dcwaiot/KU-WPT/2023/BOM List/ใบเสร็จ/ใบภาษี Coil.jpg

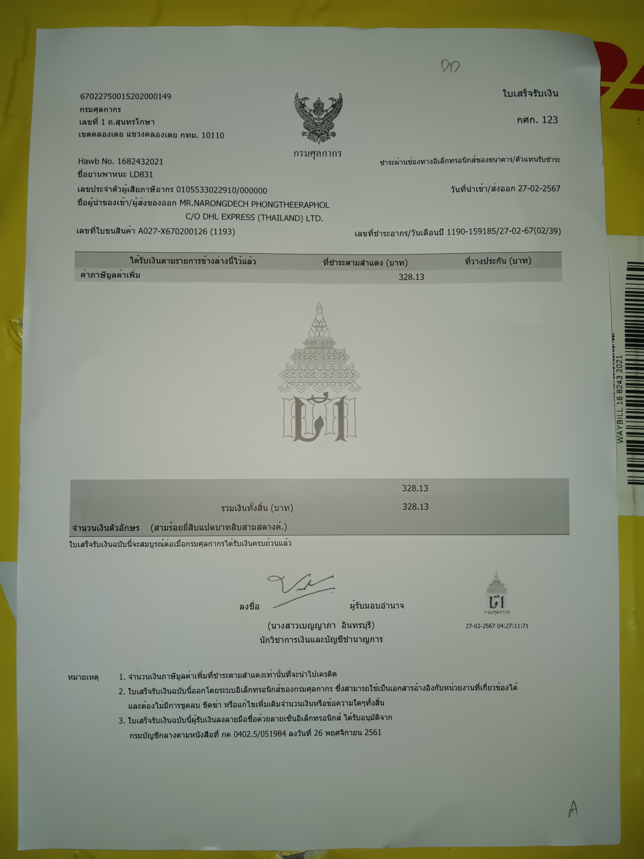
2023/BOM List/ใบเสร็จ/ใบภาษี Coil.jpg
