dcwaiot/KU-WPT/2022/data/VDO, Picture/Measure_Vdc.JPG

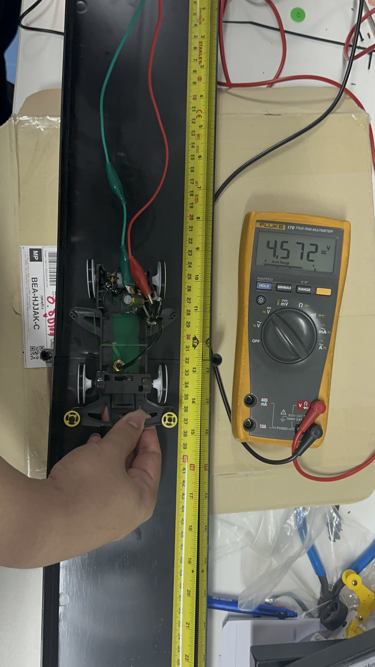
2022/data/VDO, Picture/Measure_Vdc.JPG
