dcwaiot/KU-WPT/2022/readme.md

This folder is for information for 2022 academic year.
แหล่งจัดเก็บข้อมูลที่เกี่ยวข้องของโครงงานวิศวกรรมไฟฟ้า KU-WPT ปี 2022
ประกอบไปด้วย 7 โฟลเดอร์ ดังนี้
1. ไฟล์สกุล s1p 1 Connector ได้มาจากการ export ชิ้นงาน ใน Sonnet Software
2. ไฟล์สกุล s2p 2 Connector ได้มาจากการ export ชิ้นงาน ใน Sonnet Software
3. Easyeda > Attenuator + TX Coil + RX Coil
4. Report + Poster + Summary
5. วิธีการลงโปรแกรม Sonnet + TX Coil 1 ชิ้น + TX Coil ต่อกัน 2 ชิ้น
6. VDO + Picture
7. ขั้นตอนการจัดทำ Coil + Attenuator และ BOM List
