dcwaiot/KU-WPT/2023/readme.md

# Wireless Power Transfer 2023
สำหรับใส่ข้อมูลทั้งหมดของ Senior Project ปีการศึกษา 2566 (2023)
