dcwaiot/KU-WPT/2023/Report,poster,summary,presentation/EE2023DCW-02_poster.pdf

# พลวัต

วั

# ของรถยนต์พ

ต์

ลัง
ลั

# งานไฟฟ้า

ฟ้ | ไร้สร้

# ายขนาดเล็ก

# ล็ ในเชิง

ชิ

วิศวิ

# วกรรมไฟฟ้า

ฟ้

# The Dynamic of Mini Wireless Electric Energy Car in Electrical Engineering

# ภาควิช

วิ

# าวิศ

วิ

# วกรรมไฟฟ้า

ฟ้

# คณะวิศ

วิ

# วกรรมศาสตร์ มหาวิท

วิ

# ยาลัย

ลั

# เกษตรศาสตร์

# กรวิชวิ ญ์ รัง รั สาคร, ศุภ

ศุ

# กร ธัญ

ธั

# ญหาญ, ศุภ

ศุ

# กร พงษ์ธีร

ธี

# ะพล และ ผศ.ดร.เด่น

ด่

ชัย
ชั

# วรเศวต

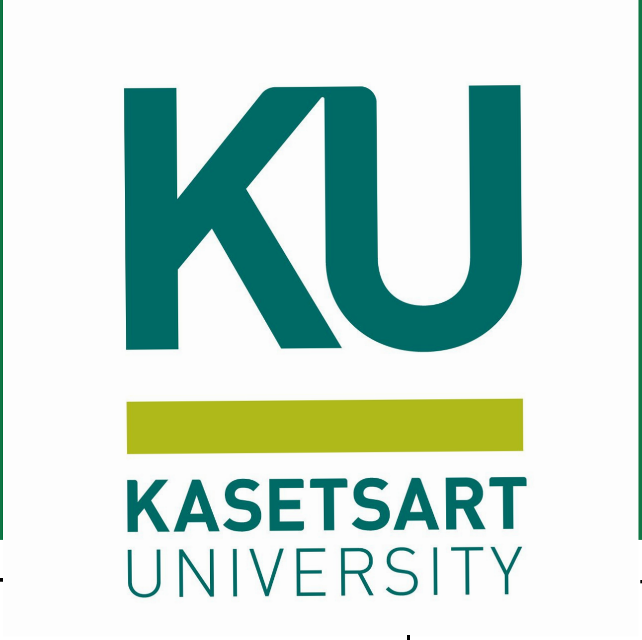
[picture p25: figure]

การคิดค้นรถยนต์พลังงานไฟฟ้า
ฟ้

เพื่อ
พื่

แก้ไขปัญหาขาดแคลนน้ำ มันมั และสภาวะโลกร้อ
ร้

น ได้เ
ด้

ริ่มริ่ ต้นจากปัญหาการเผาไหม้เ
ม้

ชื้อ
ชื้

เพลิงที่ส่ง
ส่

ผลให้ค
ห้

วันวั ไอเสีย
สี

ออกมาจากท่อของรถยนต์ส่่ง

ส่่
ปัจจุบันบั มีก
มี
ารพัฒพั | นารถยนต์พลังงานไฟฟ้า
ฟ้ | โดย
ใช้ร
ช้

ะบบรับรั -ส่ง
ส่

พลังงานไฟฟ้า
ฟ้

แบบไร้ส
ร้

าย เพื่อ

พื่ | ประหยัดยั | เวลาในการชาร์จร์ | ประจุไฟฟ้า
ฟ้ | โครงงานวิศวิ | วกรรมไฟฟ้า
ฟ้

ชื่อ
ชื่ "Demonstration of Resonant Wireless Power Transfer using Toy Racing Cars and Tracks" โดย Wisessri และ Promsatarporn (2022) มีข้
| | มี อ ข้
จำ กัดที่ยังยั | ไม่ส
| | | ม่
ามารถขับขั | เคลื่อนได้บ
ด้

นเส้น
ส้

ทางโค้งและยังยั ไม่มี
ม่

ค
มี
วามเสถียรและสมรรถนะในการขับขั | เคลื่อนของรถยนต์ไฟฟ้า
ฟ้ | ไร้ส
ร้

ายอย่า
ย่

งเพีย
พี

งพอ
โครงงานนี้ส

นี้
ามารถนำ ไปประยุกต์ใช้ใช้

นระบบคมนาคมขนส่ง

| | ส่ เพื่อ พื่
| | ชาร์จร์ | ประจุไฟฟ้า
ฟ้ | ให้ย
ห้
านพาหนะในขณะที่ยานพาหนะกำ ลังขับขั | เคลื่อนอยู่ โดยไม่ต้
ม่ | ต้
องจอดยานพาหนะหยุดนิ่งนิ่ | มีปมี
ระโยชน์ต่น์ | ต่

อยานพาหนะที่ต้องการใช้ง
ช้

านอย่า
ย่

งเร่ง
ร่

ด่ว
ด่

น เช่น
ช่

รถพยาบาลหรือ
รื

รถไฟฟ้า
| ฟ้

ขนส่ง

| | ส่ มวลชนในช่ว ช่ | งเวลาที่มีก มี ารเคลื่อนย้า
ย้

ยมวลคนมากๆ เช่น
ช่

ช่ว
ช่

งเวลาเช้า
ช้

และเย็น
ย็
ที่มีผู้
มี | โผู้ดยสารจำ นวนมากเดินดิ | ทางไปทำ งานหรือ
รื

กลับบ้า
บ้

นที่พักพั ได้ส
ด้

ะดวกขึ้น
ขึ้

วัต
วั

ถุป

ถุ

ระสงค์
สามารถส่ง
ส่

กำ ลังไฟฟ้า
ฟ้

แบบไร้ส
ร้

ายได้อ
ด้

ย่า
ย่
งมีปมี | ระสิทสิ | ธิภธิ | าพ
โมเดลรถสามารถเคลื่อนที่ได้อ
ด้

ย่า
ย่

งเสถียรและสามารถเคลื่อนที่ตามทิศทางของรางได้
สามารถออกแบบอุปกรณ์หณ์ | รือรื | ชิ้นชิ้ | ส่ว
ส่
นต่างๆเพื่อพื่ | นำ ไปประยุกต์ใช้ใช้
นงานที่ระดับดั | ใหญ่ขึ้
ญ่ | ขึ้
น
| | ขึ้ | ได้
ขอบเขตของโครงงาน
โครงงานนี้จ

นี้
ะแสดงให้เ
ห้

ห็น
ห็

ว่า
ว่

การส่ง
ส่

กำ ลังไฟฟ้า
ฟ้

แบบไร้ส
ร้

ายสามารถทำ ได้จ
ด้
ริงริ | และมีปมี | ระสิทสิ | ธิภธิ | าพ โดยใช้ข ช้ ดลวด
เป็นอุปกรณ์ใณ์ | นการรับรั | -ส่ง
ส่

กำ ลังไฟฟ้า
ฟ้

ซึ่ง

ซึ่ โมเดลรถจะเคลื่อนที่ได้อ
ด้

ย่า
ย่

งเสถียรและสามารถเคลื่อนที่ตาม ทิศทางของรางได้ โดยตัววงจรของโครงงานครั้งรั้ นี้จ

นี้
ะแสดงให้เ
ห้

ห็น
ห็
ดังดั | ภาพ

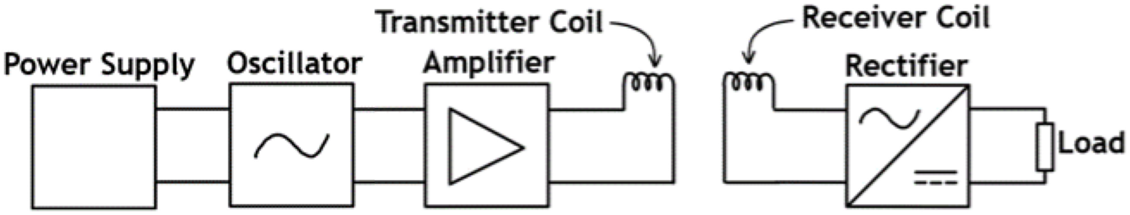
[picture p26: figure]

วิธีวิ | ก
ธี
ารดำ เนินนิ | โครงงาน

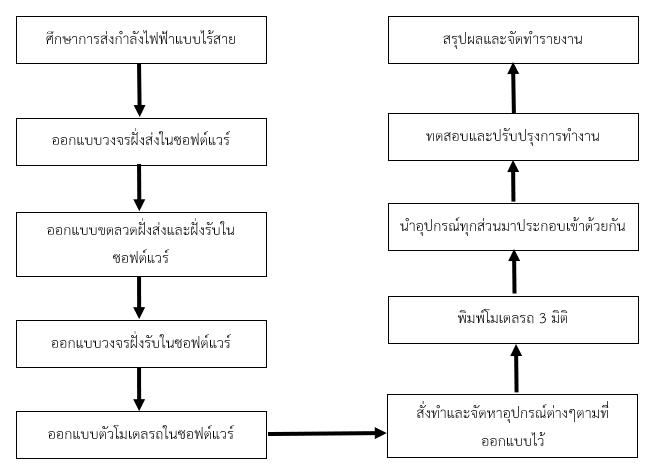
[picture p27: figure]

ผลการดำ เนินนิ | โครงงาน

ทฤษฎีที่เกี่ยวข้อ
ข้

ง
ในโครงงานนี้ไนี้
ด้ใด้

ช้ท
ช้

ฤษฎีต่างๆ ในการออกแบบระบบส่ง
ส่

กำ ลังไฟฟ้า
ฟ้

แบบไร้ส
ร้

ายซึ่ง

ซึ่ | ใช้ข
ช้

ดลวดฝั่งส่ง
ส่

หรือรื
Transmitter Coil ส่ง
ส่ | ไปยังยั | ขดลวดฝั่งรับรั | หรือรื | Receiver Coil แบบไร้ส ร้ ายที่ความถี่ 13.56MHz โดยใช้ท
ช้

ฤษฎี

ต่างๆ ดังดั นี้
ทฤษฎีคลื่นแม่เ
ม่

หล็กไฟฟ้า
| ฟ้
จากกฎของแอมแปร์ เมื่อมื่ | มีกมี | ระแสไฟฟ้า
ฟ้ | ไหลในขดลวดจะทำ ให้เ
| | | | ห้ กิดสนามแม่เ ม่

หล็กขึ้น

ขึ้ โดยรอบขดลวด และหากสนาม แม่เ
ม่

หล็กนี้พุ่

นี้

พุ่

ง
พุ่

ผ่า
ผ่

นพื้นพื้ ที่หน้า
น้

ตัดของขดลวดอีกชุดหนึ่ง
นึ่

จะทำ ให้เ
ห้

กิดการเปลี่ยนของฟลักซ์แซ์ ม่เ
ม่

หล็ก (ฟลักซ์แซ์ ม่เ
ม่

หล็ก
คือปริมริ าณสนามแม่เ
ม่
หล็กในพื้นพื้ | ที่พื้นพื้ | ที่หนึ่ง
นึ่ | ) ซึ่ง
ซึ่

จะทำ ให้เ
ห้

กิดสนามไฟฟ้า
ฟ้

ขึ้น

ขึ้ | ในขดลวดชุดนั้นนั้ | ๆ ในขดลวดชุดดังดั | กล่าว
จะมีอิมี อิเล็กตรอนอยู่ เมื่อมื่ | เกิดสนามไฟฟ้า
ฟ้

จะทำ ให้เ
ห้

กิดแรงไฟฟ้า
ฟ้
กระทำ กับอิเล็กตรอนภายในขดลวด ดังดั | นั้นนั้ | อิเล็กตรอน
จะเกิดการเคลื่อนที่ไปตามขดลวด จึง
จึ

ทำ ให้เ
ห้

กิดกระแสไฟฟ้า
ฟ้

ขึ้น

ขึ้ | ในขดลวดชุดนั้นนั้ | ๆ

คุณ

คุ

สมบัติบั ติ ท่อนำ คลื่น
ทฤษฎี SMA
ขดลวด (Coil)

คุณ

คุ

สมบัติบั ติทางวัสวั ดุข

ดุ

อง FR4 PCB
วงจรเรียรี งกระแส (Rectifier Circuit)

Transmitter Coil (TX Coil) - ขดลวดฝั่งส่ง

ส่ Receiver Coil (RX Coil) - ขดลวดฝั่งรับรั

วัด
วั

ค่าความต้านทานของขดลวด

มีวัมี | ตวั | ถุป

ถุ

ระสงค์เพื่อพื่ | หาค่า ความต้านทานจินจิ | ตภาพเหนี่ยวนำ เพราะ Coil มีคุมี | ณ

คุ

สมบัติบั ติเป็น
ป็

ขดลวดเหนี่ย

นี่
วนำ เพื่อพื่
ต้องการให้ไห้

ด้ก
ด้

ระแสไฟฟ้า

ฟ้ ในวงจรสูง

สู

สุด

สุ

จึง
จึ
ต้องการปรับรั | ให้ค่
ห้ | ค่
าความต้านทานจินจิ | ตภาพของอุปกรณ์เณ์ | ป็น
ป็

ศูนย์
โดยการนำ ตัวเก็บประจุไฟฟ้า
ฟ้
มาต่ออนุกรม โดยที่ตัวเก็บประจุมีคมี | วามต้านทานจินจิ | ตภาพเป็น
ป็
จำ นวนจินจิ | ตภาพลบ
เรียรี | กว่า
ว่ | Series Resonance Effect

อุปกรณ์ที่ณ์ ที่ใช้ใช้
นการวัดวั | ค่า เรียรี | กว่า
ว่ | Vector Network Analyzer

ซึ่ง
ซึ่

จะแสดงผลลัพธ์ใธ์ ห้เ
ห้

ห็น

ห็ ในรูป

รู

แบบ Smith Chart หากจุดไปแสดงที่ตำ แหน่งซ้า
ซ้

ยสุด

สุ

คือ Short Circuit
หากจุดไปแสดงที่ตำ แหน่งขวาสุด

สุ

คือ Open Circuit หากจุดอยู่ใยู่

นซีกซี | บนของกราฟ อุปกรณ์จณ์ | ะมีคุมี | ณ

คุ

สมบัติบั ติ
เป็น
ป็
ขดลวดเหนี่ยวนำ | แต่หากจุดอยู่ใยู่
นซีกซี | ล่างของกราฟ อุปกรณ์จณ์ | ะมีคุมี | ณ

คุ

สมบัติบั ติเป็น
ป็

ตัวเก็บประจุไฟฟ้า
ฟ้

การติดตั้งตัวเก็บประจุ (Capacitor)
การวัดวั ค่าความต้านทานของ RX Coil ด้ว ด้ ย Vector Network Analyzer พบว่า
ว่

เหมาะสมที่สุด

สุ

กับการใช้ง
ช้

านที่
ความถี่ 13.56 MHz เมื่อมื่ | ต่อ Capacitor 62 pF เข้า
ข้ | ไปแล้ว ยังยั | เหลือค่าความต้านทานจินจิ | ตภาพอันเนื่อนื่ | งมาจาก

C ที่น้อยไป อยู่ที่

ยู่ ที่-j203.3 ซึ่ง
ซึ่

คิดเป็น

ป็ | 58 pF ดังดั | นั้น
นั้

จึง
จึ

ขาดอีก 4 pF หากคุณ

คุ

สมบัติบั ติทางไฟฟ้า
ฟ้

ของ TX Coil
เหมือมื นกันกับ Test Coil

การวัด
วั

ค่ากำ ลังไฟฟ้า
ฟ้

บน RX Coil โดยวัด
วั

เทียบจากผลต่างมุม 15 องศา บนขดลวด TX Coil ในการวัดวั ค่ากำ ลังไฟฟ้า
ฟ้

บน RX Coil โดยวัดวั เทียบจากผลต่างมุม 15 องศา บนขดลวด TX Coil โดยต่อเข้า
ข้

กับ
แหล่งกำ เนิดไฟฟ้า
ฟ้

กระแสตรง 13.0 V 0.34 A และกำ หนดจุดเริ่มริ่ ต้น คือ ขดลวดที่อยู่ติ

ยู่ ติดกันกับ Connector
เป็น
ป็
มุม 0 องศา แล้วเรียรี | งลำ ดับดั | การวัดวั | แบบตามเข็ม ข็ นาฬิกา

กำ ลังไฟฟ้า
ฟ้

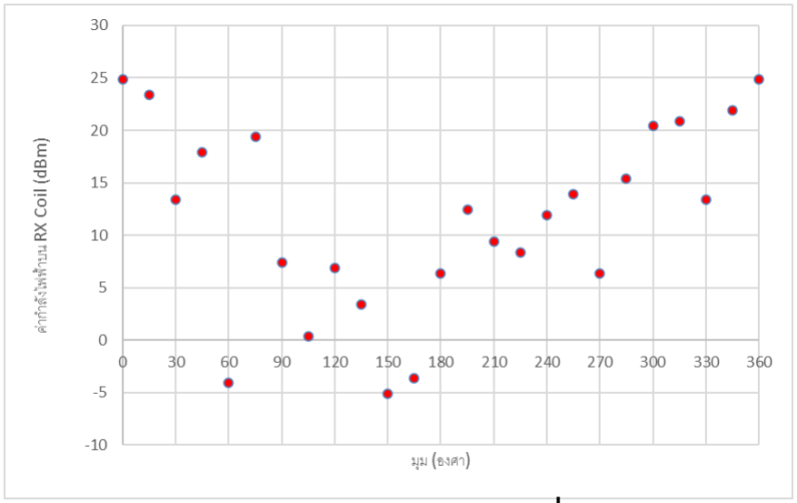
[picture p28: figure]

ของ RX Coil เทียบกับมุมบน TX Coil เมื่อมื่ | ขยับยั | RX Coil ไปทุก
ทุ | ๆ 15 องศา

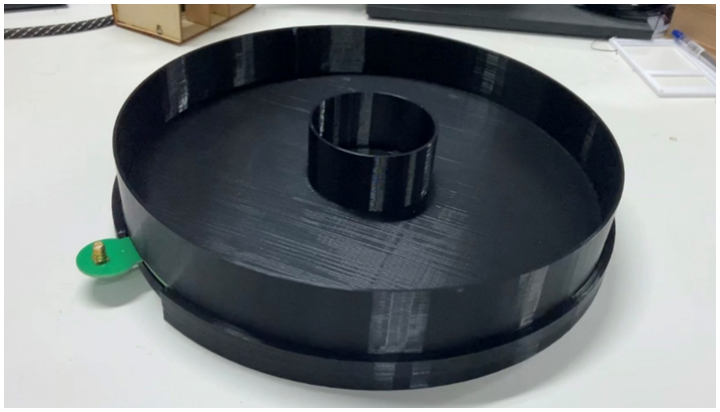
[picture p29: figure]
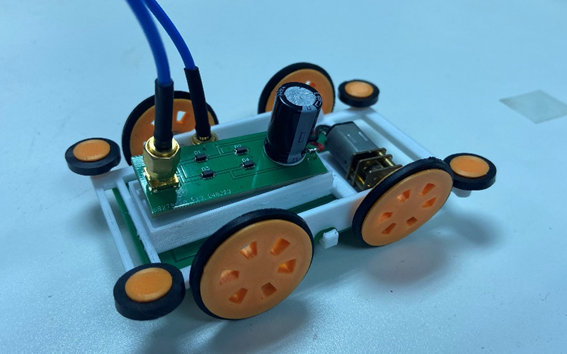
[picture p30: figure]

โมเดลรถที่ประกอบสมบูรณ์แล้ว | ตัวรางที่ประกอบสมบูรณ์แล้ว
สรุปผลการดำ เนินนิ | งานและข้อ
ข้

เสนอแนะ
DC Generator ทำ งานที่ 13 V 0.32 A ได้เ

ด้ ป็นอย่า
ย่
งดี Oscillator Circuit เมื่อมื่ | ปรับรั | ค่าจนได้กำ
ด้ | กำ

ลังไฟฟ้า
ฟ้

ขาออก

สูง

สู

สุด

สุ

และได้ค
ด้

วามถี่ 13.56 MHz ตามที่ต้องการ ทำ งานได้เ

ด้ ป็นอย่า
ย่
งดี Amplifier Circuit เมื่อมื่ | เชื่อชื่ | มต่อกับแหล่งจ่า
จ่

ย
ไฟฟ้า
ฟ้

กระแสตรง 13 V พบว่า
ว่

เกิดความร้อ
ร้
นขึ้นขึ้ | มา แต่ยังยั | คงสามารถเพิ่มพิ่ | กำ ลังไฟฟ้า
ฟ้ | ได้ SMA Cable มีคมี | วามยาวไม่ม
ม่

าก
เกินไป และเมื่อมื่ ใช้ง
ช้

านกับไฟฟ้า
ฟ้
กระแสสลับความถี่ต่ำ จึงจึ | เกิดการสูญสู
เสียสี | ต่ำ | โดยทำ งานได้เ
ด้ | ป็น
ป็

อย่า
ย่

งดี
SMA Connector มีกมี | ารเชื่อชื่ | มต่อเข้า
ข้

กับ Coil และ Rectifier Circuit ได้เ

ด้ ป็น
ป็

อย่า
ย่

งดี ไม่ห
ม่

ลุด

ลุ

หลวม การ
บัดบั | กรีใรี | นส่ว
ส่

นต่างๆ ทำ ได้เ

ด้ ป็น
ป็

อย่า
ย่
งดี จุดเชื่อชื่ | มต่อมีคมี | วามแข็ง
ข็
แรง เชื่อชื่ | มต่อทางไฟฟ้า
| ฟ้ | ได้อ ด้

ย่า
ย่

งมีเมี สถียรภาพ TX Coil
ขดลวดที่อยู่ใยู่

กล้ SMA Connector มีกมี ารส่ง
ส่

กำ ลังไฟฟ้า
ฟ้

ที่มาก ส่ว
ส่

นขดลวดที่อยู่ไยู่

กลจาก SMA Connector มีกมี าร

ส่ง
ส่

กำ ลังไฟฟ้า
ฟ้

ลดต่ำ ลง
บริเริ วณรอยต่อระหว่า
ว่

งขดลวดบางส่ว
ส่

น มีกมี ารออกแบบระยะห่า
ห่

งไม่ส
ม่
ม่ำ เสมอ จึงจึ | ทำ ให้มี
| | ห้
| | กมี | ารเหนี่ย นี่
วนำ ในบางบริเริ | วณลด

น้อ
น้

ยลง แต่ RX Coil, TX Coil, Rectifier Circuit ในภาพรวมทำ งานได้ดี

ด้ ดี | โดยที่มีแมี | รงดันดั | ตกคร่อ ร่
มที่ไดโอดในระดับดั | ที่
ใช้ไช้
ด้ ซึ่งซึ่ | ไดโอดเกิดความผิดผิ | ปกติเล็กน้อ
น้

ยเมื่อมื่ ใช้ง
ช้

านกับไฟฟ้า
ฟ้

กระแสสลับความถี่สูง

สู

Capacitor ทำ การเก็บประจุไฟฟ้า
ฟ้
และส่ง
ส่

พลังงานให้แ
ห้

ก่มอเตอร์ไร์ ฟฟ้า
ฟ้

กระแสตรง ได้เ

ด้ ป็นอย่า
ย่

งดี
DC Motor มีคมี | วามเร็ว
ร็ | ในการหมุนสูง

สู

ซึ่งซึ่ ได้รั
ด้

บรั พลังงานไฟฟ้า
ฟ้

และได้รั
ด้
บรั | แรงดันดั | ไฟฟ้า
ฟ้

มากเพียพี งพอที่จะใช้ง
ช้

านกับ
มอเตอร์ชร์ | นิดนิ | นี้ไนี้
ด้ ด้ว
ด้

ยเหตุนี้

ตุ

จึ

นี้
งจึ ทำ ให้ร
ห้

ถสามารถวิ่งวิ่ บนรางได้ค
ด้

รบรอบวงกลมและสามารถวิ่งวิ่ ต่อไปได้เ
ด้

รื่อรื่ ยๆ โดยไม่ห
ม่

ยุด

ข้อ
ข้

เสนอแนะเพิ่มพิ่ เติม
Test Coil ควรจะออกแบบ Coil และ Connector ให้เ
ห้
หมือมื | นกันทั่งทั่ | ฝั่งซ้า
ซ้

ยและขวา
เพิ่มพิ่ ทางเลือกในการออกแบบคือ ออกแบบ Coil และ Connector ด้ว
ด้

ย Copper Area โดยกำ หนด Net = GND
ออกแบบให้ Copper Bottom Layer บริเริ | วณรอบๆ PAD ที่มีสัมี | ญสั | ญาณ ล้อมรอบ PAD ในรูป

รู

แบบวงกลม

ได้มี
ด้

กมี ารใช้ Footprint SMA Connector โดย 4 PAD รอบๆทำ หน้า
น้

ที่เป็น

ป็ GND และ PAD ตรงกลางทำ
หน้า
น้

ที่เป็น
ป็

ช่อ
ช่

งทาง Signal
เพิ่มพิ่ | พื้นพื้ | ที่บัดบั | กรีสำรี | สำหรับรั | Capacitor ใน Test Coil และ Rx Coil
ทดสอบ Export Gerber File จาก Easyeda แล้วนำ มา Import Gerber File เข้า
ข้ | ไปใน Sonnet เพื่อพื่
Simulation สำ หรับรั | หาค่า L
ออกแบบ Rx Coil ใน Sonnet ให้มี
| | | | | ห้
ขมี | นาดแม่น
| | | | | ม่

ยำ มากที่สุด

สุ

ตามที่ต้องการ และเพิ่มพิ่ | Connector เข้า
ข้ | ไปด้ว
ด้

ย

### บรรณานุก

นุ

รม | T. Wisessri and C. Promsatarporn,
''Demonstration of Resonant Wireless Power Transfer using Toy Racing Cars and Tracks,

'' B.Eng. Senior Project, Kasetsart University, Thailand, 2022.
C. Rakluea, A. Worapishet, S. Chaimool, Y. Zhao, and P. Akkaraekthalin,

“True nulls-free magnetoinductive waveguides using alternate coupling polarities for batteryless dynamic wireless power transfer applications,

” IEEE Trans. Power Electron., vol. 37, no. 8, pp. 8835–8854, 2022.
“วงจรเรียรี งกระแส คืออะไร?,

” ช่า
ช่
งไฟดอทคอม | ทีมงานช่า
ช่

งไฟฟ้า
ฟ้

ที่ดีที่ดี ที่
สุดสุ | ในกรุงรุ | เทพฯ, 18-Nov-2021. [Online]. Available: https://www.changfi.com/fix/2021/11/18/14296/. [Accessed: 11-Oct-2023].
Digikey.co.th. [Online]. Available: https://www.digikey.co.th/th/articles/the-smith-chart-an-ancient- graphical-tool-still-vital-in-rf-design. [Accessed: 29-Mar -2024].

L ของ Test Coil = 2.16 uH
ค่า S21 = -21dB phase 122.5 degrees S11 ~ 0dB 30.5degrees

ต้องหาค่า C ที่มีค่มี ค่

า XC = XL ที่ 13.56 MHz
ต้องเลือกซื้อซื้ | Capacitor 0805 ที่มีคุมี | ณ

คุ

สมบัติบั ติ | Ultra Low ESR + HighQ lowloss
และ Tx Coil มีคุมี | ณ

คุ

สมบัติบั ติ | ดังดั | นี้
L = 2.16 uH XL = 184 ohm C = 63.8 pF
ต้องใช้ C = 62 pF 7 ชิ้นชิ้ | สำ หรับรั | Tx Coil และ 2 ชิ้นชิ้ | สำ หรับรั | Test Coil

L ของ Rx Coil = 0.763 uH
ต้องใช้ C = 180 pF 1 ชิ้นชิ้ | สำ หรับรั | Rx Coil
