dcwaiot/KU-WPT/2023/Report,poster,summary,presentation/EE2023DCW-02_report.pdf

# โครงงานวิศวกรรมไฟฟา ภาควิชาวิศวกรรมไฟฟา คณะวิศวกรรมศาสตร มหาวิทยาลัยเกษตรศาสตร

# เรื่อง

# พลวัตของรถยนตพลังงานไฟฟาไรสายขนาดเล็กในเชิงวิศวกรรมไฟฟา The Dynamic of Mini Wireless Electric Energy Car in Electrical Engineering

# โดย

# กรวิชญ รังสาคร 6310551400 ศุภกร ธัญญหาญ 6310551884 ศุภกร พงษธีระพล 6310551892

พ.ศ. 2566

### พลวัตของรถยนตพลังงานไฟฟาไรสายขนาดเล็กในเชิงวิศวกรรมไฟฟา The Dynamic of Mini Wireless Electric Energy Car in Electrical Engineering

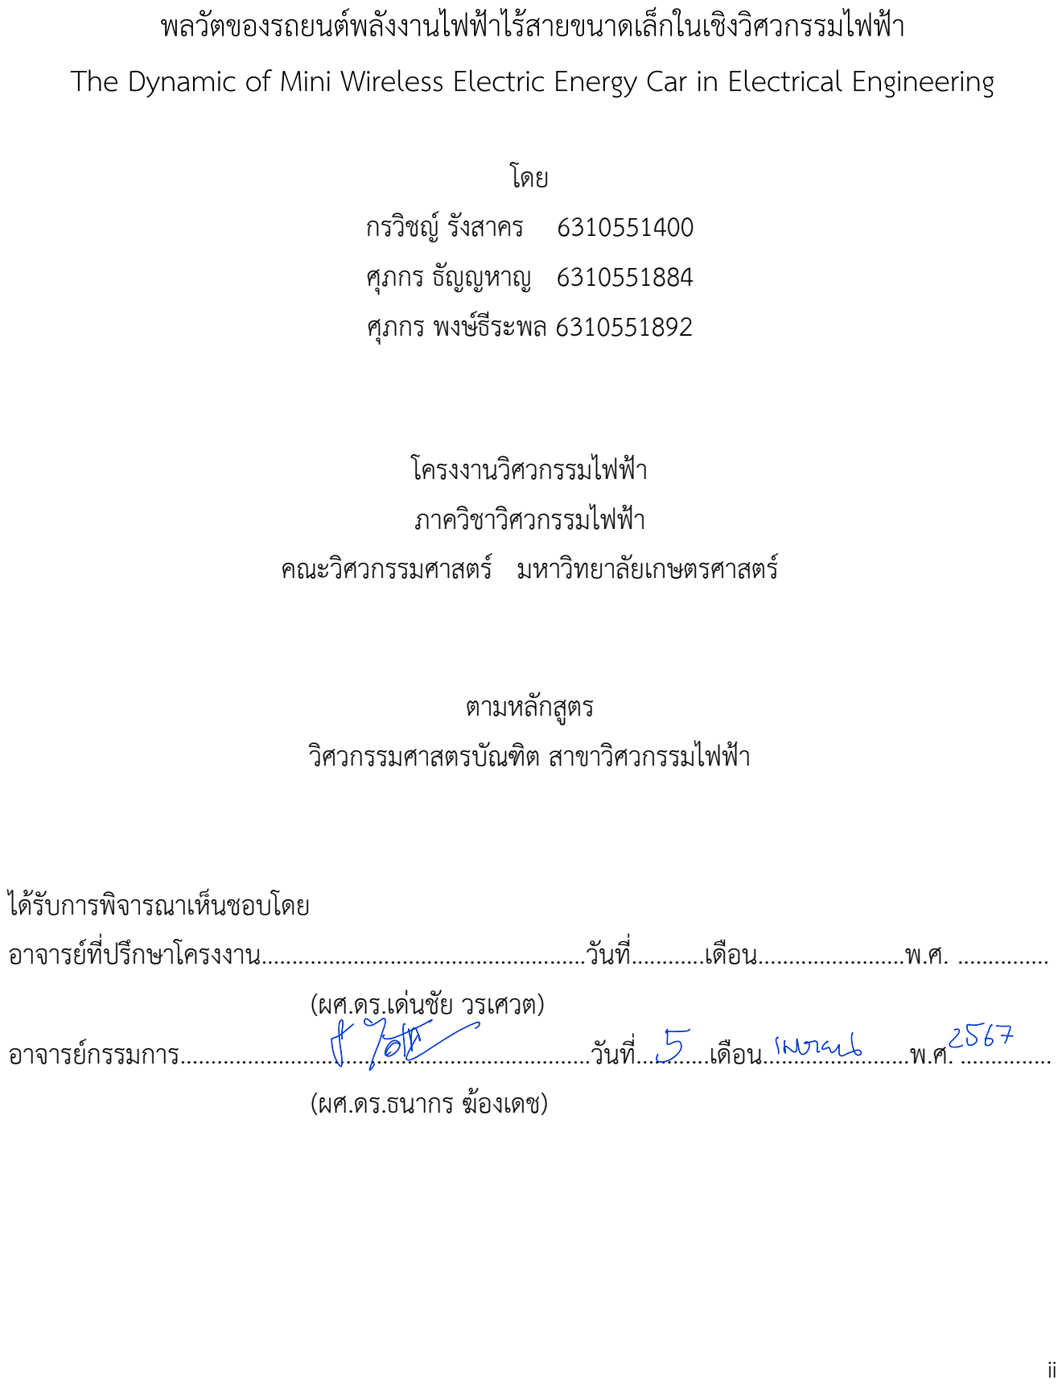
[picture p31: page 2]

ii

โดย
กรวิชญ รังสาคร 6310551400 ศุภกร ธัญญหาญ 6310551884
ศุภกร พงษธีระพล 6310551892

โครงงานวิศวกรรมไฟฟา
ภาควิชาวิศวกรรมไฟฟา
คณะวิศวกรรมศาสตร มหาวิทยาลัยเกษตรศาสตร

ตามหลักสูตร
วิศวกรรมศาสตรบัณฑิต สาขาวิศวกรรมไฟฟา

ไดรับการพิจารณาเห็นชอบโดย
อาจารยที่ปรึกษาโครงงาน | วันที่ | เดือน | พ.ศ |
(ผศ.ดร.เดนชัย วรเศวต)
อาจารยกรรมการ | วันที่ | เดือน | พ.ศ |
(ผศ.ดร.ธนากร ฆองเดช)

iii

กรวิชญรังสาคร | ปการศึกษา 2566
ศุภกร ธัญญหาญ | ปการศึกษา 2566
ศุภกร พงษธีระพล ปการศึกษา 2566 พลวัตของรถยนตพลังงานไฟฟาไรสายขนาดเล็กในเชิงวิศวกรรมไฟฟา ปริญญาวิศวกรรมศาสตรบัณฑิต (สาขาวิศวกรรมไฟฟา) ภาควิชาวิศวกรรมไฟฟา คณะวิศวกรรมศาสตรมหาวิทยาลัยเกษตรศาสตร

บทคัดยอ

โครงงานวิศวกรรมไฟฟาฉบับนี้ กลาวถึงการสงกำลังไฟฟาแบบไรสายโดยใชทฤษฎีคลื่นแมเหล็กไฟฟาในกฎของ แอมแปรผานขดลวดสองชุด โดยจะแสดงใหเห็นผานการเคลื่อนที่ของโมเดลรถ ซึ่งจะแบงวงจรเปน 3 สวนไดแก สวนแรก คือวงจรฝงสงกำลังไฟฟา จะมีการใชแรงดันขนาด 13 โวลตเปนกระแสสลับโดยใชความถี่ 13.56 MHz รวมถึงมีการขยาย สัญญาณเพื่อเพิ่มขนาดกำลังไฟฟาไปยังขดลวดฝงสงเพื่อใหเหมาะสมในการสงกำลังไฟฟา สวนที่สองคือขดลวดทั้งฝงสง-ฝง รับกำลังไฟฟาเปนสวนที่สำคัญในการสงกำลังไฟฟาโดยใชทฤษฎีคลื่นแมเหล็กไฟฟาในการสงกำลังไฟฟา โดยขดลวดฝงสง จะติดอยูกับตัวราง และขดลวดฝงรับจะติดอยูใตทองรถ ซึ่งใชโปรแกรม Sonnet ในการออกแบบ โดยสามารถสง กำลังไฟฟาไดสูงสุด 4.16 วัตต และสวนสุดทายวงจรฝงรับกำลังไฟฟาจะมีการใชวงจรเรียงกระแสเพื่อแปลงไฟฟา กระแสสลับเปนไฟฟากระแสตรง เนื่องจากกำลังที่สงมาเปนกระแสสลับจึงตองแปลงเปนกระแสตรงเพื่อใหสามารถใชกับ มอเตอรกระแสตรงที่ใชขับเคลื่อนลอรถได โดยใชมอเตอร 1 ตัวเพื่อขับเคลื่อนลอหลังทางดายซาย และมีการใชตัวเก็บ ประจุเพื่อเปนตัวเก็บพลังงานที่จะใชจายเขามอเตอร ซึ่งโครงงานนี้เปนการตอยอดจากโครงงานวิศวกรรมไฟฟาในหัวขอ Demonstration of Resonant Wireless Power Transfer using Toy Racing Cars and Tracks (Tanit Wisessri and Chatpisut Promsatarporn,2022) แตเดิมนั้นตัวรถสามารถเคลื่อนที่ไดในทางตรงเทานั้นและไมเสถียรมากนักจึงนำ โครงงานดังกลาวมาตอยอดใหตัวรถสามารถเคลื่อนที่ไดทั้งทางตรงและทางโคงหรือทิศทางใดก็ไดตามทิศของรางและ สามารถเคลื่อนไดอยางราบรื่นและเสถียรและยังสามารถวัดคุณภาพของชิ้นงานไดจากการหาคากำลังไฟฟา

คำสำคัญ การสงพลังงานไฟฟาแบบไรสาย, ทฤษฎีคลื่นแมเหล็กไฟฟา, พลวัตของรถยนต, ทอนำคลื่นแบบเหนี่ยวนำ แมเหล็ก

เลขที่เอกสารอางอิงภาควิชา E5050-DCW-2-2566

iv

Koravich | Rungsakorn | Academic Year 2023
Supakorn | Tanyahan | Academic Year 2023
Supakorn | Phongtheeraphol | Academic Year 2023
The Dynamic of Mini Wireless Electric Energy Car in Electrical Engineering Bachelor’s degree in electrical engineering Department of Electrical Engineering
Faculty of Engineering, Kasetsart University
Abstract
This senior project report presents wireless transfer power by using Electromagnetic Wave Theory in Ampere's Law to use the 2 sets of coils. It is shown by car model driving. There are 3 parts of this project. The first is a power transmitter circuit using 13 volts in alternating current and used frequency of 13.56 MHz. And increased power of a signal to the transmitter coil for suitability in wireless transfer power. The next is the 2 sets of coils, the transmitter coil and the receiver coil. They are very important things in wireless transfer power by using Electromagnetic Wave Theory. The transmitter coil dovetails with the track and the receiver coil dovetails with the car model. The software that used to design the 2 sets of the coils is Sonnet. And maximum power that can transfer in wireless is 4.16 watts. The last part is the receiver circuit, which uses a rectifier circuit to convert alternating current to direct current because the coils transfer the power in alternating current and have to convert it to direct current to combine with the direct current motor to drive the wheels by using the motor to drive the left rear wheel. This project developed from a graduated senior project on the topic of Demonstration of Resonant Wireless Power Transfer using Toy Racing Cars and Tracks (Tanit Wisessri and Chatpisut Promsatarporn,2022). At first, the car model can drive in a straight line only and it's not stable. This project improved the car model driving. It can drive along the track in both the straight line and the curved line or along the track in all directions and it can drive stably. And can check the quality of this work by electric power calculating.

Keywords: Wireless Power Transfer, Electromagnetic Wave Theory, The Dynamic of Car, Magneto-
| inductive waveguide

Department Reference No E5050-DCW-2-2566

v

## กิตติกรรมประกาศ

โครงงานนี้สำเร็จลุลวงลวงไดดวยความกรุณาจาก ผศ.ดร.เดนชัย วรเศวต ผูเปนอาจารยที่ปรึกษาโครงงานที่ไดให ขอเสนอ แนวคิดรวมถึงการ การแกไขขอบกพรองตางๆ ผูจัดทำจึงขอขอบพระคุณเปนอยางสูง
ขอบพระคุณ ผศ.ดร.ธนากร ฆองเดช ที่ใหเกียรติมาเปนอาจารยกรรมการในการตรวจสอบโครงงานเพื่อใหนิสิต เขาใจความรูตางๆไดอยางสมบูรณ
ขอบพระคุณรุนพี่ที่ชวยเหลือและอำนวยความสะดวกตางๆ ในการใชหองปฏิบัติการรวมถึงขอมูลที่เปนประโยชนใน การทำโครงงานนี้รวมทั้งผูมีสวนเกี่ยวของทุกทานที่มีสวนชวยในการใหคำปรึกษาชี้แนะในโครงงานนี้

กรวิชญ รังสาคร
ศุภกร ธัญญหาญ
ศุภกร พงษธีระพล

ผูจัดทำ

vi

## สารบัญ

สารบัญ | VI
สารบัญภาพ | VIII
สารบัญตาราง | X
คำอธิบายสัญลักษณและคำยอ | XI

vii

viii

## สารบัญภาพ

ภาพที่ 19 Reflection Coefficient – f of Wireless Electric Energy Transmitter – Receiver Single Coil

ภาพที่ 20 Reflection Coefficient – f of Wireless Electric Energy Transmitter – Receiver Double Coil

ix

x

## สารบัญตาราง

xi

## คำอธิบายสัญลักษณและคำยอ

m | แสดงถึง | milli คือ คำอุปสรรคที่มีคา 10⁻³
µ | แสดงถึง | micro คือ คำอุปสรรคที่มีคา 10⁻⁶
p | แสดงถึง | pico คือ คำอุปสรรคที่มีคา 10⁻¹²
M | แสดงถึง | Mega คือ คำอุปสรรคที่มีคา 10⁶
V | แสดงถึง | Volt หรือ Voltage
Hz | แสดงถึง | Hertz
W | แสดงถึง | Watt
A | แสดงถึง | Ampere
Ω | แสดงถึง | Ohms
H | แสดงถึง | Henry
F | แสดงถึง | Farad
f | แสดงถึง | Frequency
XC | แสดงถึง | Capacitive Reactance
XL | แสดงถึง | Inductive Reactance
GND | ยอมาจาก | Ground
PCB | ยอมาจาก | Printed Circuit Board
AC หรือ ac ยอมาจาก | Alternating Current
DC หรือ dc ยอมาจาก | Direct Current
TX Coil | ยอมาจาก | Transmitter Coil หรือ ขดลวดฝงสง
RX Coil | ยอมาจาก | Receiver Coil หรือ ขดลวดฝงรับ

1

## 1 บทนำ

เนื่องจากปญหาขาดแคลนน้ำมัน และปญหาสภาวะโลกรอน สาเหตุหนึ่งเกิดมาจากการเผาไหมเชื้อเพลิง เชน น้ำมัน ทำใหเกิดควันไอเสียออกมาจากทอของรถยนตสันดาป จึงมีการคิดคนรถยนตพลังงานไฟฟาขึ้นมา เพื่อมาแกไข ปญหานี้ ซึ่งการกักเก็บพลังงานของรถยนตไฟฟาในปจจุบัน จำเปนตองมีเครื่องชารจประจุไฟฟาซึ่งติดตั้งอยูกับที่ และ เชื่อมตอเขากับรถยนตพลังงานไฟฟาดวยสายไฟฟา ซึ่งตองใชเวลามากพอสมควรในการกักเก็บพลังงานไฟฟาเขา แบตเตอรี่ของรถยนตพลังงานไฟฟา โครงงานวิศวกรรมไฟฟานี้ จึงไดออกแบบระบบรับ-สงพลังงานไฟฟาแบบไรสาย จึง ทำใหประหยัดเวลาในการชารจประจุไฟฟา ไมจำเปนตองจอดรถยนตพลังงานไฟฟาใหอยูนิ่ง เพื่อเชื่อมตอเขากับเครื่อง ชารจประจุไฟฟา เหมือนอยางเดิมอีกตอไป โครงงานวิศวกรรมไฟฟานี้ เปนสวนตอยอดมาจากโครงงานวิศวกรรมไฟฟา ชื่อเรื่อง Demonstration of Resonant Wireless Power Transfer using Toy Racing Cars and Tracks (Wisessri and Promsatarporn, 2022) ซึ่งมีขอจำกัดที่ ความเสถียรและสมรรถนะในการขับเคลื่อนของรถยนตพลังงานไฟฟาไร สาย ยังไมเพียงพอ และ สามารถขับเคลื่อนไดบนเสนทางตรง แตยังไมสามารถขับเคลื่อนบนเสนทางโคงได[1:62] โครงงานนี้สามารถนำไปประยุกตใชในระบบคมนาคมขนสง โดยการติดตั้งขดลวดสงพลังงานไฟฟาไรสาย ใตพื้นถนน และ ติดตั้งขดลวดรับพลังงานไฟฟาไรสาย บริเวณใตทองรถยนตพลังงานไฟฟาไรสาย หรือนำขดลวดสงพลังงานไฟฟาไรสาย ไปติดตั้งใตรางรถไฟฟาขนสงมวลชน และ นำขดลวดรับพลังงานไฟฟาไรสาย ไปติดตั้งบริเวณใตทองรถไฟฟาขนสงมวลชน ทำใหสามารถชารจประจุไฟฟาใหแกยานพาหนะ ในขณะที่ยานพาหนะกำลังขับเคลื่อนอยูได โดยไมตองจอดยานพาหนะ หยุดนิ่ง และชารจประจุไฟฟาเขากับยานพาหนะ ซึ่งตองใชเวลานาน ซึ่งจะมีประโยชนอยางมากสำหรับยานพาหนะที่ ตองการใชงานอยางเรงดวน เชน รถพยาบาล ซึ่งการใชเวลาเดินทางที่นอย มีความสำคัญมากตอการรอดชีวิตของผูปวย หรือ รถไฟฟาขนสงมวลชน ที่มีความตองการใชงานอยางหนักและตอเนื่องในชั่วโมงเรงดวน เชน ชวงเวลาเชา ที่มี ผูโดยสารจำนวนมาก เดินทางไปยังสถานที่ทำงาน และ ชวงเวลาเย็นที่มีผูโดยสารจำนวนมาก เดินทางกลับที่พัก

### 1.1 วัตถุประสงคของโครงงาน

- สามารถสงกำลังไฟฟาแบบไรสายไดอยางมีประสิทธิภาพ
- โมเดลรถสามารถเคลื่อนที่ไดอยางเสถียรและสามารถเคลื่อนที่ตามทิศทางของรางได
- สามารถออกแบบอุปกรณหรือชิ้นสวนตางๆเพื่อนำไปประยุกตใชในงานที่ระดับใหญขึ้นได

### 1.2 ขอบเขตของโครงงาน

โครงงานนี้จะแสดงใหเห็นวาการสงกำลังไฟฟาแบบไรสายสามารถทำไดจริงและมีประสิทธิภาพ โดยใชขดลวดเปน อุปกรณในการรับ-สงกำลังไฟฟา ขดลวดฝงสงจะติดที่รางของโมเดลรถและขดลวดฝงรับจะติดอยูกับตัวโมเดลรถและ

2

เชื่อมตอกับมอเตอรที่ขับเคลื่อนลอรถ ซึ่งโมเดลรถจะเคลื่อนที่ไดอยางเสถียรและสามารถเคลื่อนที่ตามทิศทางของรางได โดยตัววงจรของโครงงานครั้งนี้จะแสดงใหเห็นดังภาพที่ 1

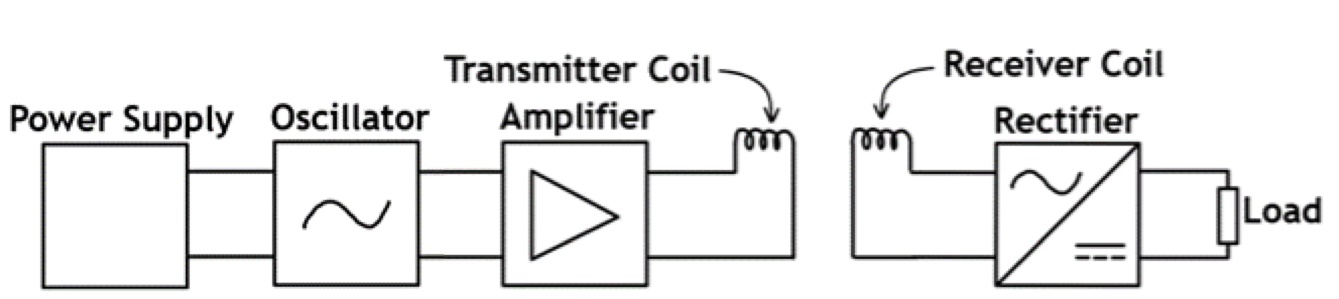
[picture p32: figure]

ภาพที่ 1 วงจรสงกำลังไฟฟาแบบไรสายที่ใชในโครงงานนี้

จากภาพที่ 1 จะแบงวงจรเปน 3 สวน ไดแก
1) วงจรฝงสง ประกอบดวย
- Power Supply คือแหลงจายไฟ ซึ่งจะจายแรงดัน 13V
- Oscillator คือเครื่องกำเนิดสัญญาณไฟฟากระแสสลับ ซึ่งใชความถี่ 13.56MHz
- Amplifier คืออุปกรณขยายสัญญาณ เพื่อใหมีกำลังไฟฟามากพอที่จะสงกำลังไฟฟาแบบไรสายได
2) ขดลวดฝงสงและฝงรับ จากการออกแบบและจำลองในซอฟตแวรพบวาสามารถสงกำลังไฟฟาไดมากที่สุด 4.16 W
3) วงจรฝงรับ ประกอบดวย
- วงจรเรียงกระแสประเภทเต็มคลื่นแบบบริดจ (Full Wave Bridge Rectifier Circuit) เพื่อแปลงไฟฟากระแส สลับเปนไฟฟากระแสตรง เนื่องจากมอเตอรที่ขับเคลื่อนลอรถเปนมอเตอรกระแสตรง
- ตัวเก็บประจุ (Capacitor) ขนาด 2,200 µF 2 ตัว ตอขนาดกัน
- โหลดที่ใชคือมอเตอรกระแสตรงขนาด 6V จำนวน 1 ตัวเพื่อขับเคลื่อน 1 ลอหลัง

3

## 2 ทฤษฎีที่เกี่ยวของ

ในโครงงานนี้ไดใชทฤษฎีตางๆ ในการออกแบบระบบสงกำลังไฟฟาแบบไรสายซึ่งใชขดลวดฝงสงหรือ Transmitter Coil สงไปยังขดลวดฝงรับหรือ Receiver Coil แบบไรสายที่ความถี่ 13.56MHz โดยใชทฤษฎีตางๆ ดังนี้
2.1. ทฤษฎีคลื่นแมเหล็กไฟฟา
2.2. คุณสมบัติทอนำคลื่น
2.3. SubMiniature version A (SMA) Connector
2.4. ขดลวด (Coil)
2.5. คุณสมบัติทางวัสดุของ FR4 PCB
2.6. วงจรเรียงกระแส (Rectifier Circuit)

### 2.1. ทฤษฎีคลื่นแมเหล็กไฟฟา

จากกฎของแอมแปร เมื่อมีกระแสไฟฟาไหลในขดลวดจะทำใหเกิดสนามแมเหล็กขึ้นโดยรอบขดลวด และหาก สนามแมเหล็กนี้พุงผานพื้นที่หนาตัดของขดลวดอีกชุดหนึ่ง จะทำใหเกิดการเปลี่ยนของฟลักซแมเหล็ก (ฟลักซแมเหล็ก คือ ปริมาณสนามแมเหล็กในพื้นที่พื้นที่หนึ่ง) ซึ่งจะทำใหเกิดสนามไฟฟาขึ้นในขดลวดชุดนั้นๆ ในขดลวดชุดดังกลาวจะมี อิเล็กตรอนอยู เมื่อเกิดสนามไฟฟาจะทำใหเกิดแรงไฟฟากระทำกับอิเล็กตรอนภายในขดลวด ดังนั้นอิเล็กตรอนจะเกิดการ เคลื่อนที่ไปตามขดลวด จึงทำใหเกิดกระแสไฟฟาขึ้นในขดลวดชุดนั้นๆ

### 2.2. คุณสมบัติทอนำคลื่น

คำนวณคาสัมประสิทธิ์การสะทอนกลับของขดลวดรับ-สงพลังงานไฟฟาไรสาย ไดจากสมการที่ 1

สัมประสิทธิ์การสะทอนกลับ = ZZLL−ZZ0

# ZZLL+ZZ0

(1)
เมื่อ ZL คือ ความตานทานของขดลวดรับ-สงพลังงานไฟฟาไรสาย มีหนวยเปน ohms
Z0 คือ Impedance ของสายสง มีคาเทากับ 50 Ohms
คำนวณคาความตานทานของขดลวดเหนี่ยวนำ อันเนื่องมาจาก ขดลวดรับ-สงพลังงานไฟฟาไรสาย มีคุณสมบัติเปน ขดลวดเหนี่ยวนำ ไดจากสมการที่ 2

# ZZLL = 2ππππππ (2)

เมื่อ f คือ ความถี่ของคลื่นแมเหล็กไฟฟา มีคาเทากับ 13.56 MHz
L คือ Self Inductance มีหนวยเปน Henry [2:8847]

4

### 2.3. SubMiniature version A (SMA) Connector

SMA Connector หรือขั้วตอแบบ SMA ถูกประดิษฐขึ้นเมื่อ ป 1960 เปนตัวเชื่อมตออุปกรณคลื่นแมเหล็กไฟฟาใน ยาน Radio Frequency ซึ่งสายที่เอามาตอกับ Connector เปนสาย Coaxial มี Impedance เทากับ 50 Ohms โดยทั่วไป เหมาะกับความถี่ใชงาน 0 -18 GHz นิยมใชกันในระบบไมโครเวฟ โดยที่ SMA Connector จะมี 5 ขาหรือ Pin ขาตรง กลางเชื่อมตอกับสัญญาณ สวนอีก4ขาที่เหลือโดยรอบมีไวเพื่อยึดเกาะกับ PCB เพื่อความแข็งแรง และทำหนาที่เปน GND โดย SMA จะใชสาร polytetrafluoroethylene (PTFE) เปนฉนวน

### 2.4. ขดลวด (Coil)

ขดลวดในโครงงานนี้คือ ลายทองแดงตอกันเปนวงบน PCB ชนิด FR4 หนา 1.6 mm เปรียบเสมือนขดลวด เหนี่ยวนำอันหนึ่งที่สงผานสนามแมเหล็กและเหนี่ยวนำใหเกิดกระแสไฟฟาตอไปเรื่อยๆจนครบวง ซึ่ง PCB นี้จะวางประกบ กับรางรถเพื่อทำหนาที่ถายโอนพลังงานไปยังตัวรถ ซึ่งมีการตอ Capacitor เขาไปอนุกรมกับ Coil เพื่อทำใหเกิด Resonance ไดกระแสไฟฟาในวงจรสูงที่สุด เนื่องจากไมมีReactance และไมมี Imaginary Power จึงทำใหได Real Power สูงที่สุด โดยลักษณะการเชื่อมตอของ Coil มีทั้งแบบที่เชื่อมตอบน Layer เดียวกัน และ เชื่อมตอกันระหวาง Layer
ตัวแปรที่มีผลในการออกแบบ Coil
- ขนาดพื้นที่ชองวางตรงกลาง Coil ยิ่งมีพื้นที่มาก ยิ่งมีประสิทธิภาพที่ดีเพราะมีบริเวณที่สามารถรับสนามแมเหล็ก ไดมากขึ้นทำให Magnetic Flux เพิ่มขึ้น สงผลให Induced EMF Voltage เพิ่มขึ้นและกระแสไฟฟาเหนี่ยวนำเพิ่มขึ้น
- ความกวางของลายทองแดง ยิ่งกวางยิ่งดี เพราะความตานทานจะนอย ทนปริมาณกระแสไฟฟาไดสูง
- ระยะหางระหวางลายทองแดง
- คา Mutual Inductance
- คา Reflection Coefficient(S11) ซึ่งพิจารณาจาก Test Coil มีผลตออัตราสวนกำลังไฟฟาขาออกเทียบกับกำลัง ไฟฟาขาเขา

### 2.5. คุณสมบัติทางวัสดุของ FR4 PCB

PCB Board ทำมาจาก FR4 Material ซึ่งเปนวัสดุทนไฟ เปนฉนวนไฟฟา ประกอบขึ้นมาจาก Fiberglass และ Epoxy น้ำหนักเบาแตมีความแข็งแรง มีคาความหนาแนน 1.850 g/(cm)^3 ไมดูดซับน้ำ มีคา Relative permittivity เทากับ 4.4 มีคา Dissipation factor = 0.017 มีคา Dielectric Constant ประมาณ 3.9 – 4.7 มีคา Loss Tangent ประมาณ 0.02 - 0.03 และเปน Antiferromagnetic materials จึงไมใชสารแมเหล็ก ไมดูดหรือผลักกับขั้วแมเหล็ก (สนามแมเหล็ก) ดังนั้น Rx Coil จึงสามารถนำดานใดก็ไดของแผน PCB หันลงไปที่ราง เพื่อรับคลื่นแมเหล็กไฟฟา

5

Antiferromagnetism เกี่ยวของกับการหมุนของอิเล็กตรอน (Spin ไมใชการหมุนรอบตัวเอง) Magnetic Moment เกิดการจัดเรียงเปนกลุมชี้ไปทิศทางตรงกันขามกับสนามแมเหล็กจากภายนอก เมื่ออุณหภูมิสภาพแวดลอม
สูงเกินกวา magnetic ordering temperature จะทำให Antiferromagnetism เปลี่ยนสภาพกลายเปน Paramagnetism

### 2.6. วงจรเรียงกระแส (Rectifier Circuit)

วงจรเรียงกระแส (Rectifier Circuit) คือวงจรไฟฟาที่มีคุณสมบัติในการแปลงสัญญาณกระแสสลับใหกลายเปน สัญญาณไฟฟากระแสตรงหรือมีคุณสมบัติยอมใหไฟฟาไหลผานไปในทิศทางใดทิศทางหนึ่งอุปกรณที่นิยมใชในการแปลง สัญญาณไดแก ไดโอด (Diode) วงจรเรียงกระแสมี 2 ชนิด ไดแก วงจรเรียงกระแสแบบครึ่งคลื่น (Half-wave Rectifier Circuit) และวงจรเรียงกระแสแบบเต็มคลื่น (Full wave Rectifier Circuit) [3]

### 2.6.1. วงจรเรียงกระแสแบบครึ่งคลื่น (Half-wave Rectifier Circuit)

วงจรนี้จะใชไดโอด 1 ตัว ในการเปลี่ยนอินพุตจากไฟฟากระแสสลับ (คลื่นไซน) ใหกลายเปนไฟฟากระแสตรง โดย เปลี่ยนเฉพาะคลื่นดานบวกของอินพุตเทานั้นเพราะวาไดโอดจะทำงานก็ตอเมื่อไดรับคลื่นไซนดานครึ่งดานบวกเทานั้น เนื่องจากในชวงนั้นไดโอดจะเปนไบอัสตรงจึงทำใหเกิดกระแสไหลจากแหลงจายผานไดโอดไปสูโหลดแตเมื่อคลื่นไซน อินพุตเปนชวงครึ่งของดานลบเมื่อนั้นจะทำใหไดโอดไมทำงานสงผลใหไมมีกระแสไหลผานโหลด คลื่นในเอาตพุตจึงปรากฏ เฉพาะครึ่งดานบวกเทานั้น ดังภาพที่ 2

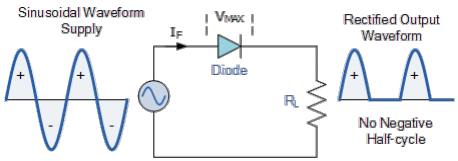
[picture p33: figure]

ภาพที่ 2 วงจรเรียงกระแสแบบครึ่งคลื่น (Half-wave Rectifier Circuit)

### 2.6.2. วงจรเรียงกระแสแบบเต็มคลื่น (Full wave Rectifier Circuit) มี 2 ประเภท

1) วงจรเรียงกระแสมีหมอแปลงแทปกลาง (Full – Wave Rectifier with Tapping Transformer) เปนวงจรที่มี การใชไดโอด 2 ตัว ทำหนาที่ในการแปลงสัญญาณไฟสลับใหกลายเปนสัญญาณไฟตรงและใชหมอแปลงแทป กลาง 1 ตัว ในการแบงเฟสใหเกิดการตางเฟสกัน 180 องศา ระหวางสัญญาณที่ออกจากสวนบนและสวนลางของขดลวดทุติยภูมิของ

6

หมอแปลง เพื่อใหไดโอดทั้ง 2 ตัวทำงานสลับกัน วงจรจึงสามารถจายกระแสไดเรียบและสูงกวาวงจรเรียงกระแสแบบครึ่ง คลื่น ดังภาพที่ 3

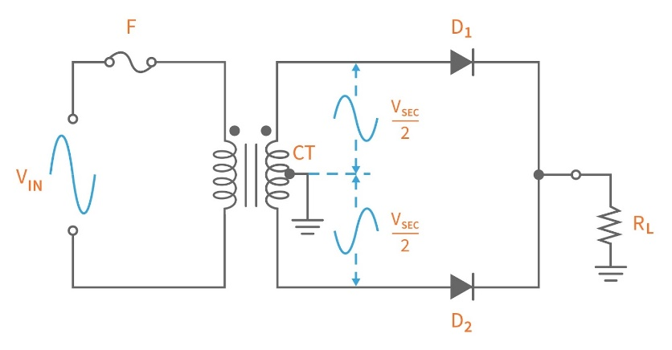
[picture p34: figure]

ภาพที่ 3 วงจรเรียงกระแสมีหมอแปลงแทปกลาง (Full – Wave Rectifier with Tapping Transformer)

2) วงจรบริดจ (Full – Wave Bridge Rectifier) เปนวงจรที่มีการใชไดโอด 4 ตัว แตจะไมมีการใชหมอแปลง แทป กลาง ซึ่งก็มีขอดีมากกวา เพราะหมอแปลงแทปกลางนั้นมีขนาดที่ใหญ และมีน้ำหนักมากกวาหมอแปลงที่ไมมีแทปกลาง เนื่องจากหมอแปลงแบบแทปกลางจะมีขดลวดมากกวา ดังนั้นการใชวงจรบริดจจะเปนการลดคาใชจาย และลดขนาดของ วงจรไดมากกวาแบบวงจรเรียงกระแสมีหมอแปลงแทปกลาง ดังภาพที่ 4

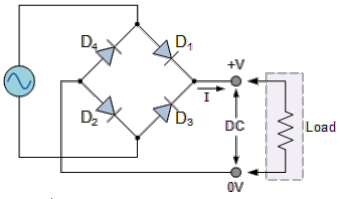
[picture p35: figure]

ภาพที่ 4 วงจรบริดจ (Full – Wave Bridge Rectifier)

ในสวนของ Capacitor ที่อยูใน Rectifier Circuit ตีความไดวา C คือปริมาณประจุไฟฟาที่เก็บสะสมไวได เมื่อ เชื่อมตอกับแรงดันไฟฟา 1 V แสดงดังสมการที่ 3

# CC = QQ

VV | (3)

หมายความวา หากเทียบในแรงดันไฟฟาที่เทากัน เมื่อปริมาณความสามารถในการเก็บประจุไฟฟาสูงขึ้น จะทำใหมี พลังงานศักยไฟฟาในรูปแบบสนามไฟฟาสูงขึ้น

7

## 3 เครื่องมือที่ใชในการทำโครงงาน

### 3.1. ฮารดแวรที่ใชในการทำโครงงาน 3.1.1. Oscillator

เครื่องกำเนิดสัญญาณไฟฟากระแสสลับ มีลักษณะดังภาพที่ 5 โดยใชความถี่ 13.56MHz เนื่องจากเปนขอบังคับ ทางกฎหมายเพื่อไมใหรบกวนกับการทํางานของอุปกรณคลื่นแมเหล็กไฟฟาอื่นๆ โดยจะใชOutput คํานวณ หา อัตรากําลัง ขยายใน Amplifier โดยมีขอมูลจำเพาะ (Specification) ดังนี้
Operating Frequency: 13.56MHz RF
Output Power: 7dBm~23dBm (5~200mW)
Working Voltage: 12V
Working Current: 60mA

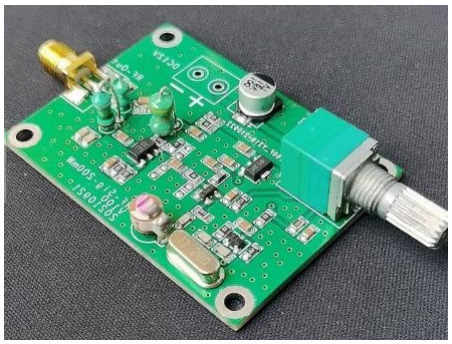
[picture p36: figure]

ภาพที่ 5 เครื่องกําเนิดสัญญาณ (Oscillator)

### 3.1.2. Amplifier

อุปกรณขยายสัญญาณ ดังภาพที่ 6 เพื่อใหมีกำลังไฟฟามากพอที่จะสงกำลังไฟฟาแบบไรสายไดโดยตองคำนึงถึงสิ่ง ตางๆ ดังนี้
- Maximum Output คานี้จะสัมพันธกับการสงกําลังไฟฟาไปใหตัวขดลวดฝงสงเพื่อจะสงตอไปใหขดลวดฝงรับจากนั้นจะ สงตอกําลังไฟฟาไปจนถึงมอเตอรเพื่อที่จะใหรถยนตขับเคลื่อน โดยยิ่งคา Output สูงสุดยิ่งมากจะทําใหการทํางานของ ระบบนี้เสถียรยิ่งขึ้น

8

- ยานความถี่ที่อุปกรณตัวนี้สามารถใชงานได
- คากําลังขยายทั่วไปของ RF Power Amplifier โดยจะเปนในสวนกําลังขยายซึ่งจะสัมพันธคา Output สูงสุดของ อุปกรณ
- Impedance Input และ Output ตองมีคา 50 Ω เทากันเพราะจะไดไมเกิดคลื่นสะทอนกลับเพราะตัวคลื่นสะทอนกลับ นั้นจะทําใหอุปกรณเสียหายได
จากปจจัยตางๆที่กลาวมาขางตนจึงเลือกอุปกรณที่มีลักษณะดังนี้
- เอาตพุตสูงสุด 4.16 วัตต
- แหลงจายไฟ 12V
- บรอดแบรนด สามารถทำงานไดในชวง 2MHZ ถึง 700MHZ
- กำลังขยายทั่วไปของ RF Power Amplifier นี้คือ 35 dB

ขอมูลจำเพาะ
แรงดันไฟ: DC+12-15V (ทั่วไป 15V@0.3-0.5A) ความถี่ในการทำงาน: 2MHZ-700MHZ อิมพีแดนซอินพุตและเอาตพุต: 50 โอหม, กําลังขับสูงสุด: 4.16 Watt

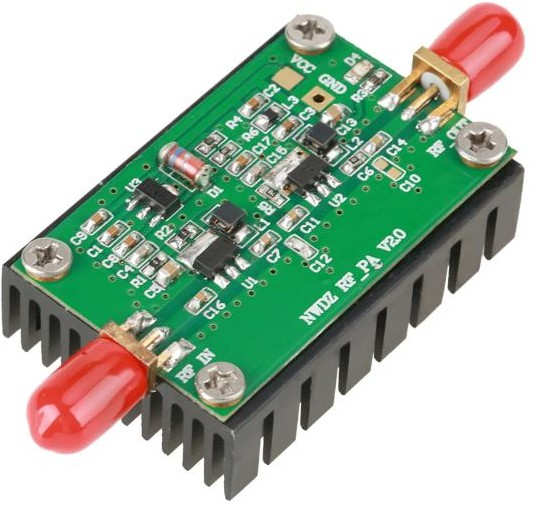
[picture p37: figure]

ภาพที่ 6 อุปกรณขยายสัญญาณ (Amplifier)

9

นอกจากนี้ยังมีอุปกรณอื่นๆ ที่ไดมาจากการออกแบบและจัดหา ไดแก
- ขดลวดฝงสง หรือ Transmitter Coil วงกลมที่ออกแบบจากโปรแกรม EasyEDA
- ขดลวดฝงรับ หรือ Receiver Coil ที่ออกแบบจากโปรแกรม EasyEDA
- SMA Cable ที่ใชเชื่อมตออุปกรณตางๆ
- วงจรเรียงกระแสประเภทเต็มคลื่นแบบบริดจ (Full Wave Bridge Rectifier Circuit) ซึ่งประกอบดวย
- Schottky Diode เบอร 1N5819 จำนวน 4 ตัว
- Capacitor ขนาด 2200uF จำนวน 2 ตัว
- มอเตอรกระแสตรงขนาด 6V จำนวน 1 ตัวเพื่อขับเคลื่อน 1 ลอหลังดานซาย
- เครื่องพิมพ 3 มิติ Creality Ender3 Max ที่ใชพิมพตัวรถ ลอตางๆ
- เครื่องพิมพ 3 มิติ Creality CR-10 Max ที่ใชพิมพตัวรางและฐานราง

### 3.2. ซอฟทแวรที่สำคัญที่ใชในการทำโครงงาน 3.2.1. Google Colab

เว็บไซตที่สำคัญในการเขียนโปรแกรมคอมพิวเตอรดวยภาษา Python สำหรับโครงงานวิศวกรรมไฟฟานี้ จะเขียน โปรแกรมเพื่อใชในการคำนวณคาความเหนี่ยวนำของขดลวดสงพลังงานไฟฟาไรสายและขดลวดรับพลังงานไฟฟาไรสาย โดยแสดงสัญลักษณของโปรแกรมนี้ ในภาพที่ 7

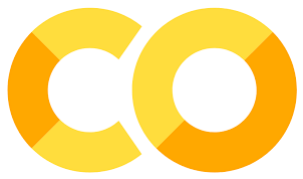
[picture p38: figure]

ภาพที่ 7 Google Colab Icon

### 3.2.2. Sonnet Software (Kasetsart University License)

โปรแกรมสำคัญในการออกแบบลักษณะทางกายภาพของขดลวดสงพลังงานไฟฟาไรสายและขดลวดรับพลังงาน ไฟฟาไรสาย และสามารถ Simulation เพื่อแสดงกราฟของคา Reflection Coefficient เทียบกับคา Electromagnetic Wave Frequency โดยแสดงสัญลักษณของโปรแกรมนี้ ในภาพที่ 8

10

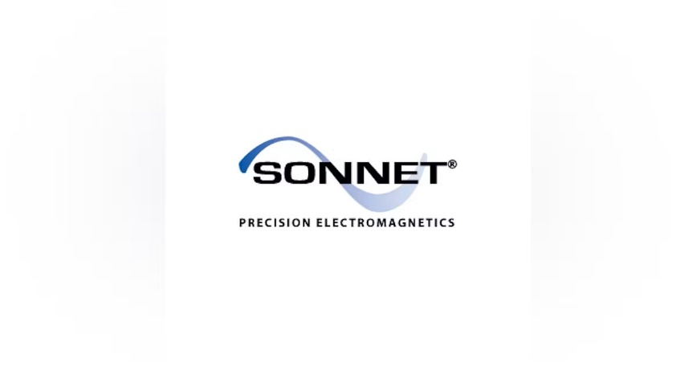
[picture p39: figure]

ภาพที่ 8 Sonnet Software Icon

### 3.2.3. EasyEDA Std Edition (Free Version)

โปรแกรมสำหรับออกแบบ PCB Board/PCB Circuit ซึ่งสามารถเลือกตออุปกรณอิเล็กทรอนิกสที่ตองการ ใหกลายเปนวงจรอิเล็กทรอนิกสและออกแบบวางลายทองแดงบน PCB Board พรอมสั่งผลิตกับ JLCPCB ในการออกแบบ PCB ใช Copper Area กับ Rectifier ทั้งใน Top Layer และ Bottom Layer ใช Solid Region และ Rectangular ในการออกแบบ Coil โดยแสดงสัญลักษณของโปรแกรมนี้ ในภาพที่ 9 ซึ่งโปรแกรมนี้มีประโยชนมากมาย ดังนี้
- EasyEDA สามารถ Preview 3D ได
- EasyEDA มีการเชื่อมตอ Import DXF Files ที่มาจากโปรแกรม Sonnet ได
- EasyEDA มี 2 โหมดการทำงานไดแก Schematic และ PCB โดยสามารถ Transfer จาก Schematic Mode ไปยัง PCB Mode ได

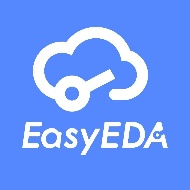
[picture p40: figure]

ภาพที่ 9 EasyEDA Software Icon

### 3.2.4. Autodesk Fusion (Education License)

โปรแกรมที่ใชออกแบบภาพ 3 มิติ ที่ทำงานบนระบบ Cloud โดยสามารถออกแบบและสรางผลิตภัณฑไดตาม ตองการ พรอมกับความสวยงาม รูปทรงพอเหมาะพอดี และคำนึงถึงการใชงาน พรอมทั้งครอบคลุมการออกแบบทางดาน วิศวกรรม ดังภาพที่ 10

11

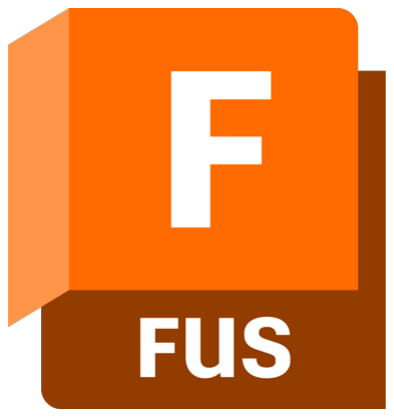
[picture p41: figure]

ภาพที่ 10 Autodesk Fusion Icon

### 3.2.5. Ultimaker Cura (Freeware)

โปรแกรมที่ใชแปลงไฟลที่มากจากการออกแบบ 3 มิติเปนไฟลที่พรอมพิมพที่เครื่องพิมพ3 มิติดังภาพที่ 11 โดยจะ บอกถึงระยะเวลาและความยาวของเสนพลาสติดที่ใชพิมพ

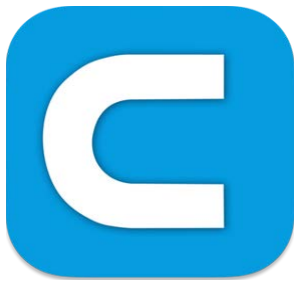
[picture p42: figure]

ภาพที่ 11 Ultimaker Cura Icon

12

## 4 วิธีการดำเนินโครงงาน

ในการทำโครงงานนี้ ไดทำการศึกษาเกี่ยวกับการสงกำลังไฟฟาแบบไรสายโดยใชทฤษฎีคลื่นแมเหล็กไฟฟา เพื่อ สรางออกมาเปนชิ้นงานใหเห็นภาพโดยการขับเคลื่อนมอเตอรของโมเดลรถขนาดเล็ก ซึ่งแสดงใหเห็นดังภาพที่ 12

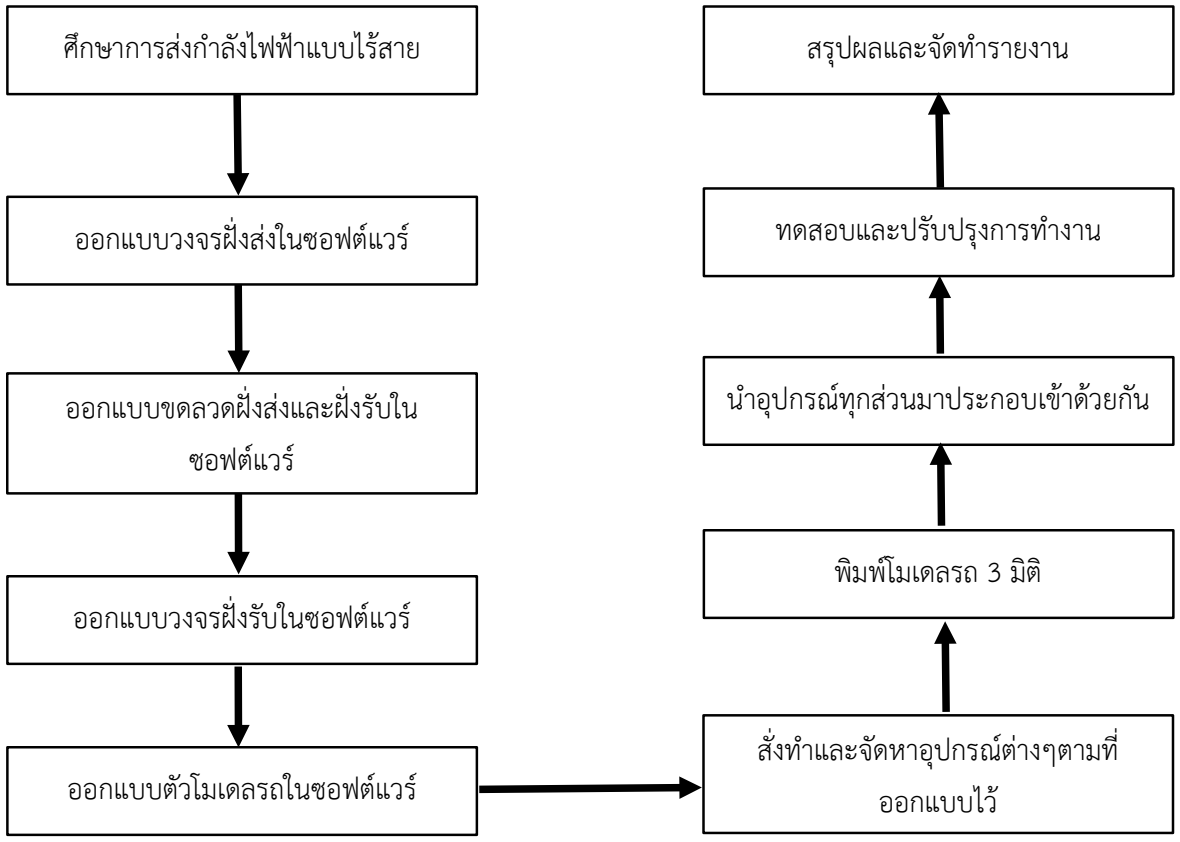
[picture p43: figure]
ศึกษาการสงกำลังไฟฟาแบบไรสาย; ออกแบบวงจรฝงสงในซอฟตแวร; ออกแบบขดลวดฝงสงและฝงรับใน ซอฟตแวร; ออกแบบวงจรฝงรับในซอฟตแวร; ออกแบบตัวโมเดลรถในซอฟตแวร; สั่งทำและจัดหาอุปกรณตางๆตามที่ ออกแบบไว; พิมพโมเดลรถ 3 มิติ; นำอุปกรณทุกสวนมาประกอบเขาดวยกัน; ทดสอบและปรับปรุงการทำงาน; สรุปผลและจัดทำรายงาน

ภาพที่ 12 แผนผังขั้นตอนการดำเนินโครงงาน

13

## 5 ผลการดำเนินโครงงานและวิจารณ

### 5.1. ขดลวดรับ-สงพลังงานไฟฟาไรสาย

ในการออกแบบขดลวดรับ-สงพลังงานไฟฟาไรสาย จะแสดงภาพขดลวดรับ-สงพลังงานไฟฟาไรสายแบบเดี่ยว และ ขดลวดรับ-สงพลังงานไฟฟาไรสายแบบคู ในภาพที่ 13 และ 14 ตามลำดับ ซึ่งขดลวดรับสงพลังงานไฟฟาไรสาย มีตัวกลาง 3 ชั้น แสดงในภาพที่ 15 (ภาพที่ 13 มีชื่อไฟลวา donut_wire2 และภาพที่ 14 มีชื่อไฟลวา donut_wire2-twin)

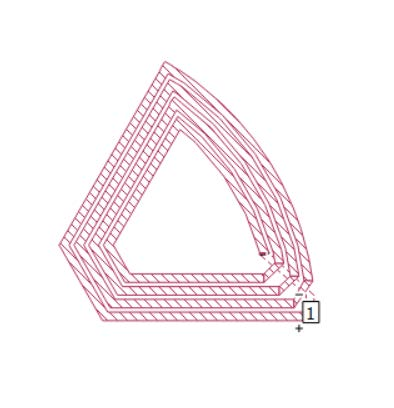
[picture p44: figure]

ภาพที่ 13 ขดลวดรับ-สงพลังงานไฟฟาไรสายแบบเดี่ยว

14

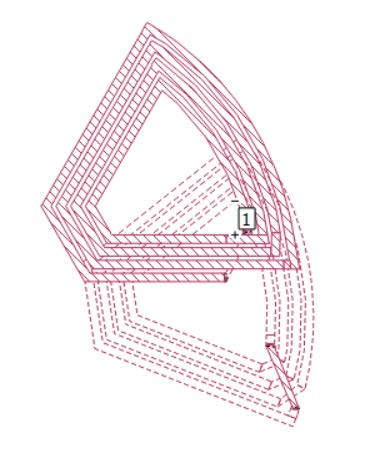
[picture p45: figure]

ภาพที่ 14 ขดลวดรับ-สงพลังงานไฟฟาไรสายแบบคู

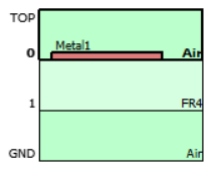
[picture p46: figure]

ภาพที่ 15 ตัวกลางทั้ง 3 ชั้นของขดลวดรับ-สงพลังงานไฟฟาไรสาย

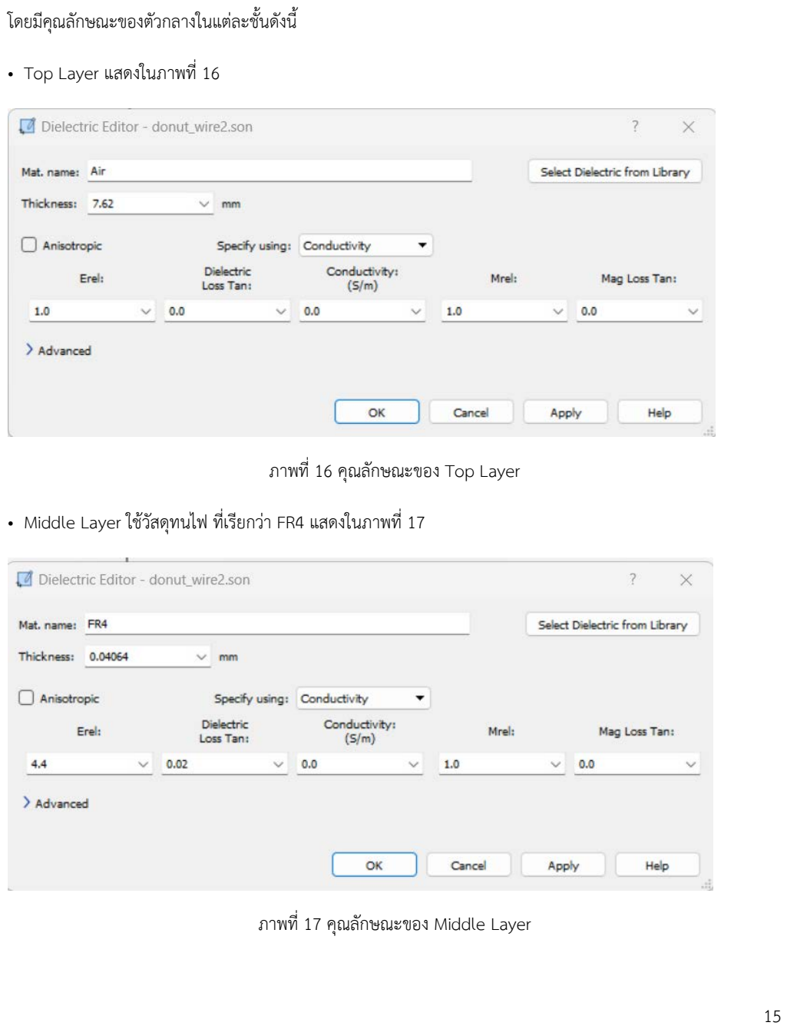
[picture p47: page 26]

15

โดยมีคุณลักษณะของตัวกลางในแตละชั้นดังนี้
- Top Layer แสดงในภาพที่ 16

ภาพที่ 16 คุณลักษณะของ Top Layer
- Middle Layer ใชวัสดุทนไฟ ที่เรียกวา FR4 แสดงในภาพที่ 17

ภาพที่ 17 คุณลักษณะของ Middle Layer

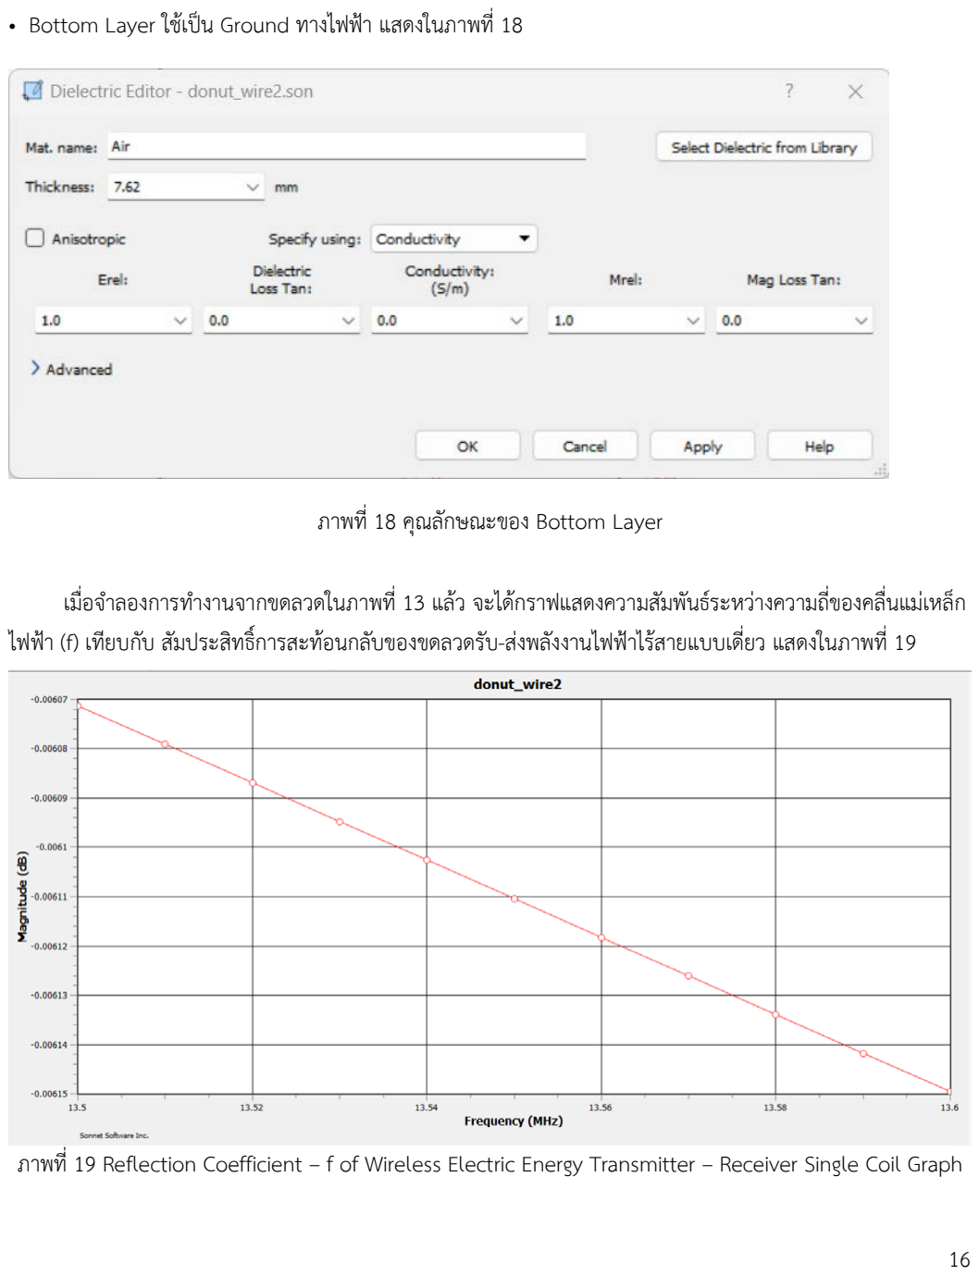
[picture p48: page 27]

16

- Bottom Layer ใชเปน Ground ทางไฟฟา แสดงในภาพที่ 18

ภาพที่ 18 คุณลักษณะของ Bottom Layer

เมื่อจำลองการทำงานจากขดลวดในภาพที่ 13 แลว จะไดกราฟแสดงความสัมพันธระหวางความถี่ของคลื่นแมเหล็ก ไฟฟา (f) เทียบกับ สัมประสิทธิ์การสะทอนกลับของขดลวดรับ-สงพลังงานไฟฟาไรสายแบบเดี่ยว แสดงในภาพที่ 19

ภาพที่ 19 Reflection Coefficient – f of Wireless Electric Energy Transmitter – Receiver Single Coil Graph

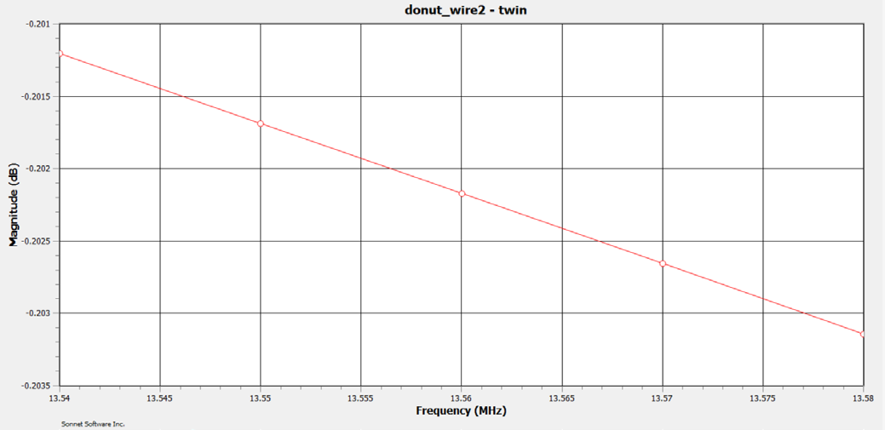
[picture p49: figure]

17

เมื่อจำลองการทำงานจากขดลวดในภาพที่ 14 ความสัมพันธระหวางความถี่ของคลื่นแมเหล็กไฟฟา(f) เทียบกับ สัมประสิทธิ์การสะทอนกลับของขดลวดรับ-สงพลังงานไฟฟาไรสายแบบคู (เชื่อมตอกันแบบ Overlap) แสดงในภาพที่ 20

ภาพที่ 20 Reflection Coefficient – f of Wireless Electric Energy Transmitter – Receiver Double Coil Graph

หลังจากการออกแบบขดลวดทั้ง 2 ผานโปรแกรม EasyEDA แลว จะไดขดลวดฝงสง ขดลวดฝงรับ และขดลวด ทดสอบ ดังภาพที่ 21, 22 และ 23 ตามลำดับ และเมื่อสั่งทำชิ้นงานแลวจะไดขดลวดฝงสงและขดลวดฝงรับ ดังภาพที่ 24 และ 25 ตามลำดับ

18

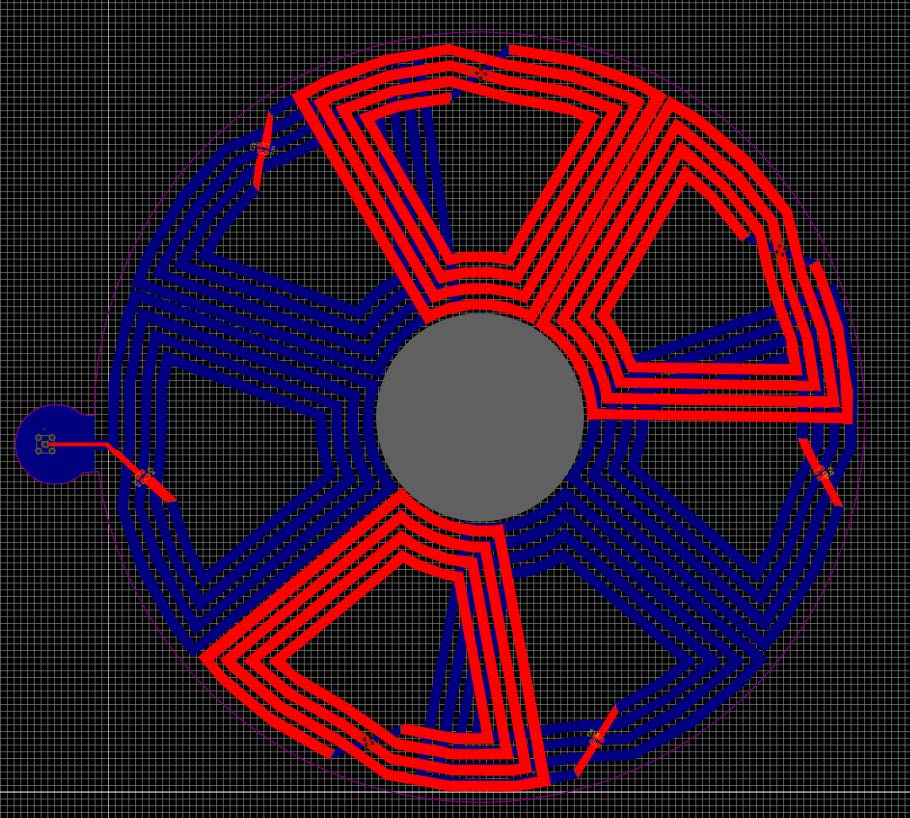
[picture p50: figure]

ภาพที่ 21 แบบขดลวดฝงสง TX Coil-Transmitter Coil

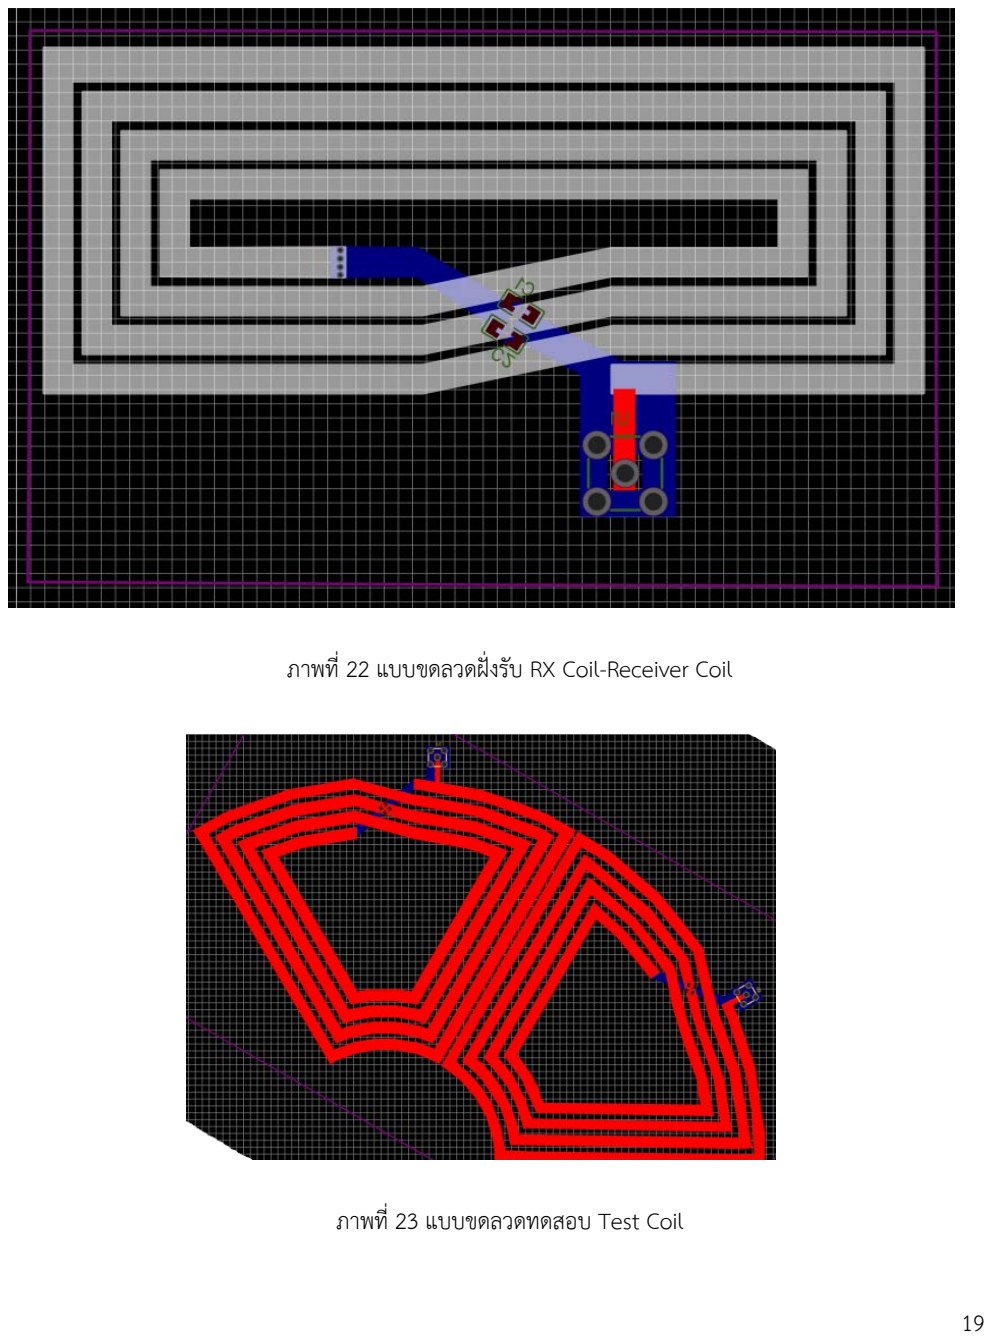
[picture p51: page 30]

19

ภาพที่ 22 แบบขดลวดฝงรับ RX Coil-Receiver Coil

ภาพที่ 23 แบบขดลวดทดสอบ Test Coil

20

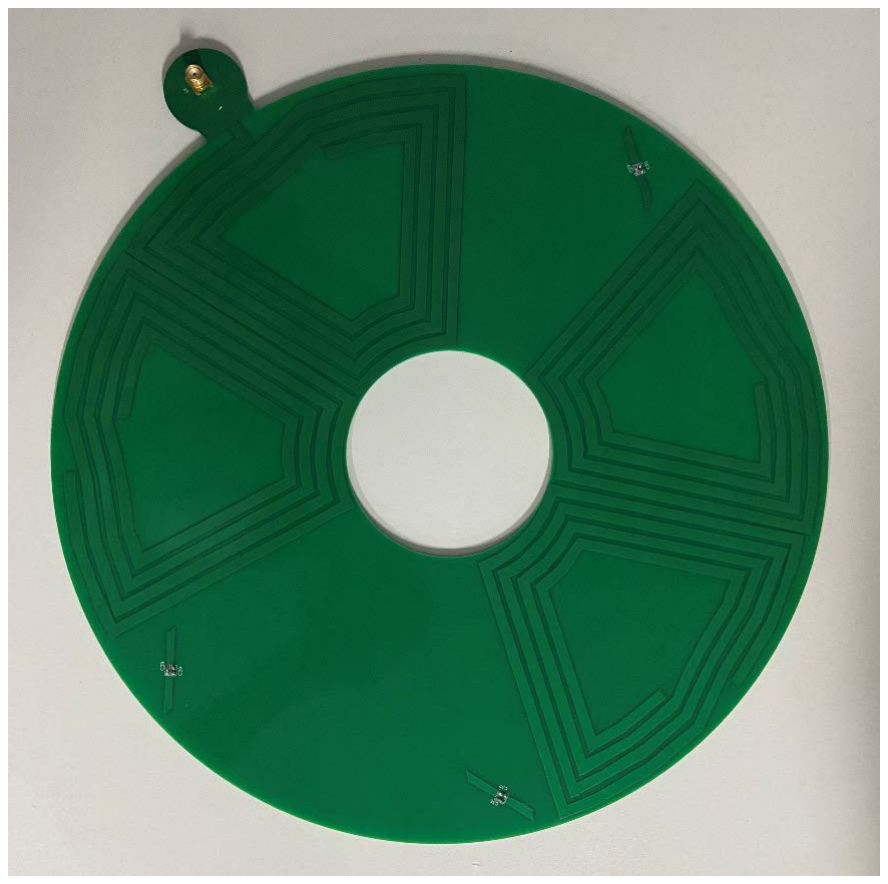
[picture p52: figure]

ภาพที่ 24 ชิ้นงานขดลวดฝงสง TX Coil-Transmitter Coil

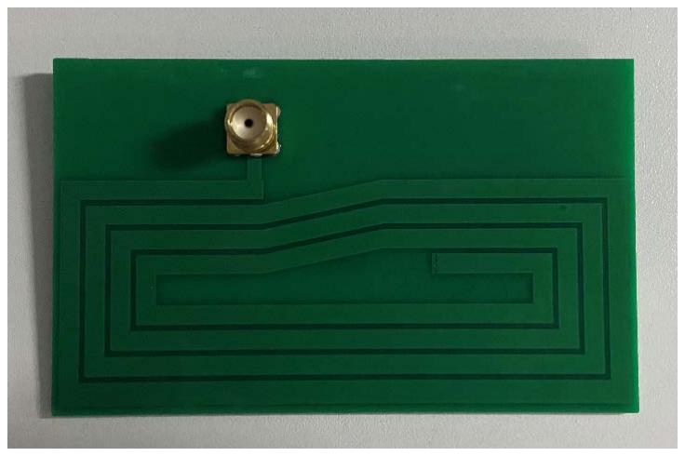
[picture p53: figure]

ภาพที่ 25 ชิ้นงานขดลวดฝงรับ RX Coil-Receiver Coil

21

การทดสอบคากำลังไฟฟาขาเขาและกำลังไฟฟาขาออก
วัดคากำลังไฟฟาขาเขาจากขาออกของ Amplifier และวัดกำลังไฟฟาขาออกจากขาออกของ Rectifier Circuit โดย ใชความถี่ของคลื่นแมเหล็กไฟฟาที่13.56MHz เนื่องจากขอกำหนดทางกฎหมายสำหรับการทดลองอุปกรณทางดาน คลื่นแมเหล็กไฟฟาเพื่อจะไดไมไปรบกวนอุปกรณคลื่นแมเหล็กไฟฟาอื่น

การคำนวณคา Self Inductance (L) และ Mutual Inductance (M) ดวยวิธีCoding ใน Google Colab คาที่จะแสดงตอไปนี้ ไดมาจากการ export file s1p s2p จาก โปรแกรม Sonnet แลว import เขาไปใน Google Colab เพื่อใชวิธี Coding
M = 0.3 µH สำหรับ Test Coil กรณี Non-Overlap ดังภาพที่ 26
L = 3.42 µH สำหรับ Test Coil กรณี Non-Overlap ดังภาพที่ 27
L = 0.58 µH สำหรับ Rx Coil ดังภาพที่ 28

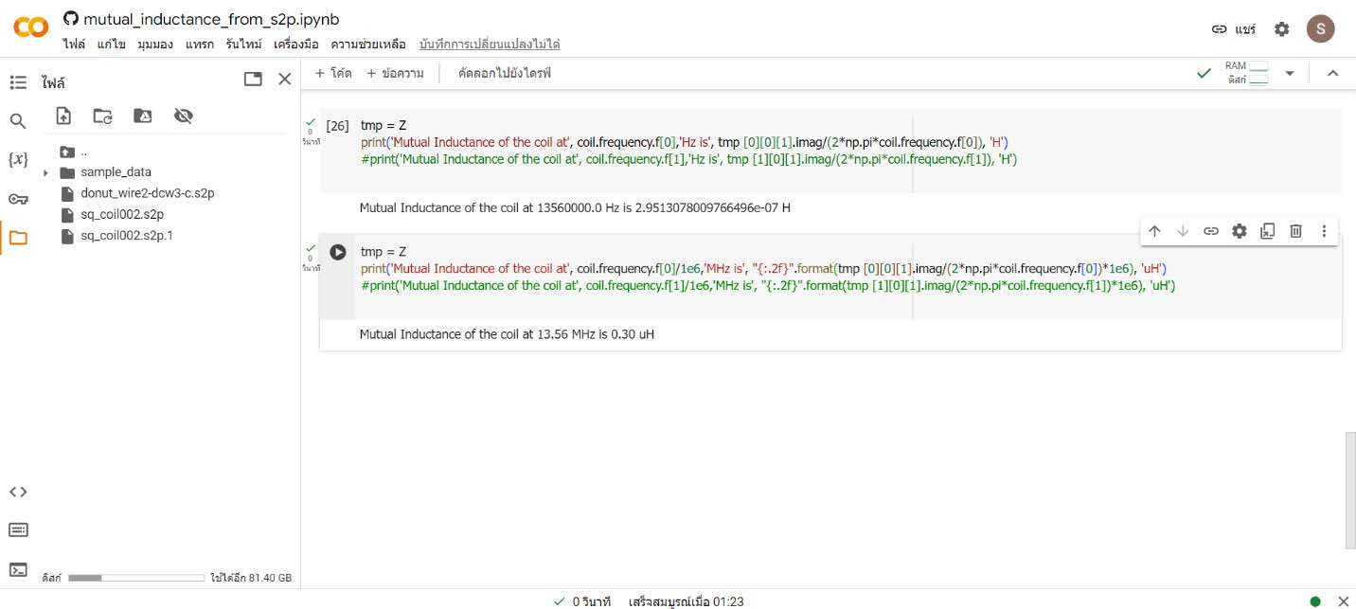
[picture p54: figure]

ภาพที่ 26 การคำนวณ Mutual Inductance ของ Test Coil ดวยวิธี Coding

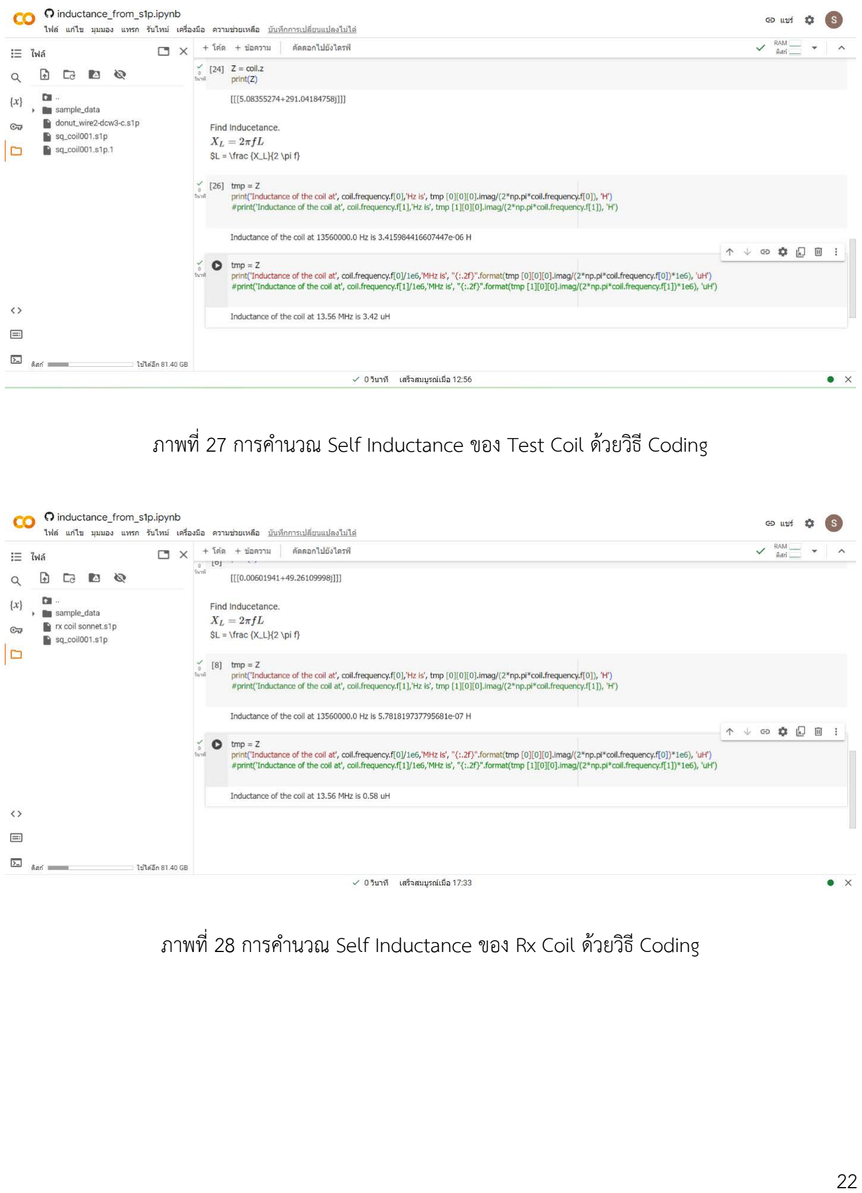
[picture p55: page 33]

22

ภาพที่ 27 การคำนวณ Self Inductance ของ Test Coil ดวยวิธี Coding

ภาพที่ 28 การคำนวณ Self Inductance ของ Rx Coil ดวยวิธีCoding

23

วัดคาอุปกรณจริง
มีวัตถุประสงคเพื่อหาคาความตานทานจินตภาพเหนี่ยวนำ เพราะ Coil มีคุณสมบัติเปนขดลวดเหนี่ยวนำ เพื่อ ตองการใหไดกระแสไฟฟาในวงจรสูงสุด จึงตองการปรับใหคาความตานทานจินตภาพของอุปกรณเปนศูนยโดยการนำตัว เก็บประจุไฟฟามาตออนุกรมโดยที่ตัวเก็บประจุมีความตานทานจินตภาพเปนจำนวนจินตภาพลบ เรียกวา Series Resonance Effect โดยอุปกรณที่ใชในการวัดคา เรียกวา Vector Network Analyzer ซึ่งจะแสดงผลลัพธใหเห็น ใน รูปแบบ Smith Chart หากจุดไปแสดงที่ตำแหนงซายสุด คือ Short Circuit หากจุดไปแสดงที่ตำแหนงขวาสุด คือ Open Circuit หากจุดอยูในซีกบนของกราฟ อุปกรณจะมีคุณสมบัติเปนขดลวดเหนี่ยวนำ แตหากจุดอยูในซีกลางของกราฟ อุปกรณจะมีคุณสมบัติเปนตัวเก็บประจุไฟฟา

L ของ Test Coil = 2.16 uH
คา S21 = -21dB phase 122.5 degrees
S11 ~ 0dB 30.5degrees
ตองหาคา C ที่มีคา XC = XL ที่ 13.56 MHz
ตองเลือกซื้อ Capacitor 0805 ที่มีคุณสมบัติUltra Low ESR + HighQ lowloss

และ Tx Coil มีคุณสมบัติดังนี้
L = 2.16 uH XL = 184 ohm C = 63.8 pF
ตองใชC = 62 pF 7 ชิ้น สำหรับ Tx Coil และ 2 ชิ้น สำหรับ Test Coil

L ของ Rx Coil = 0.763 uH
ตองใชC = 180 pF 1 ชิ้น สำหรับ Rx Coil

24

การติดตั้งอุปกรณ
การวัดคาความตานทานของ RX Coil ดวย Vector Network Analyzer พบวาเหมาะสมที่สุดกับการใชงานที่ ความถี่ 13.56 MHz แสดงดังภาพที่ 29

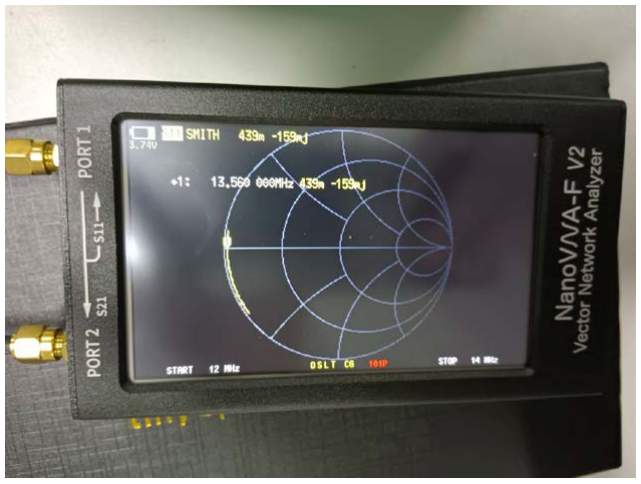
[picture p56: figure]

ภาพที่ 29 วัดคาความตานทานของ RX Coil ดวย Vector Network Analyzer

จากการวัดคาความตานทานของ TX Coil ดวย Vector Network Analyzer พบวา เหมาะสมที่สุดกับการใชงานที่ ความถี่ 13.42 MHz โดยที่เปนคาจากการทดลองซึ่งแสดงดังภาพที่ 30
XL ของ TX Coil มีคา 184 Ω ซึ่งไดมาจากการวัด (กอนใส Capacitor) หรือเขียนเปน Reactance Form ไดวา XL = j184 Ω เมื่อใส Capacitor เขาไปแลว วัดคาได -j19.3 หากคุณสมบัติทางไฟฟาของ TX Coil เหมือนกันกับ Test Coil แสดงดังภาพที่ 30 โดยที่ XL (กอนใส Capacitor) + XC = X (หลังใส Capacitor) จะคำนวณไดวา XC = -j203.3 Ω และ นำมาคำนวณในสมการที่ 4 เพื่อหาคา Capacitance ของ Capacitor ที่ตอเขาไปกับ Tx Coil

# XXCC = 1

2ππff | (4)

เมื่อ Xc คือ Capacitive Reactance หลังผานการ Normalization ใหกลายเปนจำนวนจริงบวก f คือ ความถี่ของสัญญาณไฟฟากระแสสลับ
C คือ คา Capacitance ของ Capacitor ที่ตอเขาไปกับ Tx Coil
เมื่อแทนคา XC และคา f จะคำนวณไดวา C = 57.7329 pF หรือประมาณคาไดเปน C = 58 pF

25

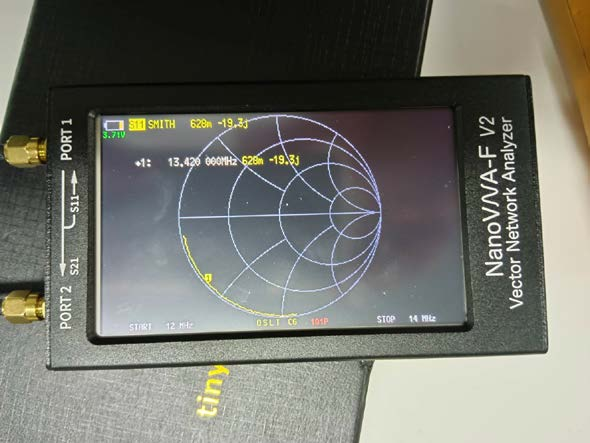
[picture p57: figure]

ภาพที่ 30 วัดคาความตานทานของ TX Coil ดวย Vector Network Analyzer

โดยปกติแลว TX Coil (Non-Overlap Case) และ Test Coil ควรมีคา Self Inductance เทากัน แตในการ ออกแบบนี้เกิดขอผิดพลาดเล็กนอย ไดแก Test Coil 2 ฝง ไมไดมีลักษณะทางกายภาพเหมือนกันทุกประการ ในฝง หนึ่งมีขดลวดสวนที่ยื่นเกินออกไป และขอผิดพลาดอีกประการหนึ่งคือ ลายทองแดง 7 ชิ้น บน TX Coil ซึ่งระหวาง ขดลวด 2 ขดลวด แบบ Non-Overlap คูหนึ่ง มีระยะหางไมเทากันตลอดแนวรอยตอ กลาวคือ แนวรอยตอมีความกวาง ไมสม่ำเสมอ จึงทำใหคา Self Inductance ของ TX Coil(Non-Overlap Case) เมื่อเปรียบเทียบกับ Test Coil มีคา แตกตางกันเล็กนอย
Smith chart ดังภาพที่ 31 เปนเครื่องมือที่สำคัญเพื่อความสะดวกในการคำนวณ impedance ในอุปกรณ Radio Frequency ในทางปฏิบัติ นิยมนำมาใชงานกับระบบวิศวกรรมไมโครเวฟ เครือขายสื่อสารและสายสง กลาวคือ impedance เปนตัวเลขจำนวนเชิงซอน โดยที่ สวนจริงคือความตานทานไฟฟาจาก Resistor สวนจินตภาพ คือคาความ ตานทานไฟฟาซึ่งขึ้นอยูกับความถี่ของสัญญาณจาก Inductor และ Capacitor มีคาไดตั้งแต 0 no load short circuit มากไปจนถึง infinity open circuit ซึ่งถูกวาดลงบน กราฟ 2 มิติที่มีขอบเขต Smith chart ไดบรรจุตัวแปร scattering parameters ไวดวย [4]
การออกแบบใหเกิดการ Impedance matching มีความสำคัญ เพราะ จะทำใหการสงกำลังไฟฟามีประสิทธิภาพ loss นอยลง อุปกรณจะไมรอน ไมเกิดคลื่นนิ่งในวงจร และไมเกิดการสะทอนกลับของสัญญาณ บน Smith Chart ขอบเขต ของแตละวงกลมแสดงถึงคา VSWR ซึ่งคือตัวแปรที่แสดงถึง อัตราสวนของแรงดันสูงสุดและแรงดันต่ำสุดของรูปคลื่นนิ่งบน สายนำสัญญาณ ในกรณีที่เกิดการ Impedance matching แลว VSWR จะมีคาเทากับ 1 โดยที่รัศมีของงกลมจะแปรผัน ตรงกันกับคา VSWR

26

Smith Chart สามารถใชเพื่อกำหนดคา admittance คือปริมาณที่เปนสวนกลับของ impedance มีความสำคัญใน การทำ stub tuning คือการนำสายไฟที่มีคาความยาวของสายที่เหมาะสม มาตอเขากับวงจรหลักเพื่อปรับคา impedance

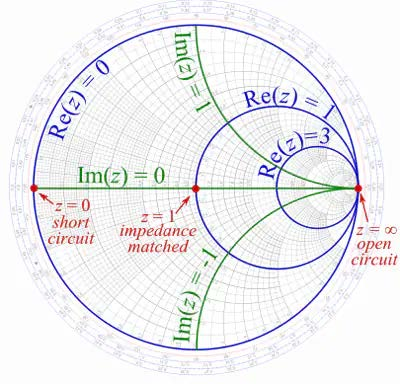
[picture p58: figure]

ภาพที่ 31 การคำนวณ Impedance ดวย Smith Chart

การวัดคากำลังไฟฟาบน RX Coil โดยวัดเทียบจากผลตางมุม 15 องศา บนขดลวด TX Coil ในการวัดคากำลังไฟฟาบน RX Coil โดยวัดเทียบจากผลตางมุม 15 องศา บนขดลวด TX Coil โดยตอเขากับ แหลงกำเนิดไฟฟากระแสตรง 13.0 V 0.34 A ดังภาพที่ 32 และกำหนดจุดเริ่มตน คือ ขดลวดที่อยูติดกันกับ Connector เปนมุม 0 องศา แลวเรียงลำดับการวัดแบบตามเข็มนาิกา แสดงวิธีการวัด ดังภาพที่ 33 โดยใช Spectrum Analyzer ดัง ภาพที่ 34 และแสดงผลลัพธที่ไดจากการวัดคา ดังตารางที่ 1

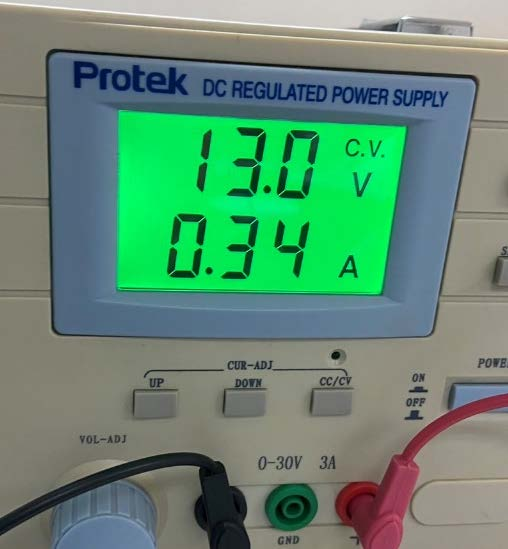
[picture p59: figure]

ภาพที่ 32 แหลงกำเนิดไฟฟากระแสตรง 13.0 V 0.34 A

27

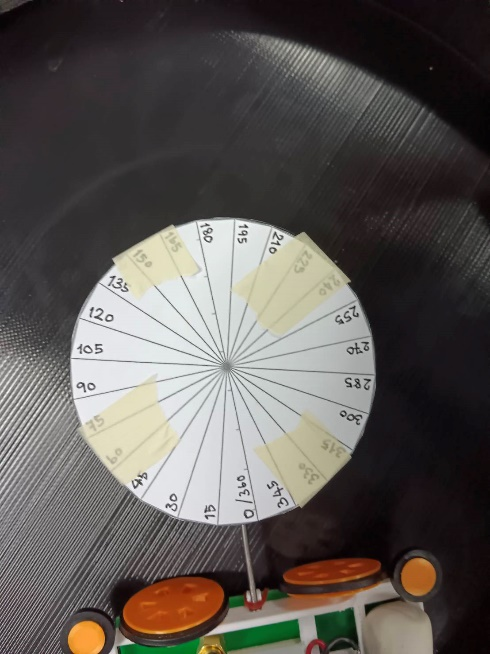
[picture p60: figure]

ภาพที่ 33 เครื่องมือแสดงคามุมบน TX Coil

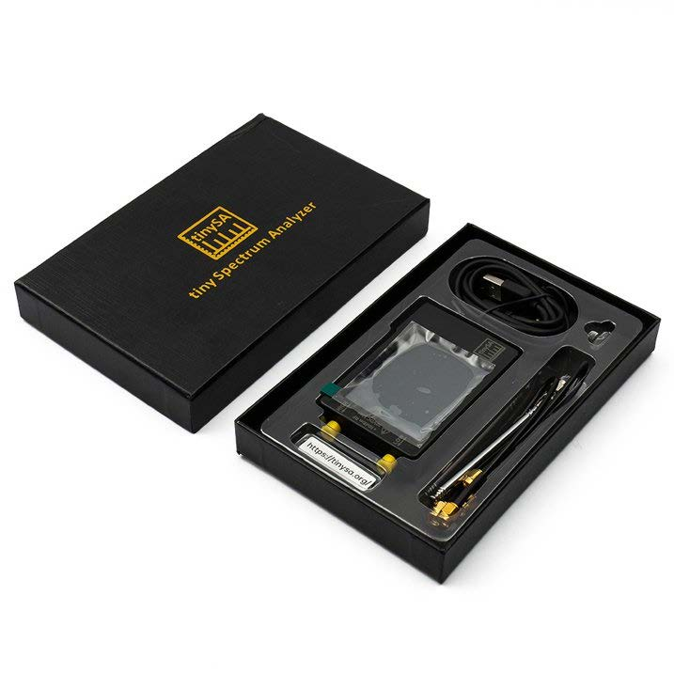
[picture p61: figure]

ภาพที่ 34 Spectrum Analyzer

28

ตารางที่ 1 กำลังไฟฟา ของ RX Coil เทียบกับมุมบน TX Coil

มุมบน TX Coil (องศา) | คากำลังไฟฟาบน RX Coil (dBm)
0 | 24.9
15 | 23.4
30 | 13.4
45 | 17.9
60 | -4.1
75 | 19.4
90 | 7.4
105 | 0.4
120 | 6.9
135 | 3.4
150 | -5.1
165 | -3.6
180 | 6.4
195 | 12.4
210 | 9.4
225 | 8.4
240 | 11.9
255 | 13.9
270 | 6.4
285 | 15.4
300 | 20.4
315 | 20.9
330 | 13.4
345 | 21.9

29

จากตารางที่ 1 เมื่อนำคากำลังไฟฟาบน RX Coil ในหนวย dBm มาเปรียบเทียบกับผลตางของมุมของขดลวดบน TX Coil ที่ 15 องศา จะแสดงใหเห็นความสัมพันธเปนกราฟ ดังภาพที่ 35

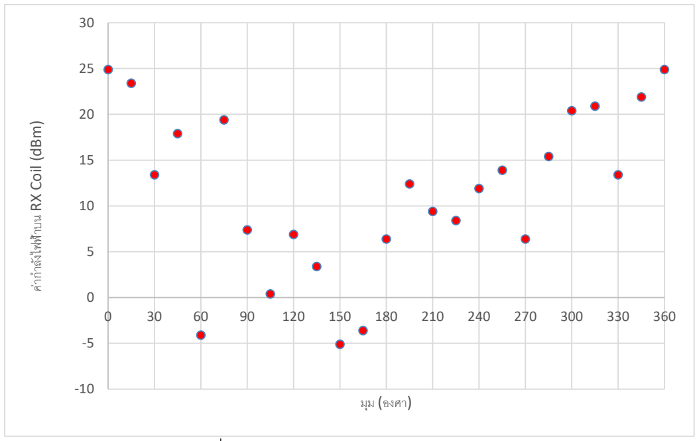
[picture p62: figure]
ค่ากําลังไฟฟ้าบน RX Coil (dBm); มุม (องศา)

ภาพที่ 35 กำลังไฟฟา ของ RX Coil เทียบกับมุมบน TX Coil 5.2.วงจรฝงรับกำลังไฟฟา
วงจรฝงรับกำลังไฟฟาจะใชวงจรเรียงกระแสประเภทเต็มคลื่นแบบบริดจ (Full Wave Bridge Rectifier Circuit) เพื่อแปลงไฟฟากระแสสลับเปนไฟฟากระแสตรงเนื่องจากมอเตอรที่ขับเคลื่อนลอรถเปนมอเตอรกระแสตรง ซึ่งออกแบบ โดยใชโปรแกรม EasyEDA ดังภาพที่ 36 ใหCapacitor มีคาความจุสูงสำหรับเก็บปริมาณประจุตอ1 หนวยแรงดันไฟฟาไดมาก เพื่อที่จะจายไฟตรงใหกับมอเตอรโดยตอ Capacitor ขนานกับมอเตอรเพื่อรักษาแรงดันที่ ตองการจายใหกับมอเตอรคงที่
ไฟฟากระแสตรง (DC Current) นั้นควรจะมี แรงดันกระเพื่อม (Voltage Ripple) นอย ไดแรงดันตาม ที่ตองการเมื่อเขาสู สภาวะคงที่ (Steady State) และควรจะมี Transient Time ต่ำ และมี Overshoot ต่ำในสวน D1 D2 D3 D4 คือไดโอด U1 คือ SMA Connector ที่ใชเชื่อมตอกับ SMA Connector ของ RX Coil โดยไดโอดที่ใชคือ 1N5819 ทนกระแสไฟฟาไดสูงสุด 1A และมี Breakdown Voltage อยูที่ 40V จึงทนกำลังไฟฟาได40W ซึ่งการขยาย กำลังไฟฟาจากAmplifierขยายไดมากที่สุดไมเกิน 4.16W จึงสามารถใชงานไดโอดนี้ได
Capacitor รวมคาความจุไฟฟาไดเปน 4,400 uF และไดใชแรงดันจากแหลงจายไฟฟากระแสตรงที่เชื่อมตอกับ Oscillator Circuit 13 V เพื่อทำใหเก็บประจุไฟฟาไดมากขึ้น และเก็บพลังงานไดมากขึ้น
0 | 30 | 60 | 90 | 120 150 180 210 240 270 300 330 360

30

ในการออกแบบ ไดเคลือบพื้นที่ทองแดงเปน GND ทั้ง TOP Layer และ Bottom Layer และไดใช Via เชื่อม GND ของทั้งสองชั้นเขาดวยกัน เพื่อปองกันสัญญาณรบกวน หลังจากสั่งทำแลวจะไดชิ้นงานดังภาพที่ 37

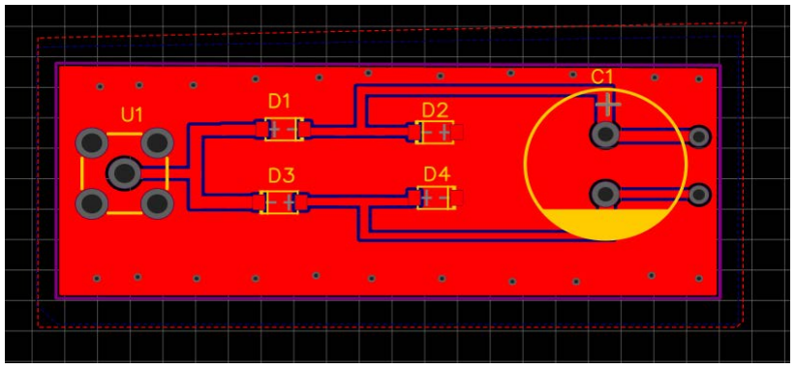
[picture p63: figure]

ภาพที่ 36 แบบวงจรฝงรับกำลังไฟฟาโดยใช Full Wave Bridge Rectifier Circuit

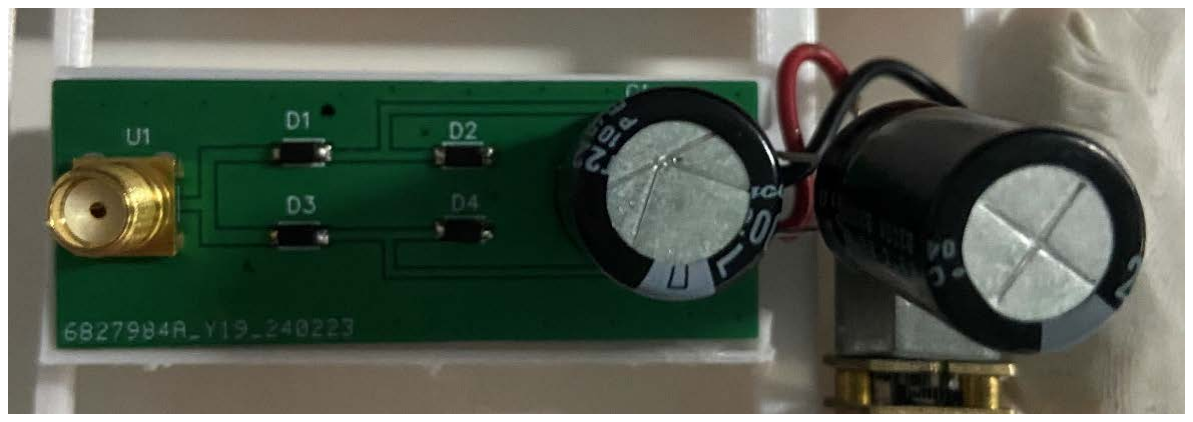
[picture p64: figure]

ภาพที่ 37 ชิ้นงาน Full Wave Bridge Rectifier Circuit

ในสวนของมอเตอรดังภาพที่ 38 ที่ขับเคลื่อนลอรถนั้นจะใชมอเตอรแรงดัน 6 Vdc จำนวน 1 ตัวเพื่อขับเคลื่อนลอ

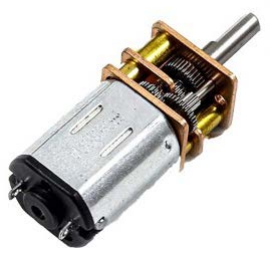
[picture p65: figure]

ภาพที่ 38 มอเตอรแรงดัน 6V

31

5.3.ชิ้นงาน 3 มิติ

### 5.3.1. การออกแบบชิ้นงาน 3 มิติ

ในการออกแบบชิ้นงาน 3 มิติ ไดใชโปรแกรม Autodesk Fusion ในการออกแบบ ซึ่งชิ้นงานประกอบดวย 2 สวน ดังนี้
1. โมเดลรถ จะประกอบดวย
- โครงสรางโมเดลรถ จะมีลักษณะดังภาพที่ 39 โดยจะตองออกแบบใหมีขนาดเล็กและน้ำหนักเบาเพื่อใหมอเตอร สามารถขับเคลื่อนตัวรถได และยังตองสามารถประกอบ PCB ทั้ง RX Coil และ Rectifier ใหติดกับตัวรถไดรวมถึง มอเตอรขับเคลื่อนดวย

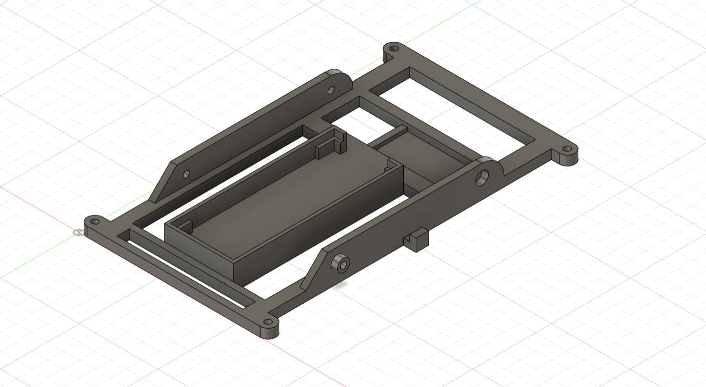
[picture p66: figure]

ภาพที่ 39 โครงสรางโมเดลรถ

- ลอขับเคลื่อน จะมี 2 สวนคือ ลอที่สวมกับมอเตอรจะมีรูที่ตองแนนพอดีกับเพลาของมอเตอรดังภาพที่ 40 และ ลออื่นๆจะหมุนอิสระดวยการสวมตลับลูกปน (Ball Bearing) เขาไปทางชองวงกลมบริเวณแกนลอ ดังภาพที่ 41

32

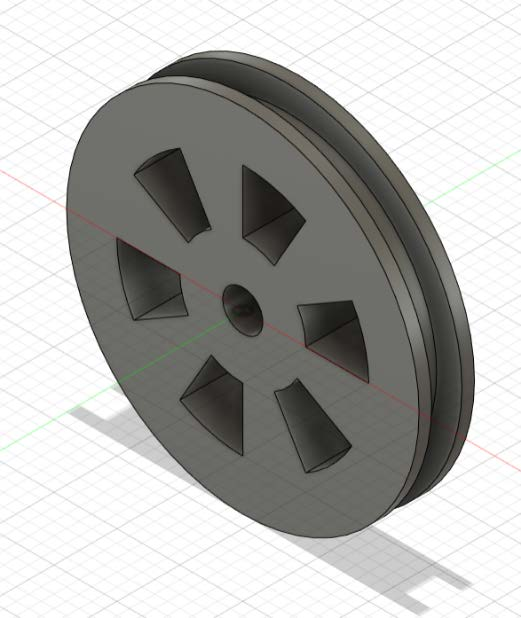
[picture p67: figure]

ภาพที่ 40 ลอที่สวมกับมอเตอร

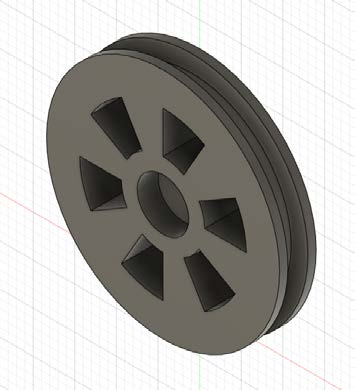
[picture p68: figure]

ภาพที่ 41 ลออื่นๆที่หมุนอิสระดวยการสวมตลับลูกปน (Ball Bearing)

- ลอขาง จะมีลักษณะดังภาพที่ 42 โดยมีการหมุนอิสระดวยการสวมตลับลูกปน (Ball Bearing) เขาไปทางชอง วงกลมบริเวณแกนลอ ซึ่งจะทำหนาที่ควบคุมตัวรถใหเคลื่อนที่ตามเสนทางของรางได

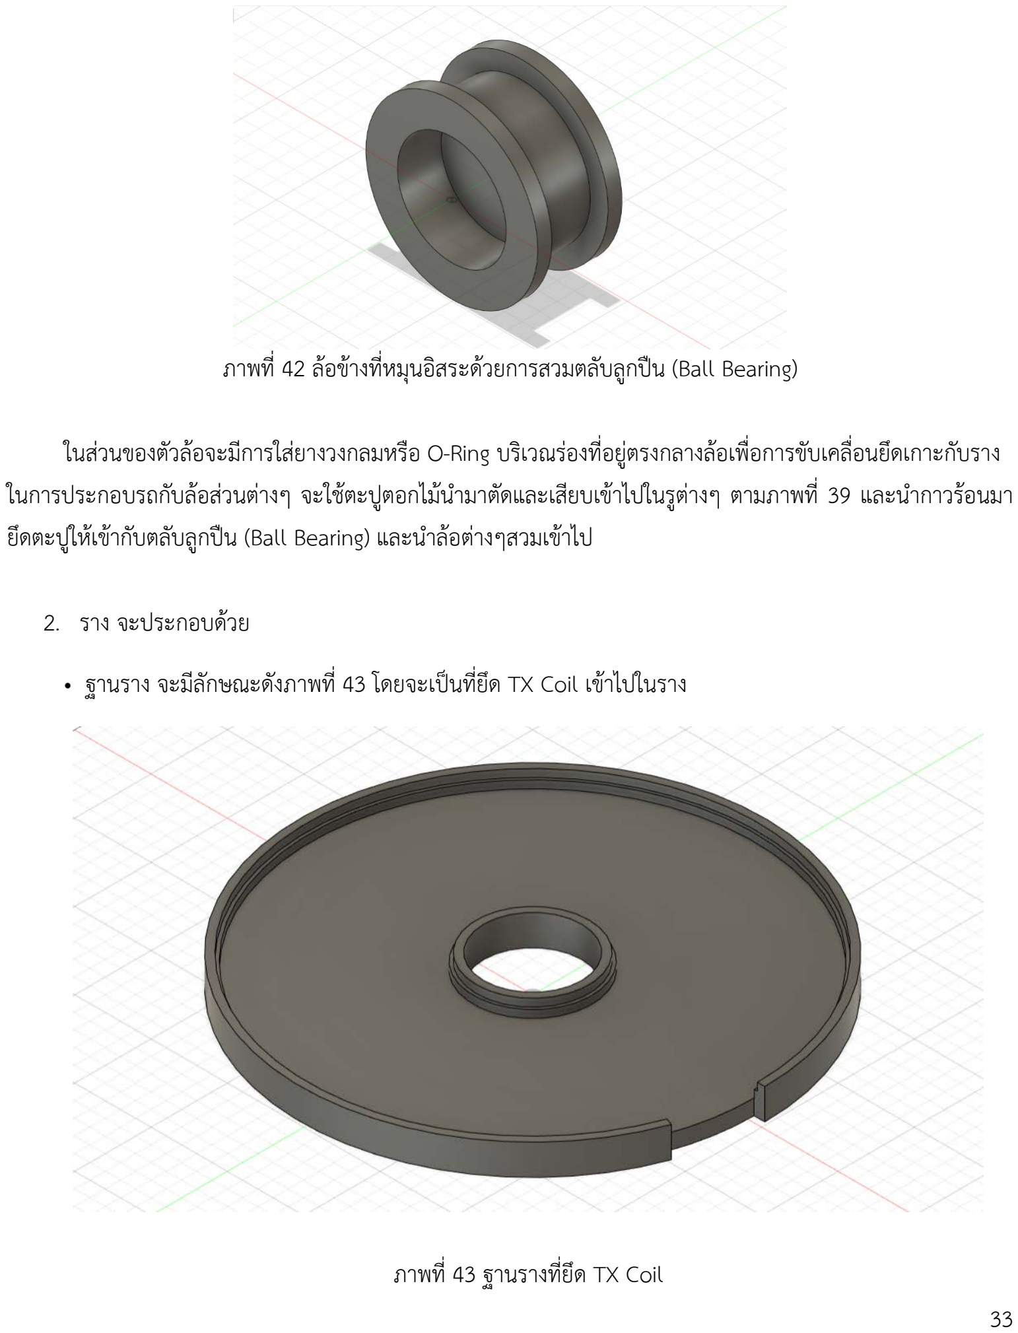
[picture p69: page 44]

33

ภาพที่ 42 ลอขางที่หมุนอิสระดวยการสวมตลับลูกปน (Ball Bearing)

ในสวนของตัวลอจะมีการใสยางวงกลมหรือ O-Ring บริเวณรองที่อยูตรงกลางลอเพื่อการขับเคลื่อนยึดเกาะกับราง ในการประกอบรถกับลอสวนตางๆ จะใชตะปูตอกไมนำมาตัดและเสียบเขาไปในรูตางๆ ตามภาพที่ 39 และนำกาวรอนมา ยึดตะปูใหเขากับตลับลูกปน (Ball Bearing) และนำลอตางๆสวมเขาไป

2. ราง จะประกอบดวย
- ฐานราง จะมีลักษณะดังภาพที่ 43 โดยจะเปนที่ยึด TX Coil เขาไปในราง

ภาพที่ 43 ฐานรางที่ยึด TX Coil

34

- ตัวราง จะมีลักษณะดังภาพที่ 44 โดยจะวางทับตัวฐานรางที่ยึด TX Coil อยู เพื่อเปนเสนทางใหรถขับเคลื่อน

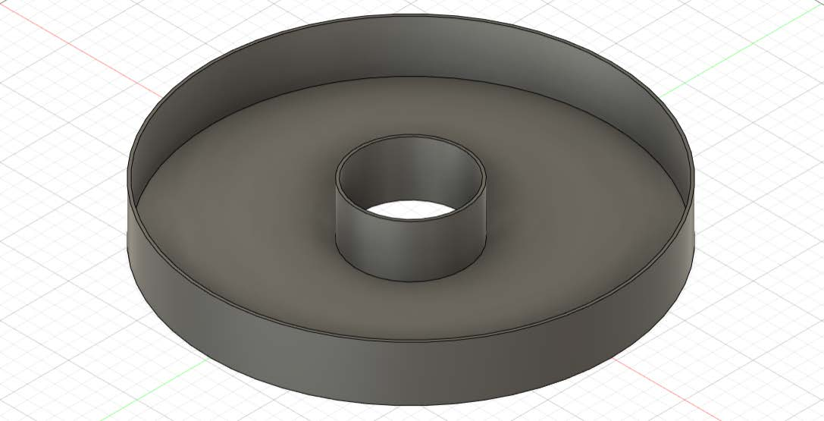
[picture p70: figure]

ภาพที่ 44 ตัวรางที่เปนเสนทางใหรถขับเคลื่อน

### 5.3.2. การพิมพ 3 มิติจะมีขั้นตอนดังนี้

1. หลังจากออกแบบชิ้นงาน 3 มิติแลว จะดาวนโหลดไฟลจาก Autodesk Fusion เปนไฟลนามสกุล .3mf
2. นำไฟลนามสกุล .3mf ไปเปดในโปรแกรม Ultimaker Cura เพื่อจะเตรียมการพิมพ3 มิติโดยใน Cura จะตอง ตั้งคาตางๆเพื่อเตรียมความพรอมในการพิมพซึ่งภายในซอฟตแวรนี้จะมีการบอกความยาวของเสนพลาสติกPLA ที่ตองใช และเวลาที่ตองใชในการพิมพดังภาพที่ 45

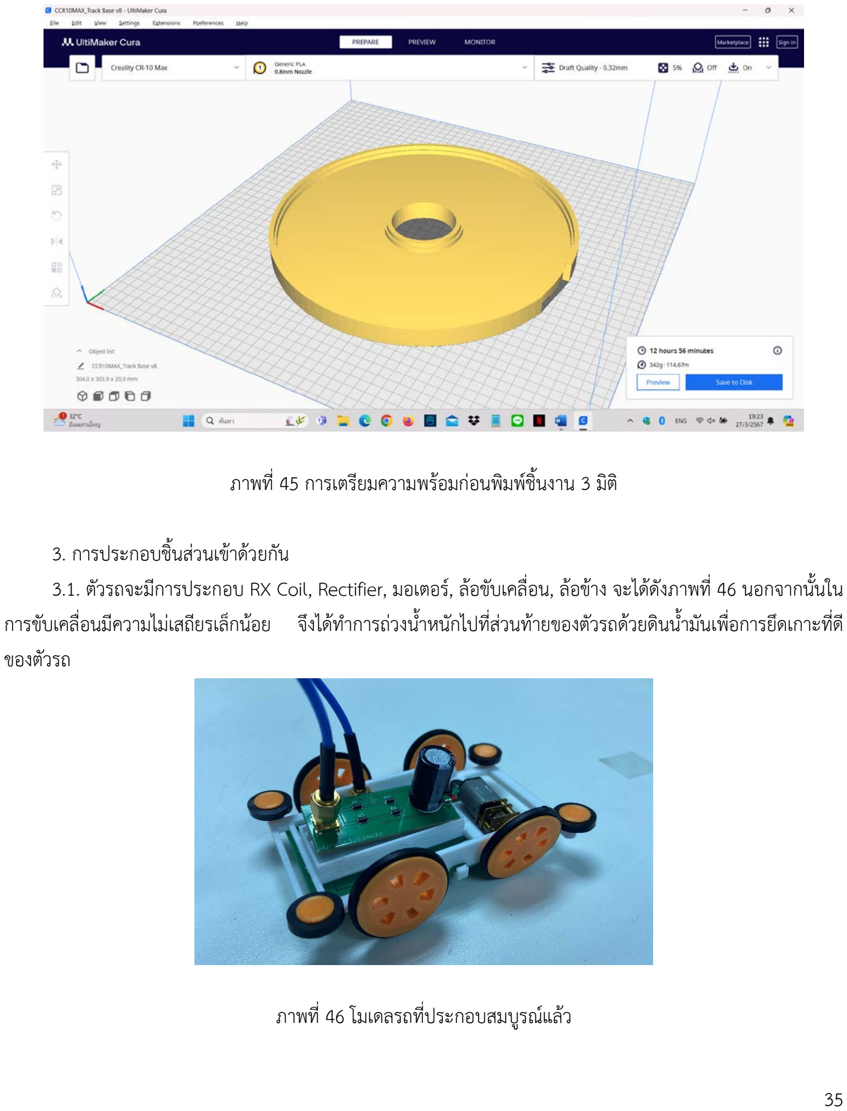
[picture p71: page 46]

35

ภาพที่ 45 การเตรียมความพรอมกอนพิมพชิ้นงาน 3 มิติ

3. การประกอบชิ้นสวนเขาดวยกัน
3.1. ตัวรถจะมีการประกอบ RX Coil, Rectifier, มอเตอร, ลอขับเคลื่อน, ลอขาง จะไดดังภาพที่46 นอกจากนั้นใน การขับเคลื่อนมีความไมเสถียรเล็กนอย จึงไดทำการถวงน้ำหนักไปที่สวนทายของตัวรถดวยดินน้ำมันเพื่อการยึดเกาะที่ดี ของตัวรถ

ภาพที่ 46 โมเดลรถที่ประกอบสมบูรณแลว

36

3.2. ราง จะทำการประกอบเปนชั้นๆ ไดแก ฐานราง, TX Coil, ตัวราง ตามลำดับ ดังภาพที่ 47

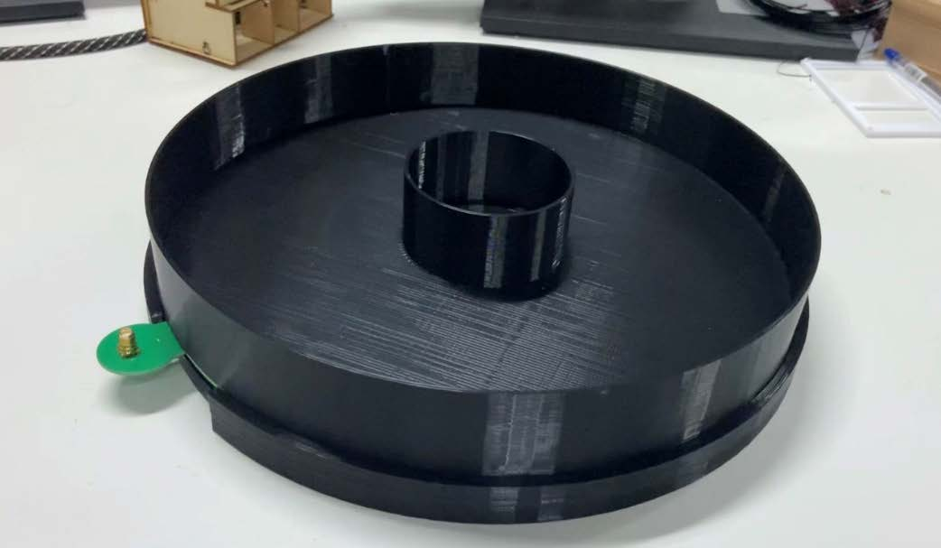
[picture p72: figure]

ภาพที่ 47 ตัวรางที่ประกอบสมบูรณแลว

37

## 6 สรุปผลการดำเนินงานและขอเสนอแนะ

DC Generator ทำงานที่ 13 V 0.34 A ไดเปนอยางดี Oscillator Circuit เมื่อปรับคาจนไดกำลังไฟฟาขาออก สูงสุด และไดความถี่ 13.56 MHz ตามที่ตองการและทำงานไดเปนอยางดี Amplifier Circuit เมื่อเชื่อมตอกับแหลงจาย ไฟฟากระแสตรง 13 V พบวา โดยเกิดความรอนขึ้นมาแตยังคงสามารถเพิ่มกำลังไฟฟาได SMA Cable มีความยาวไมมาก เกินไป และเมื่อใชงานกับไฟฟากระแสสลับความถี่ต่ำจึงเกิดการสูญเสียต่ำ โดยทำงานไดเปนอยางดี
SMA Connector มีการเชื่อมตอเขากับ Coil และ Rectifier Circuit ไดเปนอยางดี ไมหลุดหลวม การบัดกรีใน สวนตางๆ ทำไดเปนอยางดี จุดเชื่อมตอมีความแข็งแรง เชื่อมตอทางไฟฟาไดอยางมีเสถียรภาพ TX Coil ขดลวดที่อยูใกล SMA Connector มีการสงกำลังไฟฟาที่มาก สวนขดลวดที่อยูไกลจาก SMA Connector มีการสงกำลังไฟฟาลดต่ำลง บริเวณรอยตอระหวางขดลวดบางสวน มีการออกแบบระยะหางไมสม่ำเสมอ จึงทำใหมีการเหนี่ยวนำในบางบริเวณ ลดนอยลง แต RX Coil, TX Coil, Rectifier Circuit ในภาพรวมทำงานไดดี โดยที่มีแรงดันตกครอมที่ไดโอดในระดับที่ ใชไดซึ่งไดโอดเกิดความผิดปกติเล็กนอยเมื่อใชงานกับไฟฟากระแสสลับความถี่สูง Capacitor ทำการเก็บประจุไฟฟา และสงพลังงานใหแกมอเตอรไฟฟากระแสตรง ไดเปนอยางดี
DC Motor มีความเร็วในการหมุนสูง ซึ่งไดรับพลังงานไฟฟาและไดรับแรงดันไฟฟามากเพียงพอที่จะใชงานกับ มอเตอรชนิดนี้ได ดวยเหตุนี้จึงทำใหรถสามารถวิ่งบนรางไดครบรอบวงกลมและสามารถวิ่งตอไปไดเรื่อยๆ โดยไมหยุด

ขอเสนอแนะเพิ่มเติม
1. Test Coil ควรจะออกแบบ Coil และ Connector ใหเหมือนกันทั้งฝงซายและขวา
2. เพิ่มทางเลือกในการออกแบบคือ ออกแบบ Coil และ Connector ดวย Copper Area โดยกำหนด Net = GND
3. ออกแบบให Copper Bottom Layer บริเวณรอบๆ PAD ที่มีสัญญาณ ลอมรอบ PAD ในรูปแบบวงกลม
4. ไดมีการใช Footprint SMA Connector โดย 4 PAD รอบๆทำหนาที่เปน GND และ PAD ตรงกลางทำหนาที่เปนชองทาง Signal
5. เพิ่มพื้นที่บัดกรีสำหรับ Capacitor ใน Test Coil และ Rx Coil
6. ทดสอบ Export Gerber File จาก EasyEDA แลวนำมา Import Gerber File เขาไปใน Sonnet เพื่อ Simulation สำหรับหาคา L
7. ออกแบบ Rx Coil ใน Sonnet ใหมีขนาดแมนยำมากที่สุดตามที่ตองการ และเพิ่ม Connector เขาไป
8. การระบายความรอนของ Amplifier Circuit อาจจะไมดีมากพอ จึงตองหาวิธีระบายความรอนใหมีประสิทธิภาพ
9. นำวงจรฝง TX Coil เขากลองซึ่งมีการระบุ ขาที่ตองตอแรงดันไฟฟา และขาที่เปน GND ไดอยางชัดเจน

38

10. ในสวนของการพิมพชิ้นงาน 3 มิติ ควรมีการพิมพชิ้นงานทดสอบสำหรับความคลาดเคลื่อนของเครื่องพิมพ 3 มิติ (คลาดเคลื่อนประมาณ 0.2-0.4 มิลลิเมตร)
11. ในสวนของตัวรถควรออกแบบโดยคำนึงถึงความสมดุลของตัวรถสำหรับการขับเคลื่อน ทั้งนี้ควรออกแบบและ พิมพใหสมบูรณ โดยไมตองมีชิ้นสวนเพิ่มเติม เชน ดินน้ำมัน

39

## 7 บรรณานุกรม

[1] T. Wisessri and C. Promsatarporn, ''Demonstration of Resonant Wireless Power Transfer using Toy Racing Cars and Tracks,'' B.Eng. Senior Project, Kasetsart University, Thailand, 2022.
[2] C. Rakluea, A. Worapishet, S. Chaimool, Y. Zhao, and P. Akkaraekthalin, “True nulls-free magnetoinductive waveguides using alternate coupling polarities for batteryless dynamic wireless power transfer applications,” IEEE Trans. Power Electron., vol. 37, no. 8, pp. 8835–8854, 2022.
[3] “วงจรเรียงกระแส คืออะไร?,” ชางไฟดอทคอม | ทีมงานชางไฟฟาที่ดีที่สุดในกรุงเทพฯ, 18-Nov-2021. [Online].
Available: https://www.changfi.com/fix/2021/11/18/14296/. [Accessed: 11-Oct-2023].
[4] Digikey.co.th. [Online]. Available: https://www.digikey.co.th/th/articles/the-smith-chart-an-ancient-graphical-tool-still-vital-in-rf-design. [Accessed: 29-Mar -2024].

40

## ประวัตินิสิต

1. ชื่อ-นามสกุล: นายกรวิชญ รังสาคร เลขประจำตัวนิสิต: 6310551400
ภาควิชาวิศวกรรมไฟฟา คณะวิศวกรรมศาสตร มหาวิทยาลัยเกษตรศาสตร
ที่อยูปจจุบัน: 27 ซอยเจริญพัฒนา1 รามอินทรา117 แขวงบางชัน เขตคลองสามวา กรุงเทพมหานคร 10510 โทรศัพทเคลื่อนที่: 083-2598722
E-mail: koravich.ru@ku.th
ระดับการศึกษา:
คุณวุฒิการศึกษา | โรงเรียน/สถาบัน | ปการศึกษาที่จบ
มัธยมศึกษาตอนปลาย | โรงเรียนบดินทรเดชา (สิงห สิงหเสนี) 2 | พ.ศ.2562
มัธยมศึกษาตอนตน | โรงเรียนบดินทรเดชา (สิงห สิงหเสนี) 2 | พ.ศ.2559
2. ชื่อ-นามสกุล: นายศุภกร ธัญญหาญ เลขประจำตัวนิสิต: 6310551884
ภาควิชาวิศวกรรมไฟฟา คณะวิศวกรรมศาสตร มหาวิทยาลัยเกษตรศาสตร
ที่อยูปจจุบัน: 12/125 หมูบานพฤกษาวิลเลจ12 ถนนเรียบคลองสอง ตำบลคลองสอง อำเภอคลองหลวง จังหวัด ปทุมธานี 12120
โทรศัพทเคลื่อนที่: 080-1496515
E-mail: supakorn.tany@ku.th
ระดับการศึกษา:
คุณวุฒิการศึกษา | โรงเรียน/สถาบัน | ปการศึกษาที่จบ
มัธยมศึกษาตอนปลาย โรงเรียนสวนกุหลาบวิทยาลัย รังสิต | พ.ศ.2562
มัธยมศึกษาตอนตน | โรงเรียนสวนกุหลาบวิทยาลัย รังสิต | พ.ศ.2559

41

3. ชื่อ-นามสกุล: ศุภกร พงษธีระพล เลขประจำตัวนิสิต 6310551892
ภาควิชาวิศวกรรมไฟฟา คณะวิศวกรรมศาสตร มหาวิทยาลัยเกษตรศาสตร
ที่อยูปจจุบัน: 129 ม.กมลวรรณ ซ.คูบอน 20 ถ.รามอินทรา กม.8 แขวงรามอินทรา เขตคันนายาว กรุงเทพฯ 10230
โทรศัพทเคลื่อนที่: 091-0584775
E-mail: Supakorn.phon@ku.th
ระดับการศึกษา:
คุณวุฒิการศึกษา | โรงเรียน/สถาบัน | ปการศึกษาที่จบ
มัธยมศึกษาตอนปลาย | โรงเรียนบดินทรเดชา (สิงห สิงหเสนี) 2 | พ.ศ.2562
มัธยมศึกษาตอนตน | โรงเรียนบดินทรเดชา (สิงห สิงหเสนี) 2 | พ.ศ.2559
