dcwaiot/KU-WPT/2023/Report,poster,summary,presentation/EE2023DCW-02_summary.pdf

## พลวัตของรถยนตพลังงานไฟฟาไรสายขนาดเล็กในเชิงวิศวกรรมไฟฟา The Dynamic of Mini Wireless Electric Energy Car in Electrical Engineering

### กรวิชญ รังสาคร, ศุภกร ธัญญหาญ, ศุภกร พงษธีระพล ผศ.ดร.เดนชัย วรเศวต

ภาควิชาวิศวกรรมไฟฟา คณะวิศวกรรมศาสตร มหาวิทยาลัยเกษตรศาสตร โทร. 0-2549-3429, 0-2549-3420 โทรสาร 0-2549-3422 E-mail: fengntk@ku.ac.th

### บทคัดยอ

โครงงานวิศวกรรมไฟฟาฉบับนี้ กลาวถึงการสงกำลังไฟฟาแบบ ไรสายโดยใชทฤษฎีคลื่นแมเหล็กไฟฟาในกฎของแอมแปรผานขดลวดสอง ชุด โดยจะแสดงใหเห็นผานการเคลื่อนที่ของโมเดลรถ ซึ่งจะแบงวงจรเปน 3 สวนไดแก สวนแรกคือวงจรฝงสงกำลังไฟฟา จะมีการใชแรงดันขนาด 13 โวลตเปนกระแสสลับโดยใชความถี่ 13.56 MHz รวมถึงมีการขยาย สัญญาณเพื่อเพิ่มขนาดกำลังไฟฟาไปยังขดลวดฝงสงเพื่อใหเหมาะสมใน การสงกำลังไฟฟา สวนที่สองคือขดลวดทั้งฝงสง-ฝงรับกำลังไฟฟาเปนสวน ที่สำคัญในการสงกำลังไฟฟาโดยใชทฤษฎีคลื่นแมเหล็กไฟฟาในการสง กำลังไฟฟา โดยขดลวดฝงสงจะติดอยูกับตัวราง และขดลวดฝงรับจะติดอยู ใตทองรถ ซึ่งใชโปรแกรม Sonnet ในการออกแบบ โดยสามารถสง กำลังไฟฟาไดสูงสุด 4.16 วัตต และสวนสุดทายวงจรฝงรับกำลังไฟฟาจะมี การใชวงจรเรียงกระแสเพื่อแปลงไฟฟากระแสสลับเปนไฟฟากระแสตรง เนื่องจากกำลังที่สงมาเปนกระแสสลับจึงตองแปลงเปนกระแสตรงเพื่อให สามารถใชกับมอเตอรกระแสตรงที่ใชขับเคลื่อนลอรถได โดยใชมอเตอร 1 ตัวเพื่อขับเคลื่อนลอหลังทางดายซาย และมีการใชตัวเก็บประจุเพื่อเปนตัว เก็บพลังงานที่จะใชจายเขามอเตอร

คำสำคัญ: การสงพลังงานไฟฟาแบบไรสาย, ทฤษฎีคลื่นแมเหล็กไฟฟา, พลวัตของรถยนต, ทอนำคลื่นแบบเหนี่ยวนำแมเหล็ก

### Abstract

This senior project report presents wireless transfer power by using Electromagnetic Wave Theory in Ampere's Law to use the 2 sets of coils. It is shown by car model driving. There are 3 parts to this project. The first is a power transmitter circuit using 13 volts in alternating current and used frequency of 13.56 MHz And increased power of a signal to the transmitter coil for suitability in wireless transfer power. The next is the 2 sets of coils, the transmitter coil and the receiver coil. They are very important things in wireless transfer power by using Electromagnetic Wave Theory. The transmitter coil dovetails with the track and the receiver coil dovetails with the car model. The software that is used to design the 2 sets of the coils is Sonnet. And maximum power that can transfer in wireless is 4.16 watts. The last part is the receiver circuit, which uses a rectifier circuit to convert alternating current to direct current because the coils transfer the power in alternating current.

Keywords: Wireless Power Transfer, Electromagnetic Wave Theory, The Dynamic of Car, Magneto inductive waveguide

### 1. บทนำ

เนื่องจากปญหาขาดแคลนน้ำมัน และปญหาสภาวะโลกรอน สาเหตุหนึ่งเกิดมาจากการเผาไหมเชื้อเพลิง เชน น้ำมัน ทำใหเกิดควันไอ เสียออกมาจากทอของรถยนตสันดาป จึงมีการคิดคนรถยนตพลังงานไฟฟา ขึ้นมา เพื่อมาแกไขปญหานี้ ซึ่งการกักเก็บพลังงานของรถยนตไฟฟาใน ปจจุบัน จำเปนตองมีเครื่องชารจประจุไฟฟาซึ่งติดตั้งอยูกับที่ และเชื่อมตอ เขากับรถยนตพลังงานไฟฟาดวยสายไฟฟา ซึ่งตองใชเวลามากพอสมควรใน การกักเก็บพลังงานไฟฟาเขาแบตเตอรี่ของรถยนตพลังงานไฟฟา โครงงาน วิศวกรรมไฟฟานี้ จึงไดออกแบบระบบรับ-สงพลังงานไฟฟาแบบไรสาย จึง ทำใหประหยัดเวลาในการชารจประจุไฟฟา ไมจำเปนตองจอดรถยนต พลังงานไฟฟาใหอยูนิ่ง เพื่อเชื่อมตอเขากับเครื่องชารจประจุไฟฟา เหมือน อยางเดิมอีกตอไป โครงงานวิศวกรรมไฟฟานี้ เปนสวนตอยอดมาจาก โครงงานวิศวกรรมไฟ ฟ า ชื่อเรื่อง Demonstration of Resonant Wireless Power Transfer using Toy Racing Cars and Tracks (Wisessri and Promsatarporn, 2022) ซึ่งมีขอจำกัดที่ ความเสถียรและ สมรรถนะในการขับเคลื่อนของรถยนตพลังงานไฟฟาไรสาย ยังไมเพียงพอ และ สามารถขับเคลื่อนไดบนเสนทางตรง แตยังไมสามารถขับเคลื่อนบน เสนทางโคงได[3:62] โครงงานนี้สามารถนำไปประยุกตใชในระบบ คมนาคมขนสง โดยการติดตั้งขดลวดสงพลังงานไฟฟาไรสาย ใตพื้นถนน และติดตั้งขดลวดรับพลังงานไฟฟาไรสาย บริเวณใตทองรถยนตพลังงาน ไฟฟาไรสาย หรือนำขดลวดสงพลังงานไฟฟาไรสาย ไปติดตั้งใตรางรถไฟฟา ขนสงมวลชน และ นำขดลวดรับพลังงานไฟฟาไรสาย ไปติดตั้งบริเวณใต ทองรถไฟฟาขนสงมวลชน ทำใหสามารถชารจประจุไฟฟาใหแก ยานพาหนะ ในขณะที่ยานพาหนะกำลังขับเคลื่อนอยูได โดยไมตองจอด

ยานพาหนะหยุดนิ่ง และชารจประจุไฟฟาเขากับยานพาหนะ ซึ่งตองใช เวลานาน ซึ่งจะมีประโยชนอยางมากสำหรับยานพาหนะที่ตองการใชงาน อยางเรงดวน เชน รถพยาบาล ซึ่งการใชเวลาเดินทางที่นอย มีความสำคัญ มากตอการรอดชีวิตของผูปวย หรือ รถไฟฟาขนสงมวลชน ที่มีความ ตองการใชงานอยางหนักและตอเนื่องในชั่วโมงเรงดวน เชน ชวงเวลาเชา ที่ มีผูโดยสารจำนวนมาก เดินทางไปยังสถานที่ทำงาน และ ชวงเวลาเย็นที่มี ผูโดยสารจำนวนมาก เดินทางกลับที่พัก

### 1.1.วัตถุประสงค

สามารถสงกำลังไฟฟาแบบไรสายไดอยางมีประสิทธิภาพ โมเดลรถสามารถเคลื่อนที่ไดอยางเสถียรและสามารถเคลื่อนที่ตามทิศทาง ของรางไดและยังสามารถออกแบบอุปกรณหรือชิ้นสวนตางๆเพื่อนำไป ประยุกตใชในงานที่ระดับใหญขึ้นได

### 1.2. ขอบเขตของโครงงาน

โครงงานนี้จะแสดงใหเห็นวาการสงกำลังไฟฟาแบบไรสาย สามารถทำไดจริงและมีประสิทธิภาพ โดยใชขดลวดเปนอุปกรณในการรับ-สงกำลังไฟฟา ขดลวดฝงสงจะติดที่รางของโมเดลรถและขดลวดฝงรับจะติด อยูกับตัวโมเดลรถและเชื่อมตอกับมอเตอรที่ขับเคลื่อนลอรถ ซึ่งโมเดลรถ จะเคลื่อนที่ไดอยางเสถียรและสามารถเคลื่อนที่ตามทิศทางของรางได โดย ตัววงจรของโครงงานครั้งนี้จะแสดงใหเห็นดังภาพที่ 1

ภาพที่ 1 วงจรสงกำลังไฟฟาแบบไรสายที่ใชในโครงงานนี้

### 2. ทฤษฎีที่เกี่ยวของ

ในโครงงานนี้ไดใชทฤษฎีตางๆ ในการออกแบบระบบสง กำลังไฟฟาแบบไรสายซึ่งใชขดลวดฝงสงหรือ Transmitter Coil สงไปยัง ขดลวดฝงรับหรือ Receiver Coil แบบไรสายที่ความถี่ 13.56MHz

### 2.1. ทฤษฎีคลื่นแมเหล็กไฟฟา

จากกฎของแอมแปร เมื่อมีกระแสไฟฟาไหลในขดลวดจะทำให เกิดสนามแมเหล็กขึ้นโดยรอบขดลวด และหากสนามแมเหล็กนี้พุงผาน พื้นที่หนาตัดของขดลวดอีกชุดหนึ่ง จะทำใหเกิดการเปลี่ยนของฟลักซ แมเหล็ก (ฟลักซแมเหล็ก คือปริมาณสนามแมเหล็กในพื้นที่พื้นที่หนึ่ง) ซึ่ง จะทำใหเกิดสนามไฟฟาขึ้นในขดลวดชุดนั้นๆ ในขดลวดชุดดังกลาวจะมี อิเล็กตรอนอยู เมื่อเกิดสนามไฟฟาจะทำใหเกิดแรงไฟฟากระทำกับ อิเล็กตรอนภายในขดลวด ดังนั้นอิเล็กตรอนจะเกิดการเคลื่อนที่ไปตาม ขดลวด จึงทำใหเกิดกระแสไฟฟาขึ้นในขดลวดชุดนั้นๆ

### 2.2. คุณสมบัติทอนำคลื่น

คำนวณคาความตานทานของขดลวดรับ-สงพลังงานไฟฟาไร สาย มีหนวยเปน ohms ไดจากสมการที่ 1

(1)

เมื่อ f คือ ความถี่ของคลื่นแมเหล็กไฟฟา มีคาเทากับ 13.56 MHz L คือ Self Inductance มีหนวยเปน Henry [1:8847]

### 2.3. ขดลวด (Coil)

| ขดลวดในโครงงานนี้คือ ลายทองแดงตอกันเปนวงกลม บน
PCB Board ชนิด FR4 หนา 1.6 mm เปรียบเสมือนขดลวดเหนี่ยวนำ อันหนึ่ง ที่สงผานสนามแมเหล็ก และเหนี่ยวนำใหเกิดกระแสไฟฟาตอไป เรื่อย ๆจนครบวง ซึ่ง PCB Board นี้จะวางประกบกับรางรถ Tamiya เพื่อ ทำหนาที่ถายโอนพลังงานไปยังตัวรถ มีการตอ Capacitor เขาไปอนุกรม กับ Coil เพื่อทำใหเกิด Resonance ไดกระแสไฟฟาในวงจรสูงที่สุด เนื่องจาก ไมมี Reactance และไมมี Imaginary Power จึงทำใหได Real Power สูงที่สุด โดยลักษณะการเชื่อมตอของ Coil มีทั้งแบบที่เชื่อมตอบน Layer เดียวกัน และ เชื่อมตอกันระหวาง Layer

### 2.4. วงจรเรียงกระแส (Rectifier Circuit)

| วงจรเรียงกระแส (Rectifier Circuit) คือวงจรไฟฟาที่มี
คุณสมบัติในการแปลงสัญญาณกระแสสลับใหกลายเปนสัญญาณไฟฟา กระแสตรงหรือมีคุณสมบัติยอมใหไฟฟาไหลผานไปในทิศทางใดทิศทาง หนึ่งอุปกรณที่นิยมใชในการแปลงสัญญาณไดแก ไดโอด (Diode) ซึ่งใน โครงงานนี้เลือกออกแบบวงจรบริดจ (Full – Wave Bridge Rectifier) ซึ่ง เปนวงจรที่มีการใชไดโอด 4 ตัว ดังภาพที่ 2

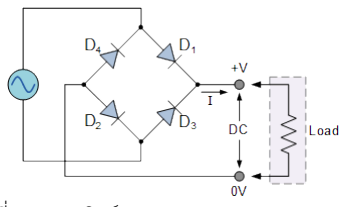
[picture p73: figure]

ภาพที่ 2 วงจรบริดจ (Full – Wave Bridge Rectifier)

### 3. ขั้นตอนการดำเนินโครงงาน

1. ศึกษาการสงกำลังไฟฟาแบบไรสาย
2. ออกแบบขดลวดฝงสง ขดลวดฝงรับ และวงจรเรียงกระแส
3. สั่งทำและจัดหาอุปกรณตางๆ
4. ออกแบบชิ้นงาน 3 มิติ
5. ประกอบอุปกรณทุกชิ้นเขาดวยกันและทดสอบ
6. สรุปผลของโครงงาน

### 4. ผลการดำเนินโครงงาน

เมื่อออกแบบและจัดทำ Transmitter Coil และ Receiver Coil แลวจะมีลักษณะดังภาพที่ 3 และภาพที่ 4 ตามลำดับ ในสวนของ Receiver Coil จะติดอยูใตทองโมเดลรถ ซึ่งทำการตอเขากับวงจรเรียง กระแส (Rectifier Circuit) และตอเขากับมอเตอรกระแสตรงที่ใช ขับเคลื่อนตัวรถ โดยประกอบตัวรถในสภาพที่สมบูรณ ดังภาพที่ 5 ในสวน ของ Transmitter Coil นั้น จะประกอบเขากับตัวรางโดยจะไดดังภาพที่ 6

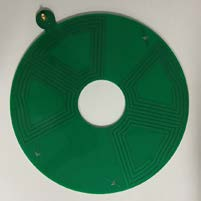
[picture p74: figure]

ภาพที่3 ขดลวดฝงสง TX Coil-Transmitter Coil

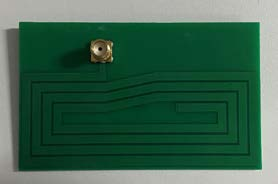
[picture p75: figure]

ภาพที่ 4 ขดลวดฝงรับ RX Coil-Receiver Coil

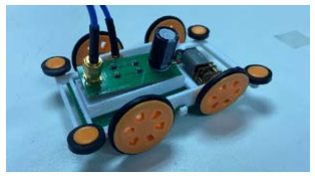
[picture p76: figure]

ภาพที่ 5 โมเดลรถที่ประกอบสมบูรณแลว

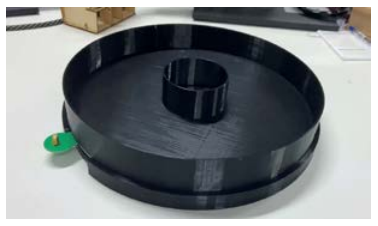
[picture p77: figure]
ภาพที่ 5 โมเดลรถที่ประกอบสมบูรณแลว

ภาพที่ 6 Transmitter Coil ที่ประกอบเขากับตัวรางแลว ในการวัดคากำลังไฟฟาบน RX Coil โดยวัดเทียบจากผลตาง มุม 15 องศา บนขดลวด TX Coil โดยตอเขากับแหลงกำเนิดไฟฟากระแส ตรง 13.0 V 0.34 A และกำหนดจุดเริ่มตนคือ ขดลวดที่อยูติดกันกับ Connector เปนมุม 0 องศา แลวเรียงลำดับการวัดแบบตามเข็มนาิกา เมื่อนำคากำลังไฟฟาบน RX Coil ในหนวย dBm เปรียบเทียบกับผลตาง

ของมุมของขดลวดบน TX Coil ที่ 15 องศา จะแสดงใหเห็นความสัมพันธ เปนกราฟ ดังภาพที่ 7

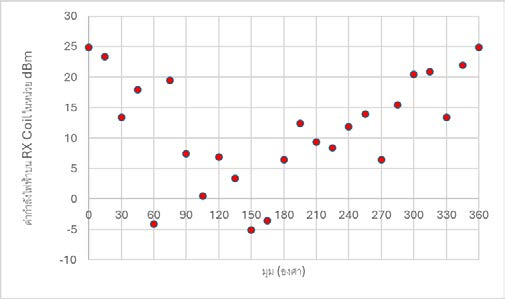
[picture p78: figure]

ภาพที่ 7 กำลังไฟฟา ของ RX Coil เทียบกับมุมบน TX Coil

### 5. สรุปผลการดำเนินงาน

DC Generator ท ำ งา น ที่ 13 V 0.34 A ได เป น อ ย างดี Oscillator Circuit เมื่อปรับคาจนไดกำลังไฟฟาขาออกสูงสุด และได ความถี่ 13.56 MHz ตามที่ตองการ ทำงานไดเปนอยางดี Amplifier Circuit เมื่อเชื่อมตอกับแหลงจายไฟฟากระแสตรง 13 V พบวา เกิดความ รอนขึ้น และยังระบายความรอนไดไมดี SMA Cable มีความยาวไมมาก เกินไป และเมื่อใชงานกับไฟฟากระแสสลับความถี่ต่ำจึงเกิดการสูญเสียต่ำ โดยทำงานไดเปนอยางดี
SMA Connector มีการเชื่อมตอเขากับ Coil และ Rectifier Circuit ไดเปนอยางดี ไมหลุดหลวม การบัดกรีในสวนตางๆ ทำไดเปน อยางดี จุดเชื่อมตอมีความแข็งแรง เชื่อมตอทางไฟฟาไดอยางมีเสถียรภาพ TX Coil ขดลวดที่อยูใกล SMA Connector มีการสงกำลังไฟฟาที่มาก สวนขดลวดที่อยูไกลจาก SMA Connector มีการสงกำลังไฟฟาลดต่ำลง บริเวณรอยตอระหวางขดลวดบางสวน มีการออกแบบ ระยะหางไมสม่ำเสมอ จึงทำใหมีการเหนี่ยวนำในบางบริเวณลดนอยลง แต RX Coil, TX Coil, Rectifier Circuit ในภาพรวมทำงานไดดี โดยที่มี แรงดันตกครอมที่ไดโอดในระดับที่ใชไดซึ่งไดโอดเกิดความผิดปกติเล็กนอย เมื่อใชงานกับไฟฟากระแสสลับความถี่สูง Capacitor ทำการเก็บประจุ ไฟฟา และสงพลังงานใหแกมอเตอรไฟฟากระแสตรง ไดเปนอยางดี
DC Motor มีความเร็วในการหมุนสูง ซึ่งไดรับพลังงานไฟฟา และไดรับแรงดันไฟฟามากเพียงพอที่จะใชงานกับมอเตอรชนิดนี้ได ดวย เหตุนี้จึงทำใหรถสามารถวิ่งบนรางไดครบรอบวงกลมและสามารถวิ่งตอไป ไดเรื่อยๆ โดยไมหยุด

### 6. กิตติกรรมประกาศ

โครงงานนี้สำเร็จลุลวงลวงไดดวยความกรุณาจาก ผศ.ดร.เดน ชัย วรเศวต ผูเปนอาจารยที่ปรึกษาโครงงานที่ไดใหขอเสนอ แนวคิดรวมถึง

การแกไขขอบกพรองตางๆ ผูจัดทำจึงขอขอบพระคุณเปนอยางสูง และ ขอขอบพระคุณ ผศ.ดร.ธนากร ฆองเดช ที่ใหเกียรติมาเปนอาจารย กรรมการในการตรวจสอบโครงงานเพื่อใหนิสิตเขาใจความรูตางๆไดอยาง สมบูรณและขอขอบพระคุณรุนพี่ที่ชวยเหลือและอำนวยความสะดวก ตางๆ ในการใชหองปฏิบัติการรวมถึงขอมูลที่เปนประโยชนในการทำ โครงงานนี้รวมทั้งผูมีสวนเกี่ยวของทุกทานที่มีสวนชวยในการใหคำปรึกษา ชี้แนะในโครงงานนี้

### 7. เอกสารอางอิง เอกสารอางอิง

T. Wisessri and C. Promsatarporn, ''Demonstration of Resonant Wireless Power Transfer using Toy Racing Cars and Tracks,'' B.Eng. Senior Project, Kasetsart University, Thailand, 2022.
C. Rakluea, A. Worapishet, S. Chaimool, Y. Zhao, and P. Akkaraekthalin, “True nulls-free magnetoinductive waveguides using alternate coupling polarities for batteryless dynamic wireless power transfer applications,” IEEE Trans. Power Electron., vol. 37, no. 8, pp. 8835–8854, 2022.
“วงจรเรียงกระแส คืออะไร?,” ชางไฟดอทคอม | ทีมงานชางไฟฟาที่ดีที่สุด
ใน ก รุงเท พ ฯ, 18-Nov-2021. [Online]. Available: https://www.changfi.com/ fix/2021/11/18/14296/. [Accessed: 11-Oct-2023].
Digikey.co.th. [Online]. Available: https://www.digikey.co.th/th/articles/the-smith-chart-an-ancient-graphical-tool-still-vital-in-rf-design. [Accessed: 29-Mar -2024].
