dcwaiot/KU-WPT/2022/data/VDO, Picture/AMPLIFIER.jpg

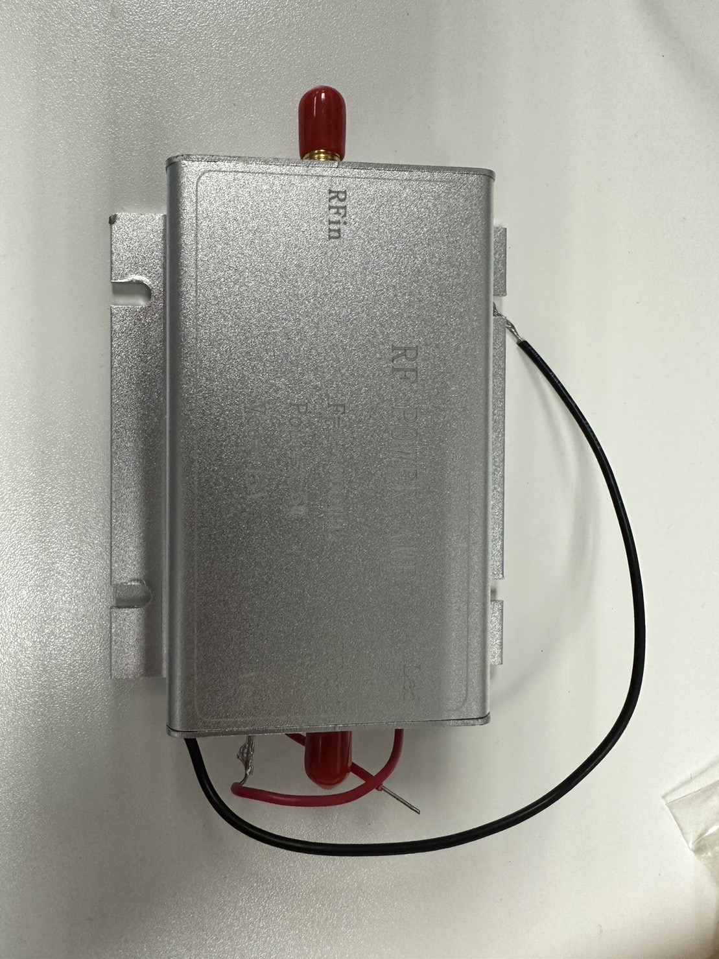
2022/data/VDO, Picture/AMPLIFIER.jpg
