dcwaiot/KU-WPT/2022/data/VDO, Picture/ATTENUATOR.jpg

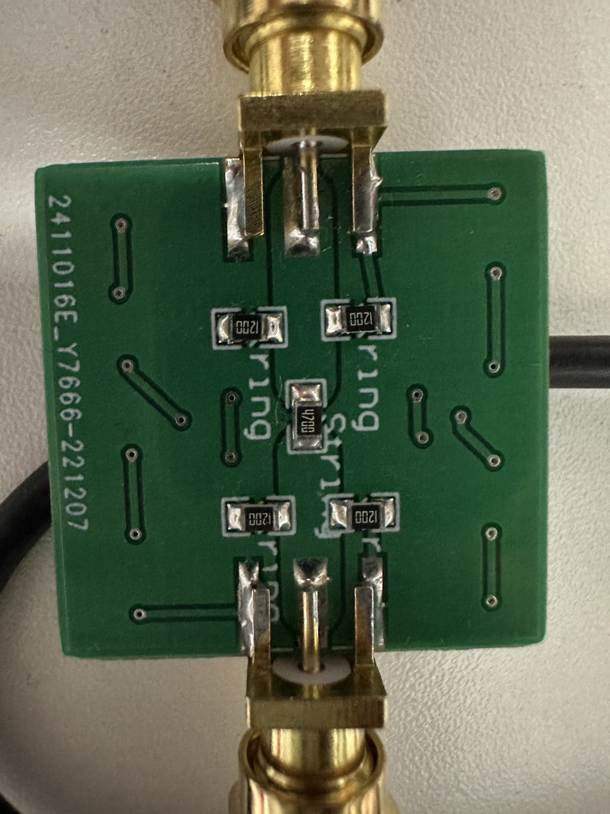
2022/data/VDO, Picture/ATTENUATOR.jpg
