dcwaiot/KU-WPT/2022/data/VDO, Picture/N20_MOTOR.jpg

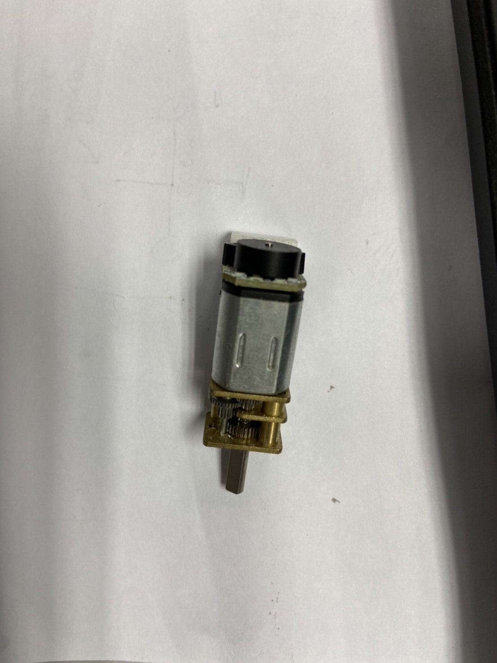
2022/data/VDO, Picture/N20_MOTOR.jpg
