dcwaiot/KU-WPT/2022/data/VDO, Picture/RxCOIL.jpg

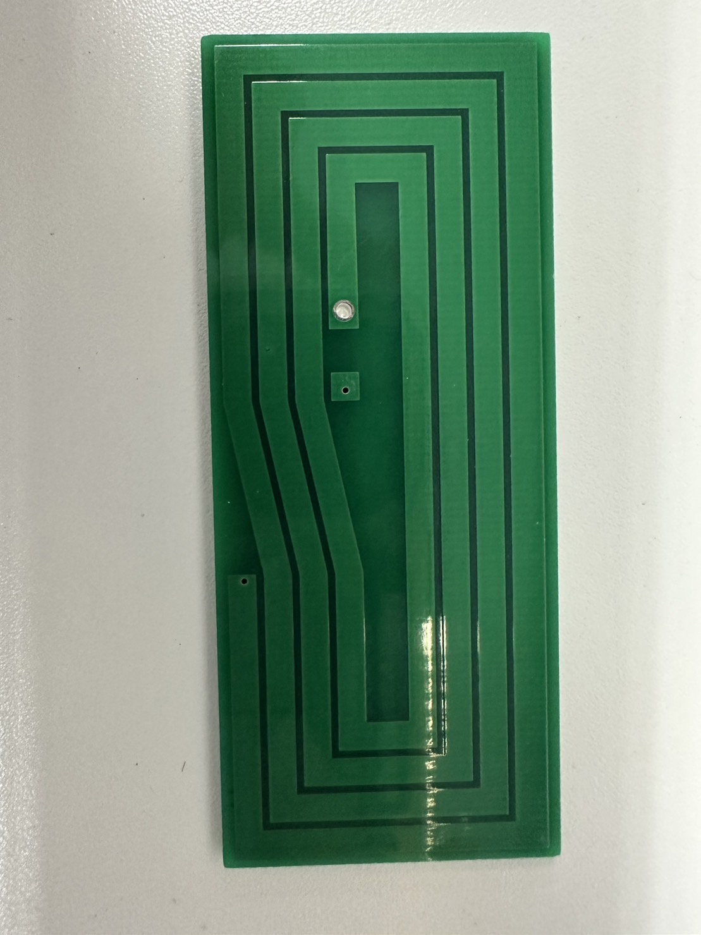
2022/data/VDO, Picture/RxCOIL.jpg
