dcwaiot/KU-WPT/2022/data/VDO, Picture/TxCOIL.jpg

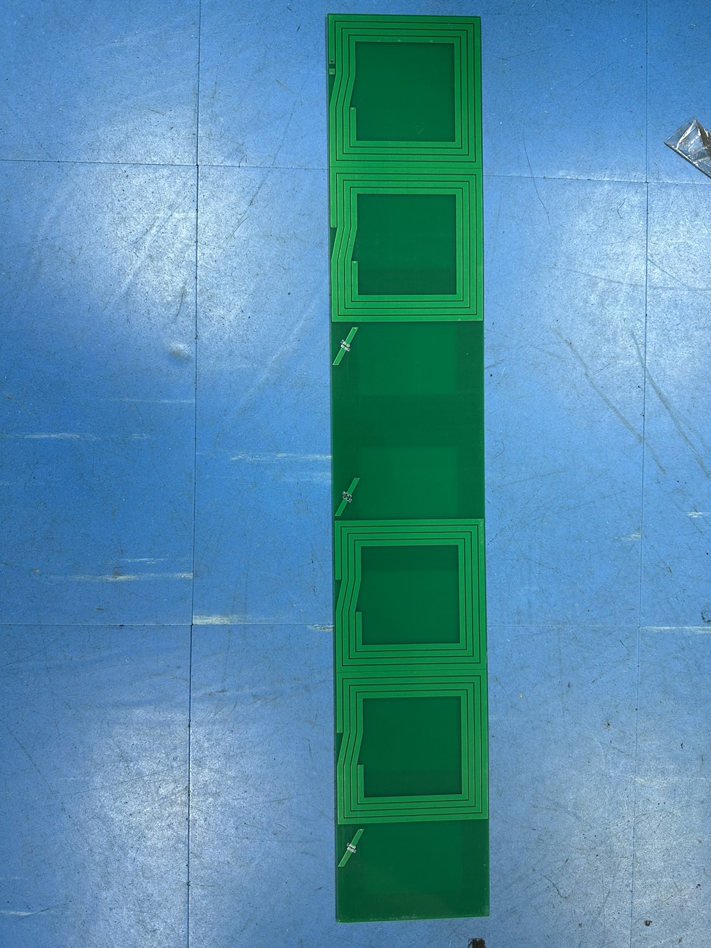
2022/data/VDO, Picture/TxCOIL.jpg
