dcwaiot/KU-WPT/2022/data/ขั้นตอนการจัดทำและซื้ออุปกรณ์ต่างๆ/Design_Order_Attenuator.docx

1. Draw circuit diagram for pi attenuator. We use Chip Resistors 0805 and SMA connector.

2. Change circuit diagram to PCB board.

2.1 Setting size of PCB 1 inch x 1 inch.

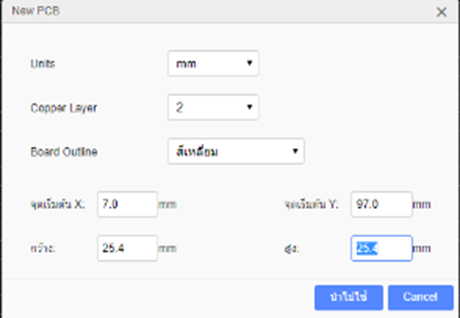
[picture p168: figure]

2.2 Place resistor and connector in PCB board.

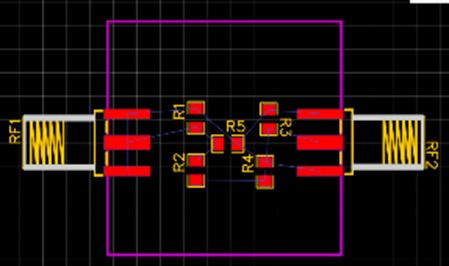
[picture p169: figure]

2.3 Draw a signal line and ground.

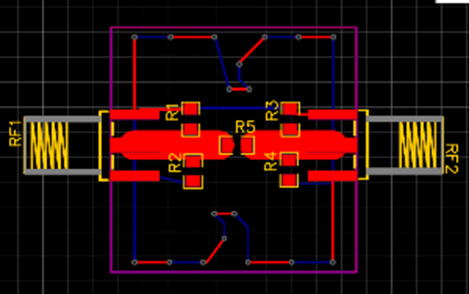
[picture p170: figure]

2.4 Place the copper area in the top layer and bottom layer

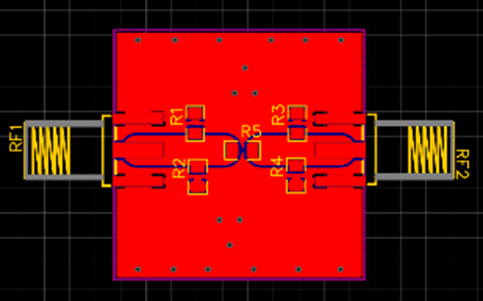
[picture p171: figure]

3. Export to altium designer file

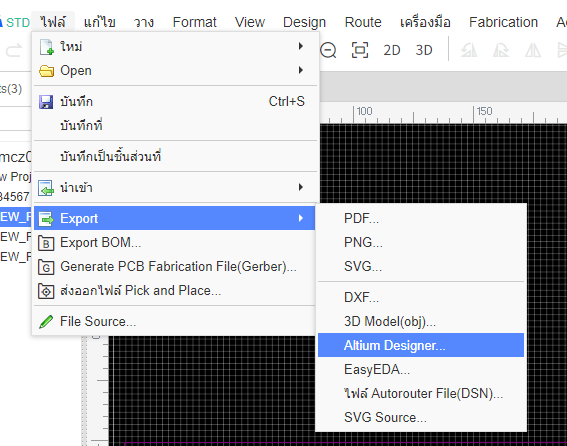
[picture p172: figure]

4. Sent file to facebook: Siam PCB
