dcwaiot/KU-WPT/2023/BOM List/DCW-02-2023-BOM.pdf

Number | Name | Bath/Unit | Amount | Price (Bath) | Perchase From | Link | Note
1 | TX Coil | 449.82 | 5 | 2,249.10 | JLCPCB | - | JLCPCB กําหนดการผลิตขั้นตํ่า 5 ชิ้น
2 | Test Coil | 246.54 | 5 | 1,232.70 | JLCPCB | - | JLCPCB กําหนดการผลิตขั้นตํ่า 5 ชิ้น
3 | Rectifier Circuit | 14.42 | 5 | 72.10 | JLCPCB | - | JLCPCB กําหนดการผลิตขั้นตํ่า 5 ชิ้น
4 | RX Coil | 28.83 | 5 | 144.15 | JLCPCB | - | JLCPCB กําหนดการผลิตขั้นตํ่า 5 ชิ้น
5 | คาจัดสง Coil และ Rectifier Circuit ของ DHL Express (รวมภาษีศุลกากรและภาษีมูลคาเพิ่ม) | 1,889.65 | 1 | 1,889.65 | DHL Express | -
6 | GA12-N20 มอเตอรเกียร gear motor smart car 12V 300RPM | 120.00 | 2 | 240.00 | CyberTise | https://www.cybertice.com/product/3418/ga12-n20-มอเตอรเกียร-gear-motor-smart-car-12v-300rpm | สั่งมาเพื่อสํารองไวอีก 1 อัน รายการนี้ไมไดนํามาใชงานในโครงงานวิศวกรรมไฟฟา KU-WPT-2023
7 | คาจัดสงของราน CyberTise | 50.00 | 1 | 50.00 | CyberTise | -
8 | (Power Amplifier ที่มีราคาถูกกวา) 2MHz-700MHZ 3W HF VHF UHF FM เครื่องสง RF Power Amplifier | 317.00 | 0 | 0.00 | Lazada | https://www.lazada.co.th/products/2mhz-700mhz-3w-hf-vhf-uhf-fm-rf-power-amplifier-i3618547882-s13562880278.html | Power Amplifier ที่มีราคาถูกกวา แตไมไดซื้อ
9 | Oscillator Circuit 13.56 MHz | 1,165.92 | 1 | 1,165.92 | Amazon | https://www.amazon.com/Transmit-Signal-13-56MHz-Adjustment-Generator/dp/B09YVN1J5T | รวมคาจัดสงและหักสวนลดจากคูปองแลว
10 | CBR06C620F5GAC - Capacitor, RF, C0G / NP0, 62 pF, 50 V, HiQ-CBR Series, ± 1%, 125 °C, 0603 [1608 Metric] 21.82 | | 10 | 218.20 | Element 14 | https://th.element14.com/kemet/cbr06c620f5gac/cap-62pf-50v-1-0603/dp/2809422 | ฟรีคาจัดสง และ บังคับสั่งขั้นตํ่า 10 ชิ้น และใชใน Tx Coil และ Test Coil
11 | C0805C181F1GACTU - SMD Multilayer Ceramic Capacitor, 180 pF, 100 V, 0805 [2012 Metric], ± 1%, C0G / NP0 10.44 | | 10 | 104.40 | Element 14 | https://th.element14.com/kemet/c0805c181f1gactu/cap-180pf-100v-1-c0g-np0-0805/dp/2820829 | ฟรีคาจัดสง และ บังคับสั่งขั้นตํ่า 10 ชิ้น และใชใน Rx Coil
12 | 10ZL2200MEFC12.5X20 - Electrolytic Capacitor, Miniature, 2200 µF, 10 V, ± 20%, Radial Leaded, 5000 hours @ 105°C, Polar 29.47 | | 1 | 29.47 | Element 14 | https://th.element14.com/rubycon/10zl2200mefc12-5x20/cap-2200-f-10v-20/dp/1144685 | ฟรีคาจัดสง และ ใชใน Rectifier
13 | 1N5819HW-7-F - DIODE, SCHOTTKY, 1A, 40V, SOD-123 | 9.60 | 4 | 38.40 | Element 14 | https://th.element14.com/multicomp-pro/1n5819hw-7-f/diode-schottky-1a-40v-sod-123/dp/2306459 | ฟรีคาจัดสง
14 | Ball Bearing ขนาด 6 มม. | 15.00 | 10 | 150.00 | item6565 | https://shopee.co.th/รถกระปอง-ลูกปนลอ-6mm.-(2×6×2.5-mm.)-สําหรับ-Tamiya-Mini4wd-i.273835220.5858960821 | ใช 7 ชิ้น (สํารอง 3 ชิ้น) ฟรีคาจัดสง
15 | ยาง O-Ring แบน ขนาด 30 มม. หนา 2 มม. | 3.00 | 10 | 30.00 | JPMat | https://shopee.co.th/ลูกยางยูเนี่ยน-ประเก็นยาง-ราคา-ตอ-5-วง-สําหรับขอตอยูเนี่ยนเหล็ก-สแตนเลส-หรือ-สําหรับงาน-DIY-อื่นๆ-มีหลายขนาดใหเลือก-1--i.166980241.15511872108 | ขายเปนชุด ชุดละ 5 วง ฟรีคาจัดสง
16 | ยาง O-Ring แบน ขนาด 15 มม. หนา 3 มม. | 3.00 | 10 | 30.00 | JPMat | https://shopee.co.th/5-วง-ลูกยางแบน-โอริง-มีหลายขนาดใหเลือก-สําหรับงานกันนํ้าซึม-งาน-DIY-ตางๆ-ตองการสินคาอื่นกดดูในรานเลยครับ-i.166980241.20365072182 | ขายเปนชุด ชุดละ 5 วง ฟรีคาจัดสง
17 | Power Amplifier ที่มีราคาสูงกวา | 864.60 | 1 | 864.60 | Lazada | 2MHz-700MHZ RF Power Amplifier Broadband RF Power Amplification For HF VHF UHF FM Transmitter Radio | Lazada.co.th (https://www.lazada.co.th/products/2mhz-700mhz-rf-power-amplifier-broadband-rf-power-amplification-for-hf-vhf-uhf-fm-transmitter-radio-i3401042324-s12573814688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) | รวมคาจัดสงและหักสวนลดจากคูปองแลว และใชในโครงงานวิศวกรรมไฟฟา KU-WPT-2023
18 | N20 มอเตอรขนาด 3V-12V เปน Mini Motor มอเตอรเกียรชนิดโลหะ แกนสั้น | 35.00 | 0 | 0.00 | shopee | N20 มอเตอรขนาด 3V-12V เปน Mini Motor มอเตอรเกียรชนิดโลหะ สินคาพรอมสง!!! | Shopee Thailand (https://shopee.co.th/product/145695802/10735309613?gad_source=1) | มอเตอรรุนนี้ ในโครงงาน KU-WPT-2023 ไมไดซื้อ แตดึงจากอุปกรณที่มีอยูแลว มาใชงาน
Discount Coupon from JLCPCB | 360.44 | Bath | Total | 8,148.25 | Bath
