dcwaiot/KU-WPT/2023/BOM List/BOM List - WPT Project.xlsx

Number | Name |  |  | Bath/Unit | Amount | Price (Bath) | Perchase From | Link | Note
1 | TX Coil |  |  | 449.82 | 5 | 2249.10 | JLCPCB | - | JLCPCB กำหนดการผลิตขั้นต่ำ 5 ชิ้น
2 | Test Coil |  |  | 246.54 | 5 | 1232.70 | JLCPCB | - | JLCPCB กำหนดการผลิตขั้นต่ำ 5 ชิ้น
3 | Rectifier Circuit |  |  | 14.42 | 5 | 72.10 | JLCPCB | - | JLCPCB กำหนดการผลิตขั้นต่ำ 5 ชิ้น
4 | RX Coil |  |  | 28.83 | 5 | 144.15 | JLCPCB | - | JLCPCB กำหนดการผลิตขั้นต่ำ 5 ชิ้น
5 | ค่าจัดส่ง Coil และ Rectifier Circuit ของ DHL Express (รวมภาษีศุลกากรและภาษีมูลค่าเพิ่ม) |  |  | 1889.65 | 1 | 1889.65 | DHL Express | -
6 | GA12-N20 มอเตอร์เกียร์ gear motor smart car 12V 300RPM |  |  | 120.00 | 2 | 240.00 | CyberTise | https://www.cybertice.com/product/3418/ga12-n20-%E0%B8%A1%E0%B8%AD%E0%B9%80%E0%B8%95%E0%B8%AD%E0%B8%A3%E0%B9%8C%E0%B9%80%E0%B8%81%E0%B8%B5%E0%B8%A2%E0%B8%A3%E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 | สั่งมาเพื่อสำรองไว้อีก 1 อัน รายการนี้ไม่ได้นำมาใช้งานในโครงงานวิศวกรรมไฟฟ้า KU-WPT-2023
7 | ค่าจัดส่งของร้าน CyberTise |  |  | 50.00 | 1 | 50.00 | CyberTise | -
8 | (Power Amplifier ที่มีราคาถูกกว่า) 2MHz-700MHZ 3W HF VHF UHF FM เครื่องส่ง RF Power Amplifier สำหรับวิทยุ |  |  | 317.00 | 0 | 0.00 | Lazada | https://www.lazada.co.th/products/2mhz-700mhz-3w-hf-vhf-uhf-fm-rf-power-amplifier-i3618547882-s13562880278.html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 | Power Amplifier ที่มีราคาถูกกว่า แต่ไม่ได้ซื้อ
9 | Oscillator Circuit 13.56 MHz |  |  | 1165.92 | 1 | 1165.92 | Amazon | https://www.amazon.com/Transmit-Signal-13-56MHz-Adjustment-Generator/dp/B09YVN1J5T | รวมค่าจัดส่งและหักส่วนลดจากคูปองแล้ว
10 | CBR06C620F5GAC - Capacitor, RF, C0G / NP0, 62 pF, 50 V, HiQ-CBR Series, ± 1%, 125 °C, 0603 [1608 Metric] |  |  | 21.82 | 10 | 218.20 | Element 14 | https://th.element14.com/kemet/cbr06c620f5gac/cap-62pf-50v-1-0603/dp/2809422 | ฟรีค่าจัดส่ง และ บังคับสั่งขั้นต่ำ 10 ชิ้น และใช้ใน Tx Coil และ Test Coil
11 | C0805C181F1GACTU - SMD Multilayer Ceramic Capacitor, 180 pF, 100 V, 0805 [2012 Metric], ± 1%, C0G / NP0 |  |  | 10.44 | 10 | 104.40 | Element 14 | https://th.element14.com/kemet/c0805c181f1gactu/cap-180pf-100v-1-c0g-np0-0805/dp/2820829 | ฟรีค่าจัดส่ง และ บังคับสั่งขั้นต่ำ 10 ชิ้น และใช้ใน Rx Coil
12 | 10ZL2200MEFC12.5X20 - Electrolytic Capacitor, Miniature, 2200 µF, 10 V, ± 20%, Radial Leaded, 5000 hours @ 105°C, Polar |  |  | 29.47 | 1 | 29.47 | Element 14 | https://th.element14.com/rubycon/10zl2200mefc12-5x20/cap-2200-f-10v-20/dp/1144685 | ฟรีค่าจัดส่ง และ ใช้ใน Rectifier
13 | 1N5819HW-7-F - DIODE, SCHOTTKY, 1A, 40V, SOD-123 |  |  | 9.60 | 4 | 38.40 | Element 14 | https://th.element14.com/multicomp-pro/1n5819hw-7-f/diode-schottky-1a-40v-sod-123/dp/2306459 | ฟรีค่าจัดส่ง
14 | Ball Bearing ขนาด 6 มม. |  |  | 15.00 | 10 | 150.00 | item6565 | https://shopee.co.th/%E0%B8%A3%E0%B8%96%E0%B8%81%E0%B8%A3%E0%B8%B0%E0%B8%9B%E0%B9%8B%E0%B8%AD%E0%B8%87-%E0%B8%A5%E0%B8%B9%E0%B8%81%E0%B8%9B%E0%B8%B7%E0%B8%99%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 | ใช้ 7 ชิ้น (สำรอง 3 ชิ้น) ฟรีค่าจัดส่ง
15 | ยาง O-Ring แบน ขนาด 30 มม. หนา 2 มม. |  |  | 3.00 | 10 | 30.00 | JPMat | https://shopee.co.th/%E0%B8%A5%E0%B8%B9%E0%B8%81%E0%B8%A2%E0%B8%B2%E0%B8%87%E0%B8%A2%E0%B8%B9%E0%B9%80%E0%B8%99%E0%B8%B5%E0%B9%88%E0%B8%A2%E0%B8%99-%E0%B8%9B%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 | ขายเป็นชุด ชุดละ 5 วง ฟรีค่าจัดส่ง
16 | ยาง O-Ring แบน ขนาด 15 มม. หนา 3 มม. |  |  | 3.00 | 10 | 30.00 | JPMat | https://shopee.co.th/5-%E0%B8%A7%E0%B8%87-%E0%B8%A5%E0%B8%B9%E0%B8%81%E0%B8%A2%E0%B8%B2%E0%B8%87%E0%B9%81%E0%B8%9A%E0%B8%99-%E0%B9%82%E0%B8%AD%E0%B8%A3%E0%B8%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 | ขายเป็นชุด ชุดละ 5 วง ฟรีค่าจัดส่ง
17 | Power Amplifier ที่มีราคาสูงกว่า |  |  | 864.60 | 1 | 864.60 | Lazada | 2MHz-700MHZ RF Power Amplifier Broadband RF Power Amplification For HF VHF UHF FM Transmitter Radio | Lazada.co.th (https://www.lazada.co.th/products/2mhz-700mhz-rf-power-amplifier-broadband-rf-power-amplification-for-hf-vhf-uhf-fm-transmitter-radio-i3401042324-s12573814688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) | รวมค่าจัดส่งและหักส่วนลดจากคูปองแล้ว และใช้ในโครงงานวิศวกรรมไฟฟ้า KU-WPT-2023
18 | N20 มอเตอร์ ขนาด 3V-12V เป็น Mini Motor มอเตอร์เกียร์ ชนิดโลหะ แกนสั้น |  |  | 35.00 | 0 | 0.00 | shopee | N20 มอเตอร์ ขนาด 3V-12V เป็น Mini Motor มอเตอร์เกียร์ ชนิดโลหะ สินค้าพร้อมส่ง!!! | Shopee Thailand (https://shopee.co.th/product/145695802/10735309613?gad_source=1) | มอเตอร์รุ่นนี้ ในโครงงาน KU-WPT-2023 ไม่ได้ซื้อ แต่ดึงจากอุปกรณ์ที่มีอยู่แล้ว มาใช้งาน
Discount Coupon from JLCPCB |  | 360.44 | Bath | Total |  | 8148.25 | Bath
