dcwaiot/KU-WPT/2022/data/ขั้นตอนการจัดทำและซื้ออุปกรณ์ต่างๆ/cost.xlsx

Name | Purchase from | Amount | Price(BAHT) | Link
13.56Mhz RF Power Amplifier Transmitting Signal | eBay | 1 | 532.46 | https://www.ebay.com/itm/155473201389?chn=ps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
รางสำหรับแข่งรถ-TAMIYAแบบวงกลม | Shopee | 1 | 490 | https://shp.ee/2uacikx
รถTAMIYA (ตราเพชร)แบบยังไม่ประกอบ | Shopee | 1 | 99 | https://shp.ee/2sf4qm4
1-1000Mhz 2.5W RF Power Amplifier for Ham Radio | Lazada | 2 | 1269.6 | https://www.lazada.co.th/products/1-1000mhz-25w-rf-power-amplifier-for-hf-fm-transmitter-vhf-uhf-rf-ham-radio-i4462773982-s17980312332.html
Attenuator | siampcb | 5 | 481
Transmitter coil, Receiver coil | jlcpcb | 5 | 2200
SMA Cable 1meter | Shopee | 5 | 187 | https://shp.ee/ri5kdhs
SR3100 Diode | Electronic Source | 12 | 57.36 | https://www.es.co.th/detail.asp?prod=020400062
Ceramic Chip Cap 18pF | Electronic Source | 20 | 16.6 | https://www.es.co.th/detail.asp?prod=009202444
Ceramic Chip Cap 30pF | Electronic Source | 20 | 73.6 | https://www.es.co.th/detail.asp?prod=009200931
Ceramic Chip Cap 33pF | Electronic Source | 20 | 34.2 | https://www.es.co.th/detail.asp?prod=009202853
Ceramic Chip Cap 150pF | Electronic Source | 20 | 36.8 | https://www.es.co.th/detail.asp?prod=009202759
Resistor 0805 470 Ohms | Electronic Source | 100 | 11 | https://www.es.co.th/detail.asp?Prod=015018927
Resistor 0805 120 Ohms | Electronic Source | 100 | 8 | https://www.es.co.th/detail.asp?Prod=015018323
ค่าส่ง + Tax Electronic Source | Electronic Source | 1 | 170
RF Adapter Connector SMA | Shopee | 66 | 607 | https://shp.ee/mikdq4t
 |  | SUM | 6273.62
