dcwaiot/KU-WPT/2023/BOM List/ใบเสร็จ/Coil JLCPCB.pdf

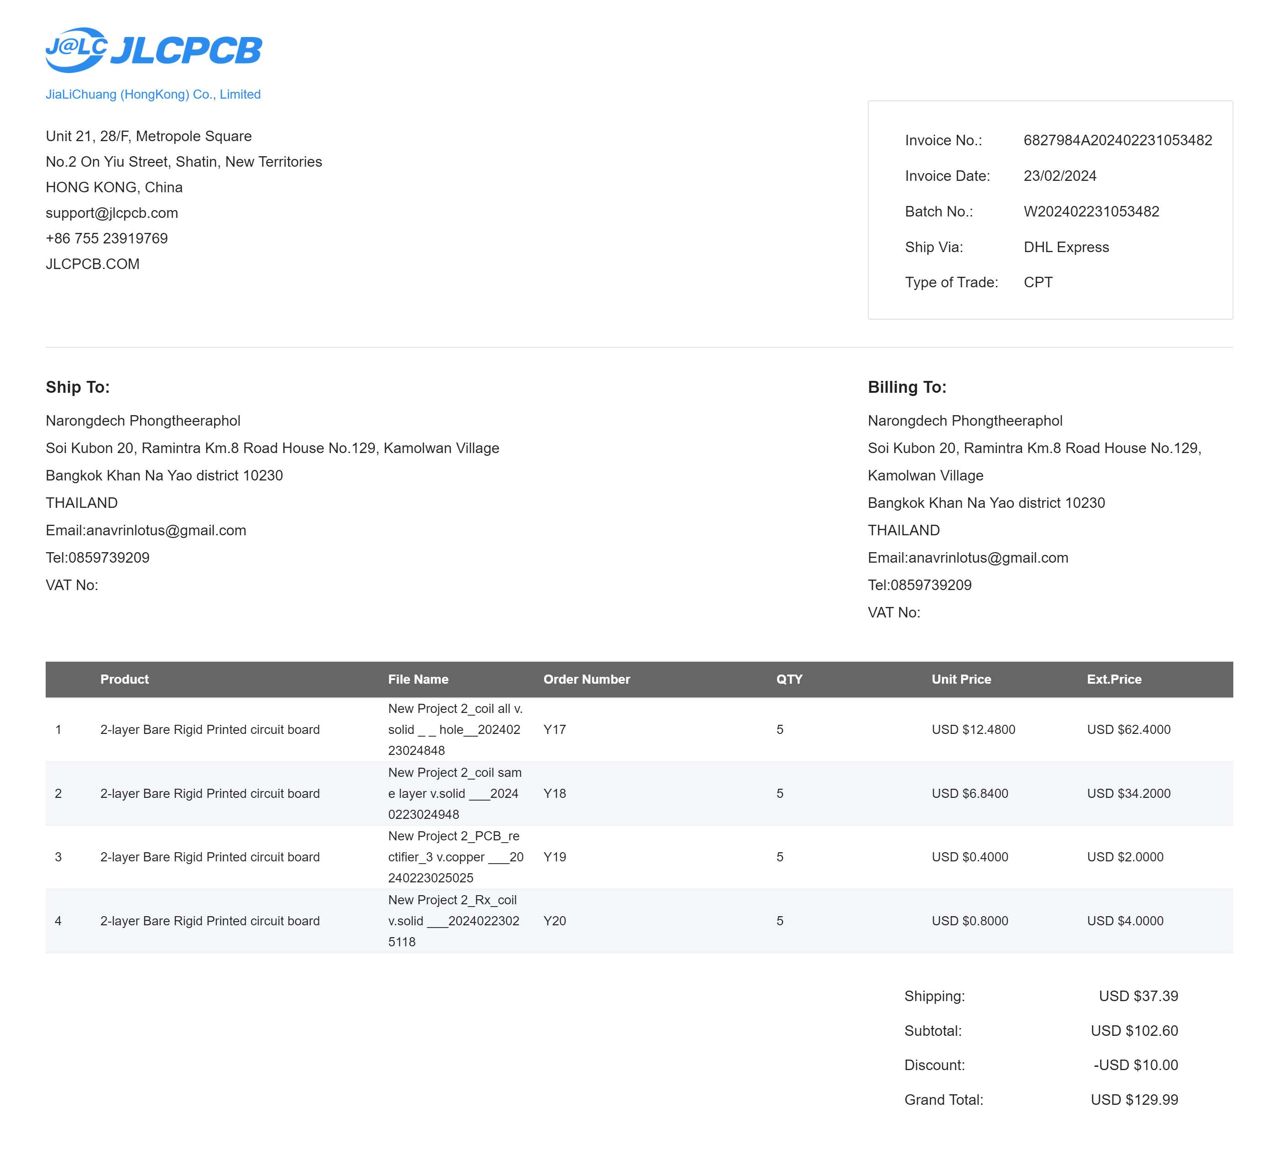
[picture p173: page 1]
