dcwaiot/KU-WPT/2023/3D Print/3MF/Track Base v8.3mf

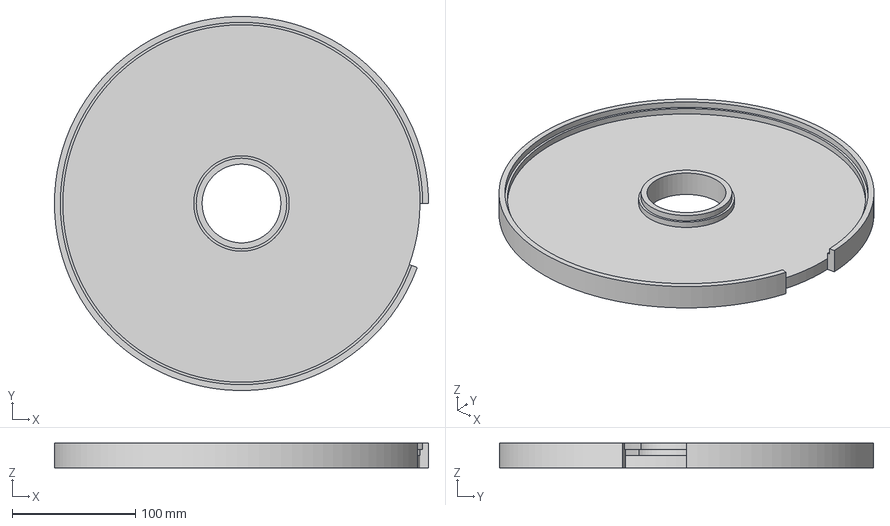
[picture p174: CAD file, 2024-04-06]
2023/3D Print/3MF/Track Base v8.3mf
304.0 x 303.9 x 20.0 mm
