dcwaiot/KU-WPT/2023/3D Print/3MF/Wheel-Motor v6.3mf

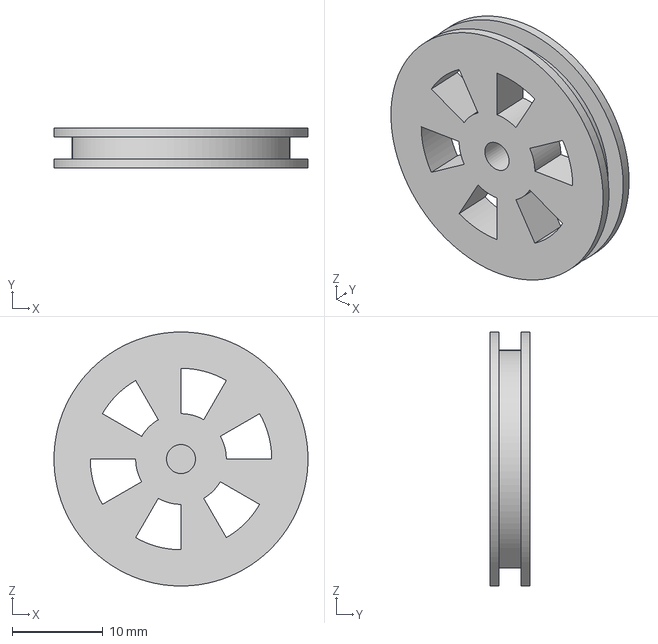
[picture p175: CAD file, 2024-04-06]
2023/3D Print/3MF/Wheel-Motor v6.3mf
28.0 x 4.40 x 28.0 mm
