dcwaiot/KU-WPT/2023/3D Print/3MF/Car v2.3mf

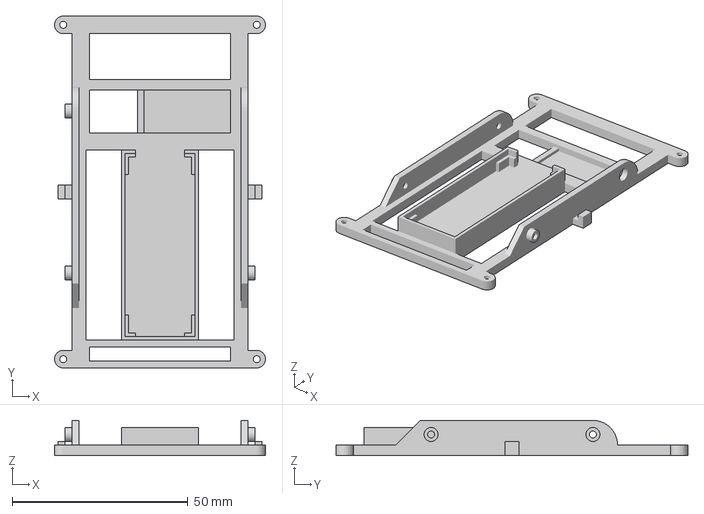
[picture p176: CAD file, 2024-04-06]
2023/3D Print/3MF/Car v2.3mf
60.0 x 100.0 x 10.0 mm
