dcwaiot/KU-WPT/2023/3D Print/3MF/Cubic Test v1.3mf

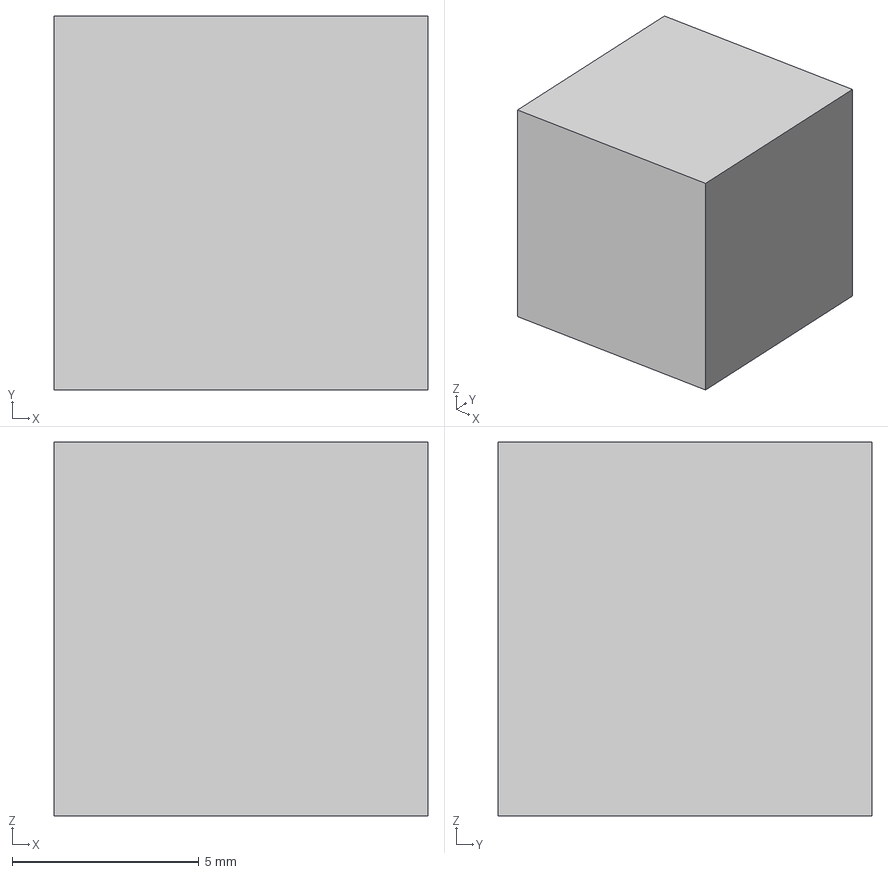
[picture p177: CAD file, 2024-04-06]
2023/3D Print/3MF/Cubic Test v1.3mf
10.0 x 10.0 x 10.0 mm
