dcwaiot/KU-WPT/2023/3D Print/3MF/Track v2.3mf

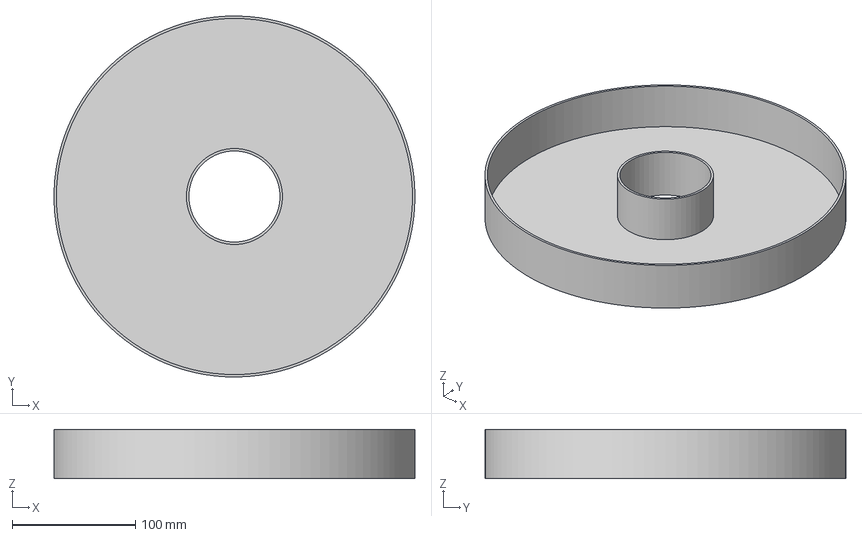
[picture p178: CAD file, 2024-04-06]
2023/3D Print/3MF/Track v2.3mf
293.1 x 293.2 x 40.0 mm
