dcwaiot/KU-WPT/2023/3D Print/3MF/Test v3.3mf

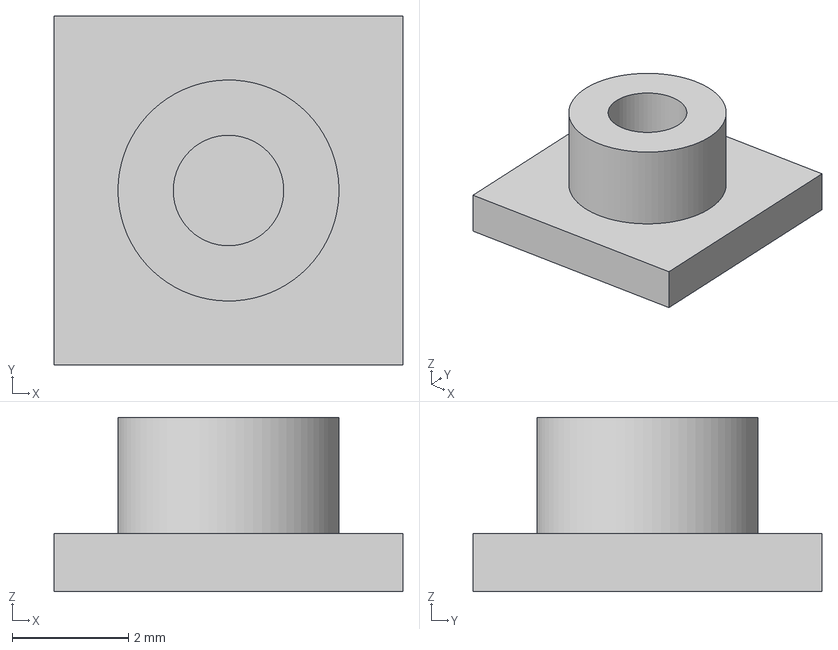
[picture p179: CAD file, 2024-04-06]
2023/3D Print/3MF/Test v3.3mf
6.00 x 6.00 x 3.00 mm
