dcwaiot/KU-WPT/2023/3D Print/3MF/Track Test v2.3mf

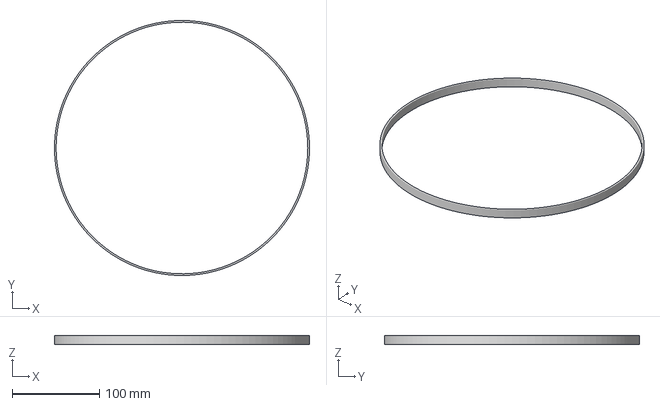
[picture p180: CAD file, 2024-04-06]
2023/3D Print/3MF/Track Test v2.3mf
292.7 x 292.8 x 10.0 mm
