dcwaiot/KU-WPT/2023/3D Print/3MF/Side Wheel v6.3mf

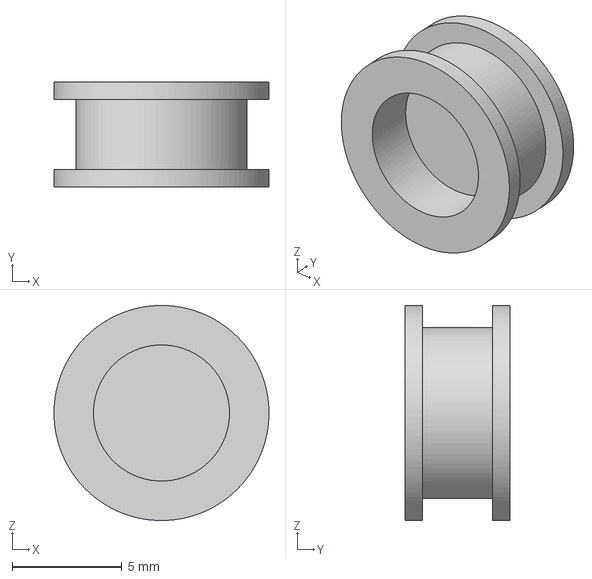
[picture p181: CAD file, 2024-04-06]
2023/3D Print/3MF/Side Wheel v6.3mf
9.80 x 4.80 x 9.80 mm
