dcwaiot/KU-WPT/(list of files, cad)

Other CAD files:
2023/3D Print/3MF/Wheel v8.3mf
2023/3D Print/Fusion 360/Car v2.f3d
2023/3D Print/Fusion 360/Cubic Test v1.f3d
2023/3D Print/Fusion 360/Side Wheel v6.f3d
2023/3D Print/Fusion 360/Test v3.f3d
2023/3D Print/Fusion 360/Track Base v8.f3d
2023/3D Print/Fusion 360/Track Test v2.f3d
2023/3D Print/Fusion 360/Track v2.f3d
2023/3D Print/Fusion 360/Wheel v8.f3d
2023/3D Print/Fusion 360/Wheel-Motor v6.f3d
2023/3D Print/STL/Car v2.stl
2023/3D Print/STL/Cubic Test v1.stl
2023/3D Print/STL/Side Wheel v6.stl
2023/3D Print/STL/Test v3.stl
2023/3D Print/STL/Track Base v8.stl
2023/3D Print/STL/Track Test v2.stl
2023/3D Print/STL/Track v2.stl
2023/3D Print/STL/Wheel v8.stl
2023/3D Print/STL/Wheel-Motor v6.stl
