dcwaiot/KU-WPT/2022/data/Sonnet/InstallationSonnet.docx

1. Download the program from the link provided.

https://downloadly.ir/software/engineering-specialized/sonnet-suite/

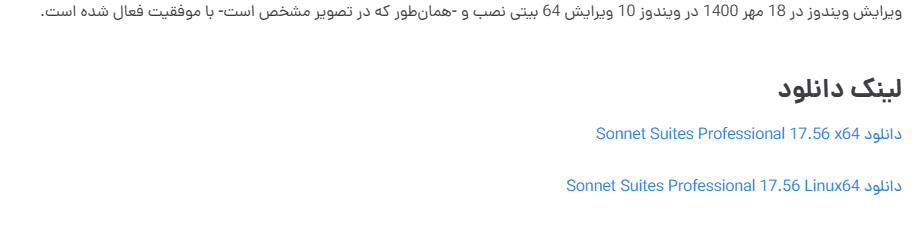
[picture p182: figure]

2. Once the file extraction is complete, proceed to set up Sonnet until it is complete.

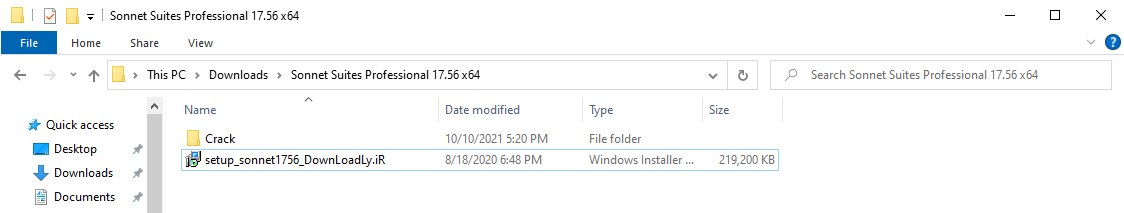
[picture p183: figure]

3. Search for "Virus & threat protection" in the Windows search bar and open it.

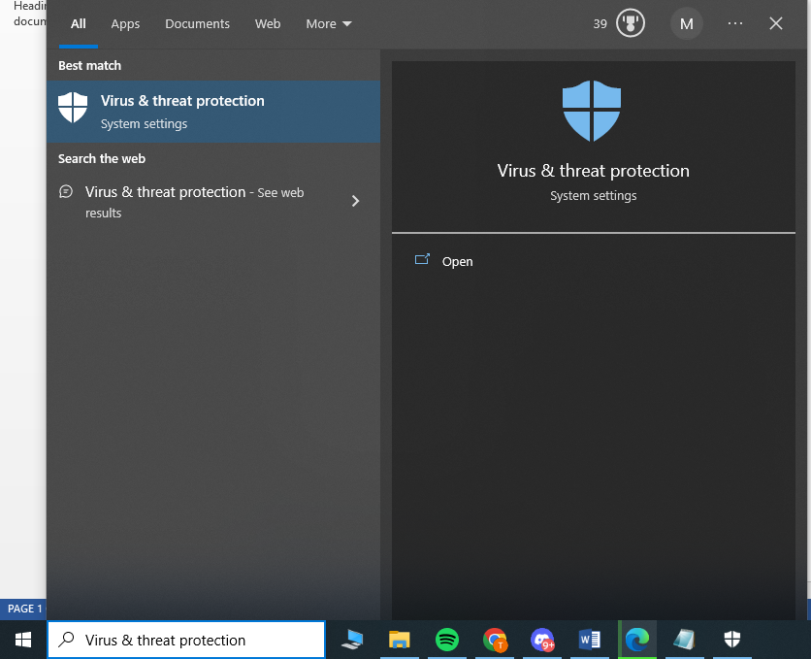
[picture p184: figure]
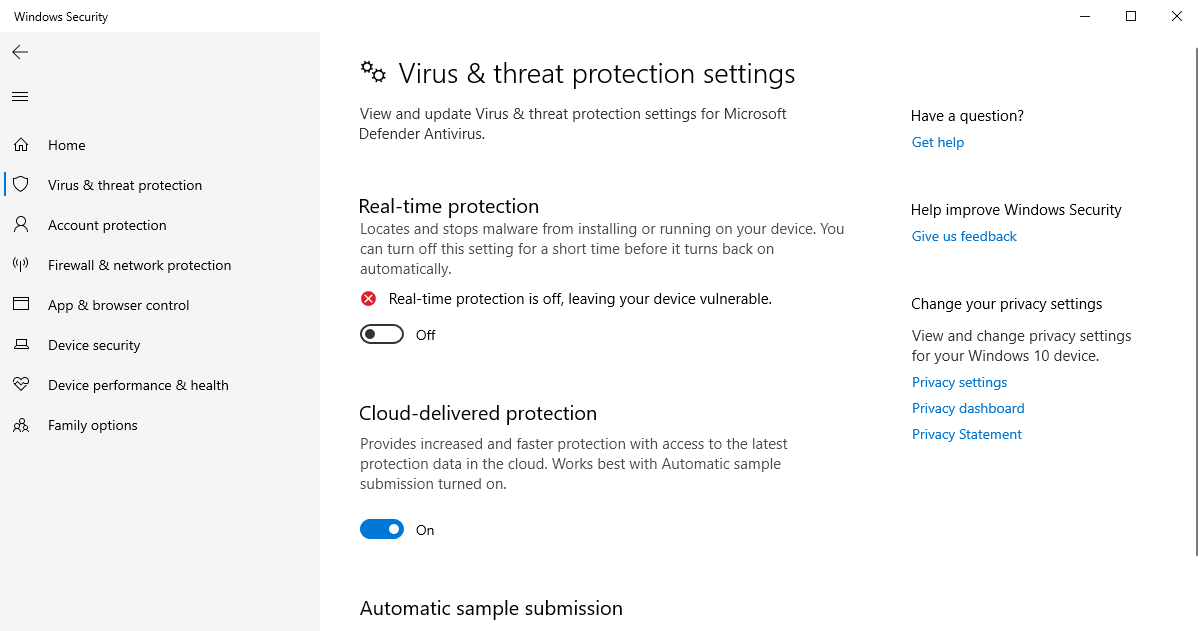
[picture p185: figure]

4. close Real-time protection

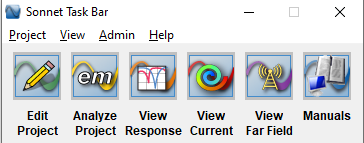
[picture p186: figure]

5. Run Sonnet to find the Host ID by selecting the "ADMIN" menu.

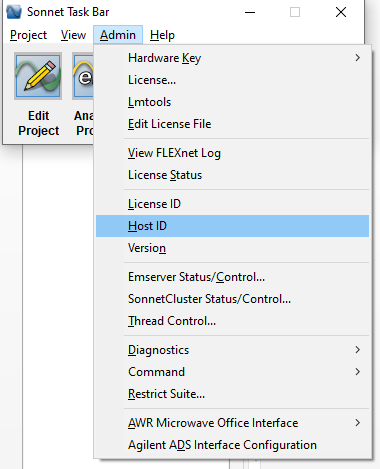
[picture p187: figure]

6. Choose Host ID

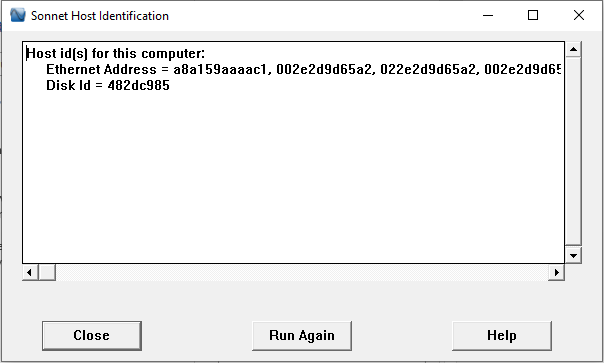
[picture p188: figure]

7. Open Crack folder
8. Run "sonnetd_nl_DownLoadLy.iR.src" file with Notepad
9. Change all "000000000000" with your machine HOST ID Save file

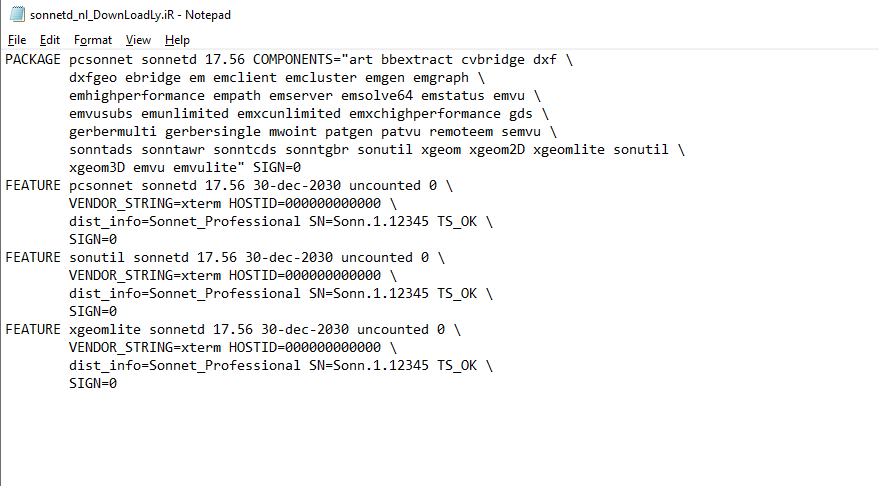
[picture p189: figure]
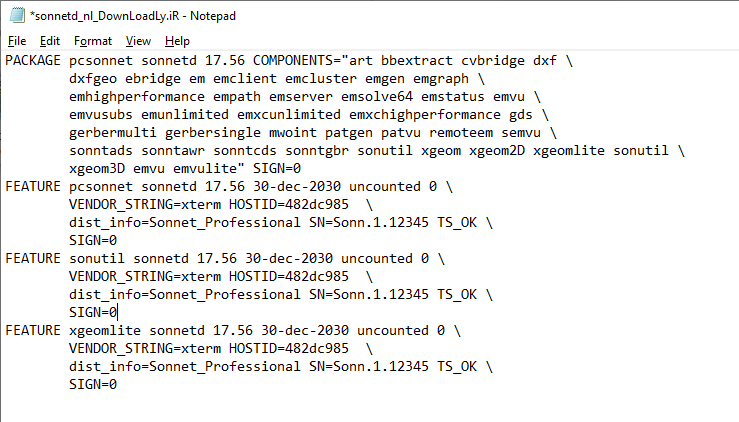
[picture p190: figure]

10. Run make_nodelocked.bat, it will make "sonnet_DownLoadLy.iR.lic"
11. Run app, in Admin Menu, select License

Click on Install "New License File" and browse to "sonnet_DownLoadLy.iR.lic"

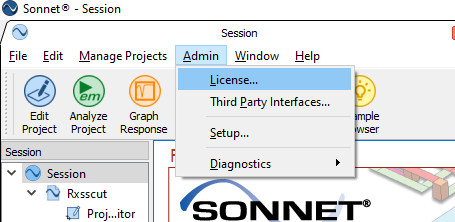
[picture p191: figure]
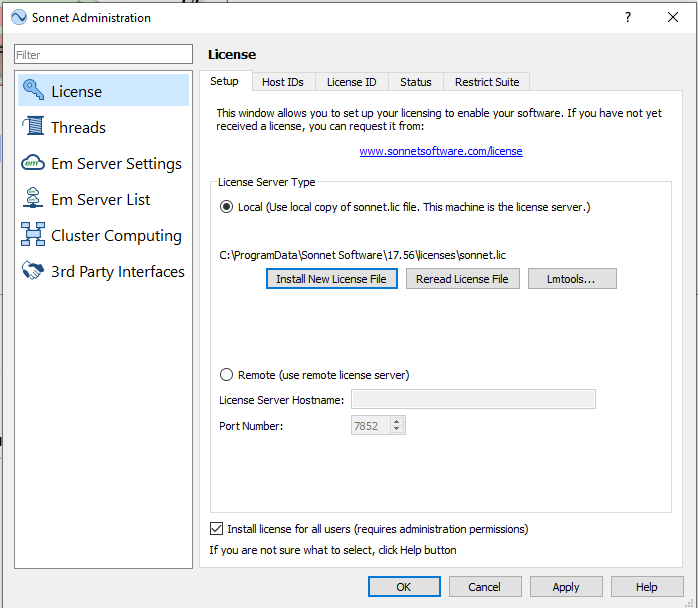
[picture p192: figure]
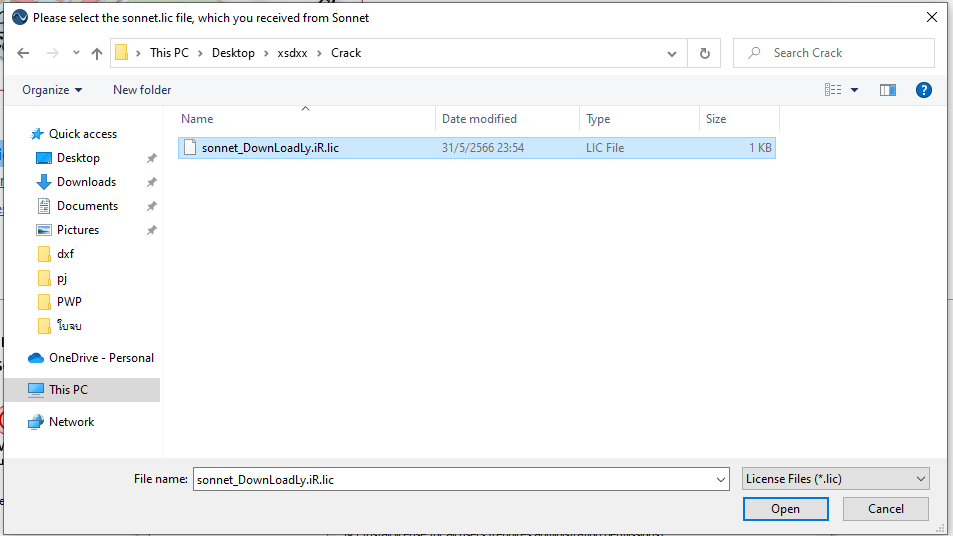
[picture p193: figure]
