dcwaiot/KU-WPT/(threads)

Thread 6 (2024-04-08):

Wireless Power Transfer

dcwaiot, 2024-04-08:
- Need 3-4 students for 2,000 baht $\times$ 3 (4) = 6,000 (8,000) baht.
- Install Sonnet in Ji's server.
- Prove idea of positive and negative coupling coefficient by changing direction of the turns.
- Adaptive matching network.
- Adaptive amplifier bias.
