dcwaiot/KU-WPT/(list of files, drawings)

Other design files:
2022/data/EasyEDA/Attenuator.json
2022/data/EasyEDA/Rx_coil.json
2022/data/EasyEDA/Tx_coil.json
2023/EasyEDA/coil all v.solid copy copy hole.json
2023/EasyEDA/coil same layer v.solid copy.json
2023/EasyEDA/PCB_rectifier_3 v.copper copy.json
2023/EasyEDA/Rx_coil v.solid copy.json
