dcwaiot/KU-WPT/(commit log)

2024-04-06 WPT 2023 - Electrical and PCB designs (#5)
    * เพิ่ม easyeda 2022
    * Update readme.md
    * Delete 2022/data/Design_Order_Attenuator.docx
    * Delete 2022/data/Design_Order_Attenuator.pdf
    * Delete 2022/data/Design_Order_Coil.docx
    * Delete 2022/data/Design_Order_Coil.pdf
    * Delete 2022/data/cost.xlsx
    * Create EasyEDA
    * Delete 2022/data/EasyEDA
    * Create Test
    * Delete 2022/data/EasyEDA/Test
    * Create EasyEDA
    * Add files via upload
    * Create Report
    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
    [Attenuator.json, BOM List - WPT Project.xlsx, PCB_rectifier_3 v.copper copy.json, Rx_coil v.solid copy.json, Rx_coil.json, Tx_coil.json, coil all v.solid copy copy hole.json, coil same layer v.solid copy.json]
2024-04-06 WPT 2023 - merge 3D models (#4)
    ---------
    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
    [Car v2.3mf, Car v2.f3d, Car v2.stl, Cubic Test v1.3mf, Cubic Test v1.f3d, Cubic Test v1.stl, Side Wheel v6.3mf, Side Wheel v6.f3d]
2024-04-08 add BOM in pdf format
